sjsoftware/centurion-cpu6/misc/CPU6_Functional.jpg

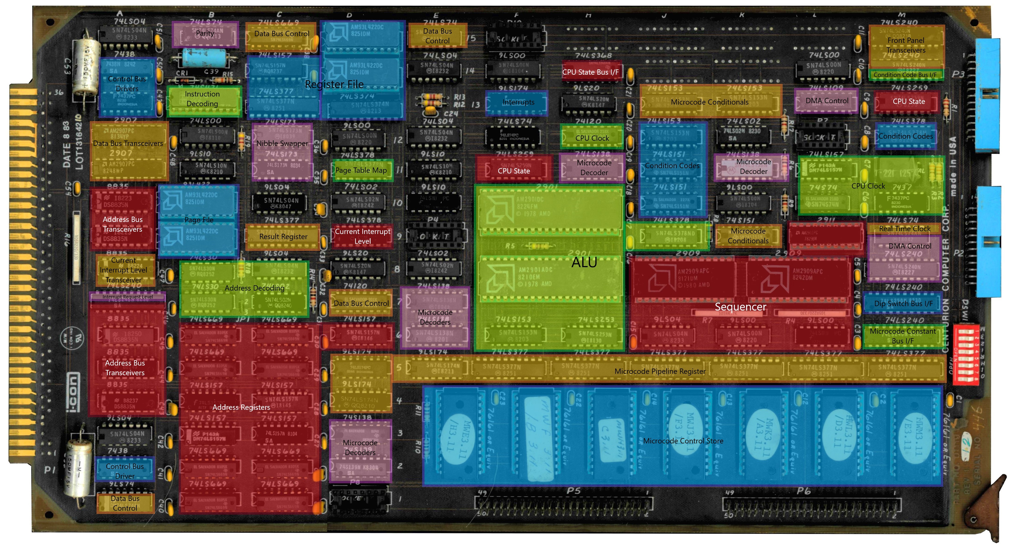
misc/CPU6_Functional.jpg
