sjsoftware/centurion-cpu6/README.md

# centurion-cpu6

* Schematic of the Centurion CPU6 board
* Schematic of the Centurion CPU5 boards
    * Original plus some revisions 
* Microcode disassembly (plus on wiki)
* Instruction reference (on wiki)
* Whatever I add in
