sjsoftware/centurion-cpu6/kicad/CPU5/README.md

# CPU 5 Reverse Engineering

Use at your own risk

The schematics are a bit of a mess, I wanted to get them to fit on A1 paper. If you have suggestions for
improvement, raise an issue.
