sjsoftware/centurion-cpu6/TODO.md

# TODO

An incomplete list of things

* Figure out CPU timing
* More documentation
* More disassembly
* More cards
