sjsoftware/centurion-cpu6/(threads)

Thread 5 (2022-04-28):

Add aliases for 7437, 7438 and '669

sjsoftware, 2022-04-28:
Replace LS versions and '169 in schematic

sjsoftware, 2022-06-13:
Done

Closed 2022-06-13.

Thread 6 (2022-05-12):

Schematic naming conventions

TemptorSent, 2022-05-12:
Renames for consistency, designation by grid location of pin1:

ALU0 (UF10) -> UF7 + label "ALU0"
ALU1 (UF11) -> UF9 + label "ALU1"

Seq0 (U?) -> UJ7 + label "Seq0"
Seq1 (U?) -> UK7 + label "Seq1"
Seq2 (UL9) -> UL9 + label "Seq2"

sjsoftware, 2022-06-13:
Board positions updated

Closed 2022-06-13.

Thread 7 (2023-10-10):

UE7 pins A0, A1 are label PL13, PL14 but are not actually wired.

charlesUnixPro, 2023-10-10:
UE7 pins A0, A1 are label PL13, PL14 but are not actually wired.
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

sjsoftware, 2023-11-11:
Fixed labels

Closed 2023-11-11.

Thread 8 (2023-10-13):

6309 pin names.

charlesUnixPro, 2023-10-13:
The 6309 at UB13 has pins 15 and 16 labeled "E1" and "E2".

According to "1978 MMI Bipolar LSI Databook, 1 t ed.", the should be "/E1" and "/E2"  ("NOT Enable").

sjsoftware, 2023-11-11:
Fixed symbol

Closed 2023-11-11.
