sjsoftware/centurion-cpu6/pdf/CPU5PA.pdf

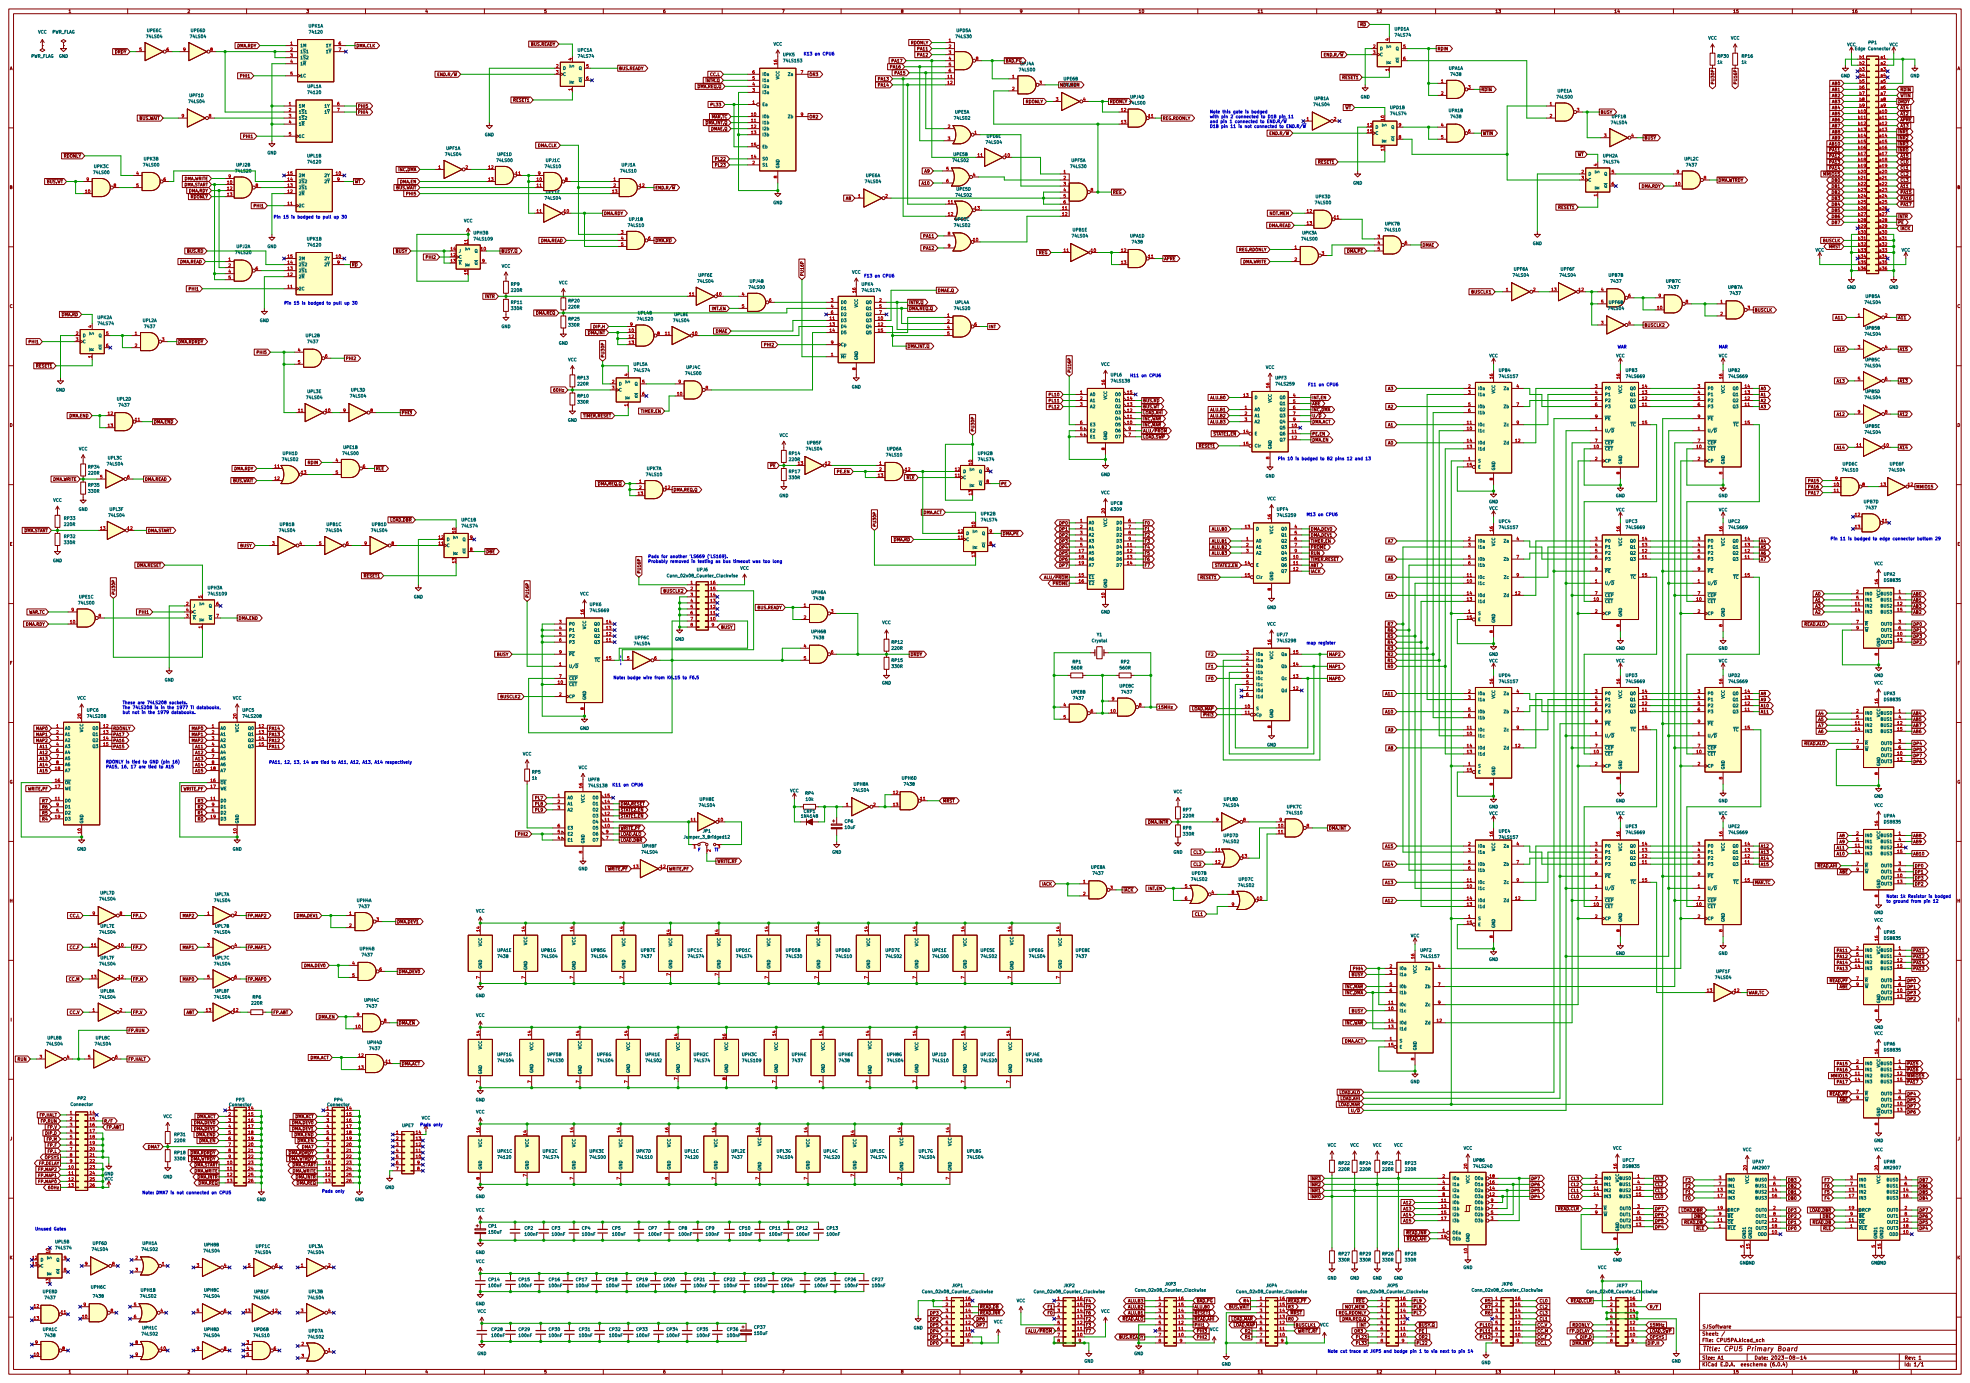
[picture p2: page 1]

~{DMA.REQ.Q} PL33 BUS.READY

~{DMA.INT.Q} CC.L ~{MAR.TC}
~{INTR.Q}

Note this gate is bodged
with pin 2 connected to D1B pin 11
and pin 1 connected to END.R/~{W}
D1B pin 11 is not connected to END.R/~{W}

DMA.START DMA.WRITE

Pin 15 is bodged to pull up 30

~{BUS.RD} DMA.READ

Pin 10 is bodged to B2 pins 12 and 13 M13 on CPU6 Note: bodge wire from K6.15 to F6.5 These are 74LS208 sockets. The 74LS208 is in the 1977 TI databooks, but not in the 1979 databooks.

ALU/~{PROM} DP2 DP3 DP1 DP4 DP0 WRITE.PF A12 A13

Pin 11 is bodged to edge connector bottom 29

~{TIMER.RESET} ABT RUN

F RDONLY is tied to GND (pin 16) PA15, 16, 17 are tied to A15

PA11, 12, 13, 14 are tied to A11, A12, A13, A14 respectively

~{MAR.TC} A15 WAR.TC

Note: 1k Resistor is bodged
to ground from pin 12

FP.HALT
~{READ.DB} FP.RUN
FP.V DIP.D

~{DMA.WTRDY}
~{DMA.START}
~{DMA.INTR} DMA.WRITE

~{DMA.START} DMA.WRITE

Note: DMA7 is not connected on CPU5

~{DMA.INT} FP.DELAY

Note cut trace at JKP5 and bodge pin 1 to via next to pin 14

Id: 1/1 Title: CPU5 Primary Board
