sjsoftware/centurion-cpu6/pdf/CPU5SA.pdf

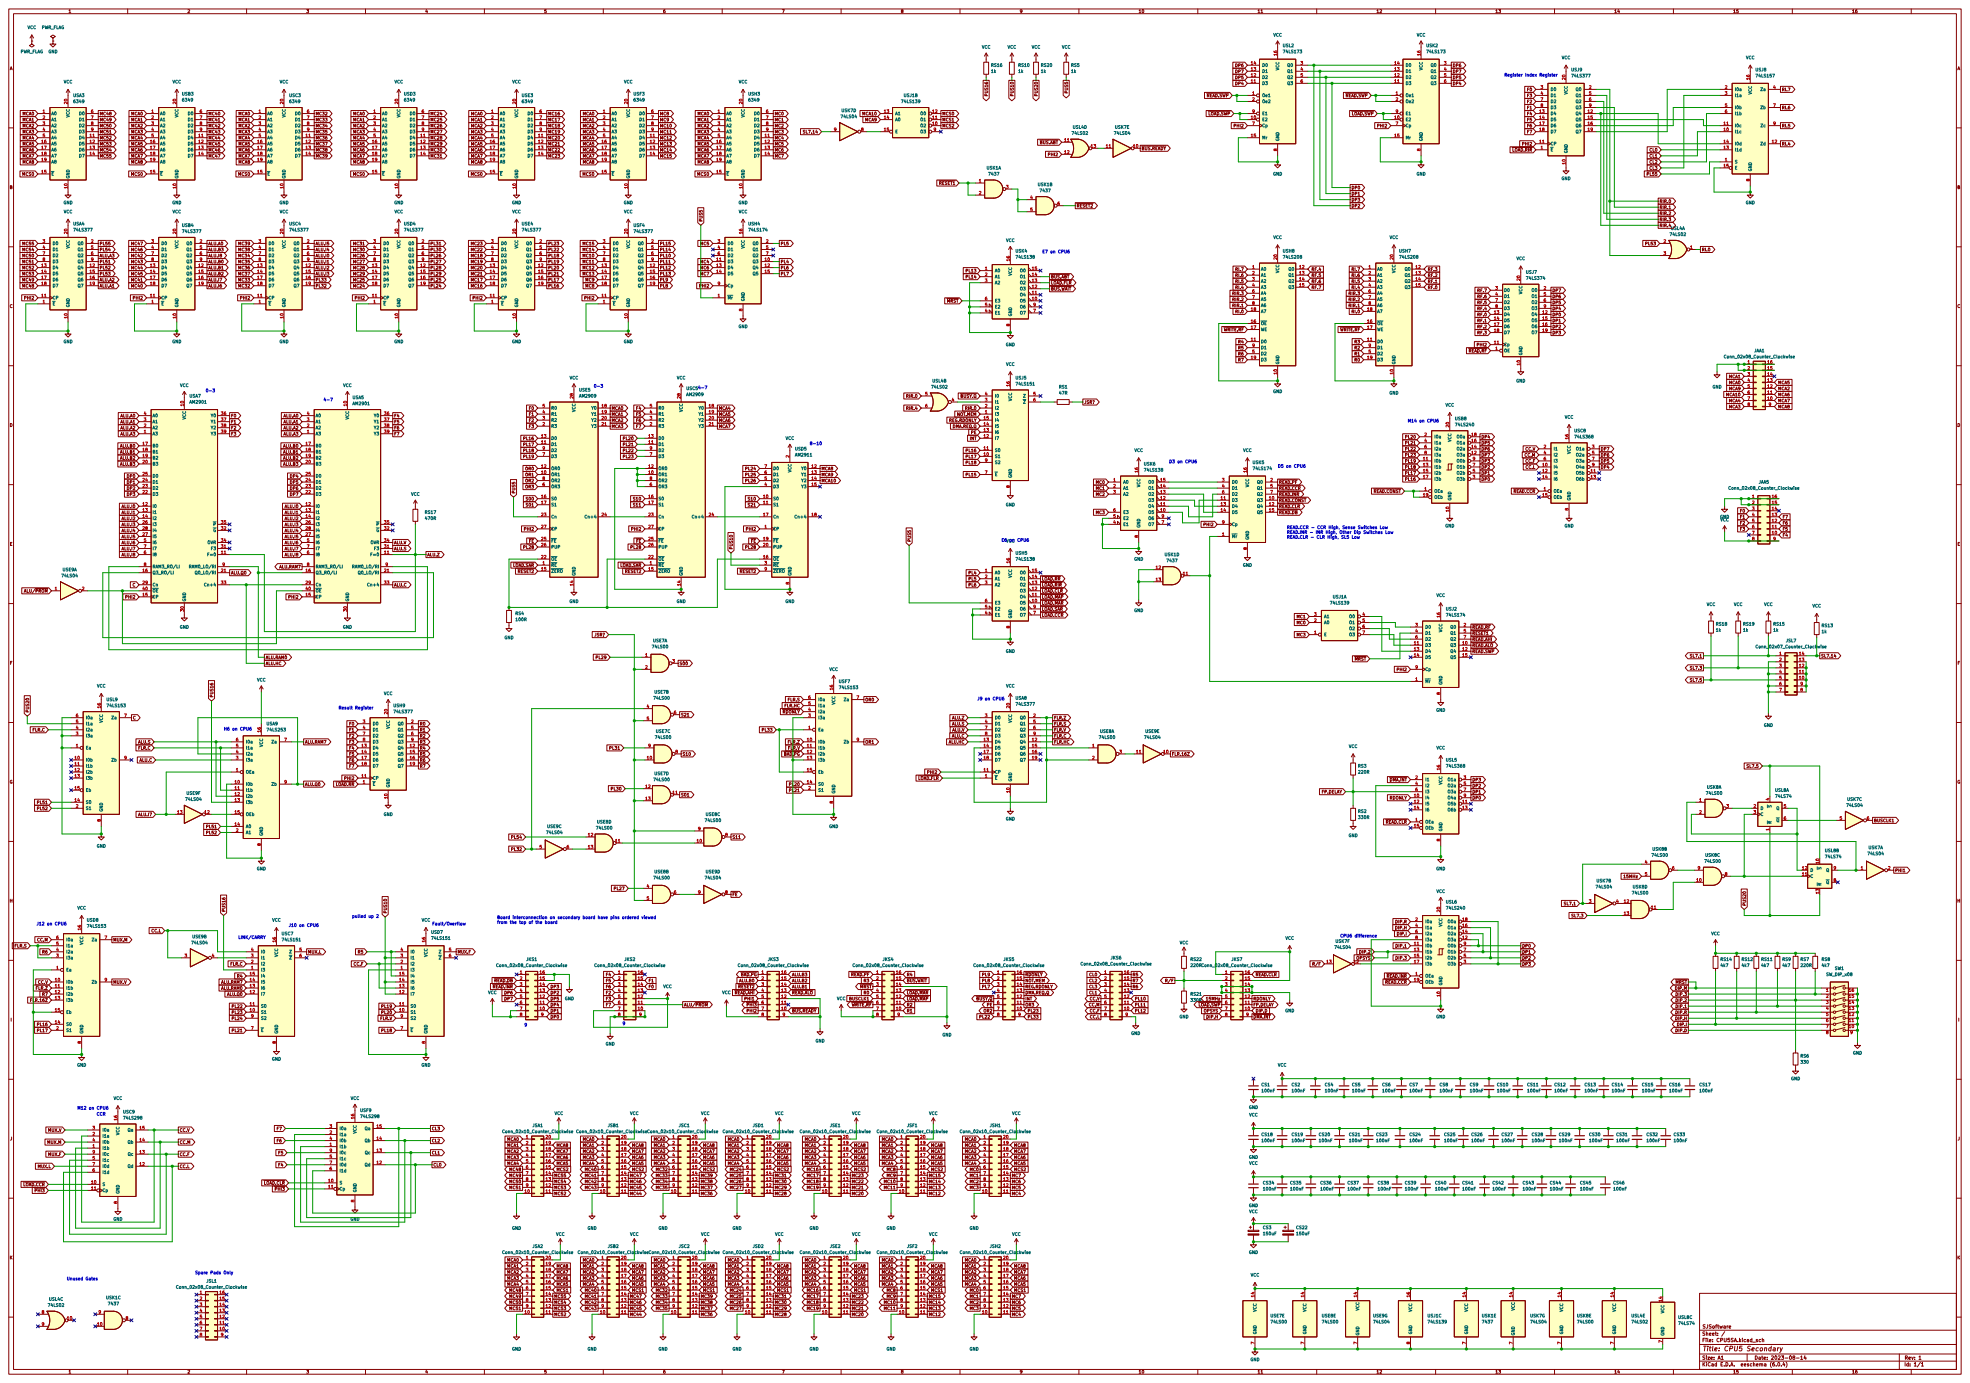
[picture p3: page 1]

Register Index Register E7 on CPU6

ALU.A0 ALU.I8 ALU.B3 ALU.B0 MC49 MC54

CL1 CL2 CL0 RIR.2 RIR.3 RIR.1 RIR.0

~{READ.CCR} CC.L CC.M

READ.CCR - CCR High, Sense Switches Low
READ.INR - INR High, Other Dip Switches Low

ALU.I5 ALU.I8 ALU.I6 ALU.I7 ALU.RAM7

Board interconnection on secondary board have pins ordered viewed
from the top of the board

CC.L ~{LOAD.CCR} MUX.LMUX.F

Spare Pads Only Unused Gates
