sjsoftware/centurion-cpu6/pdf/CPU6.pdf

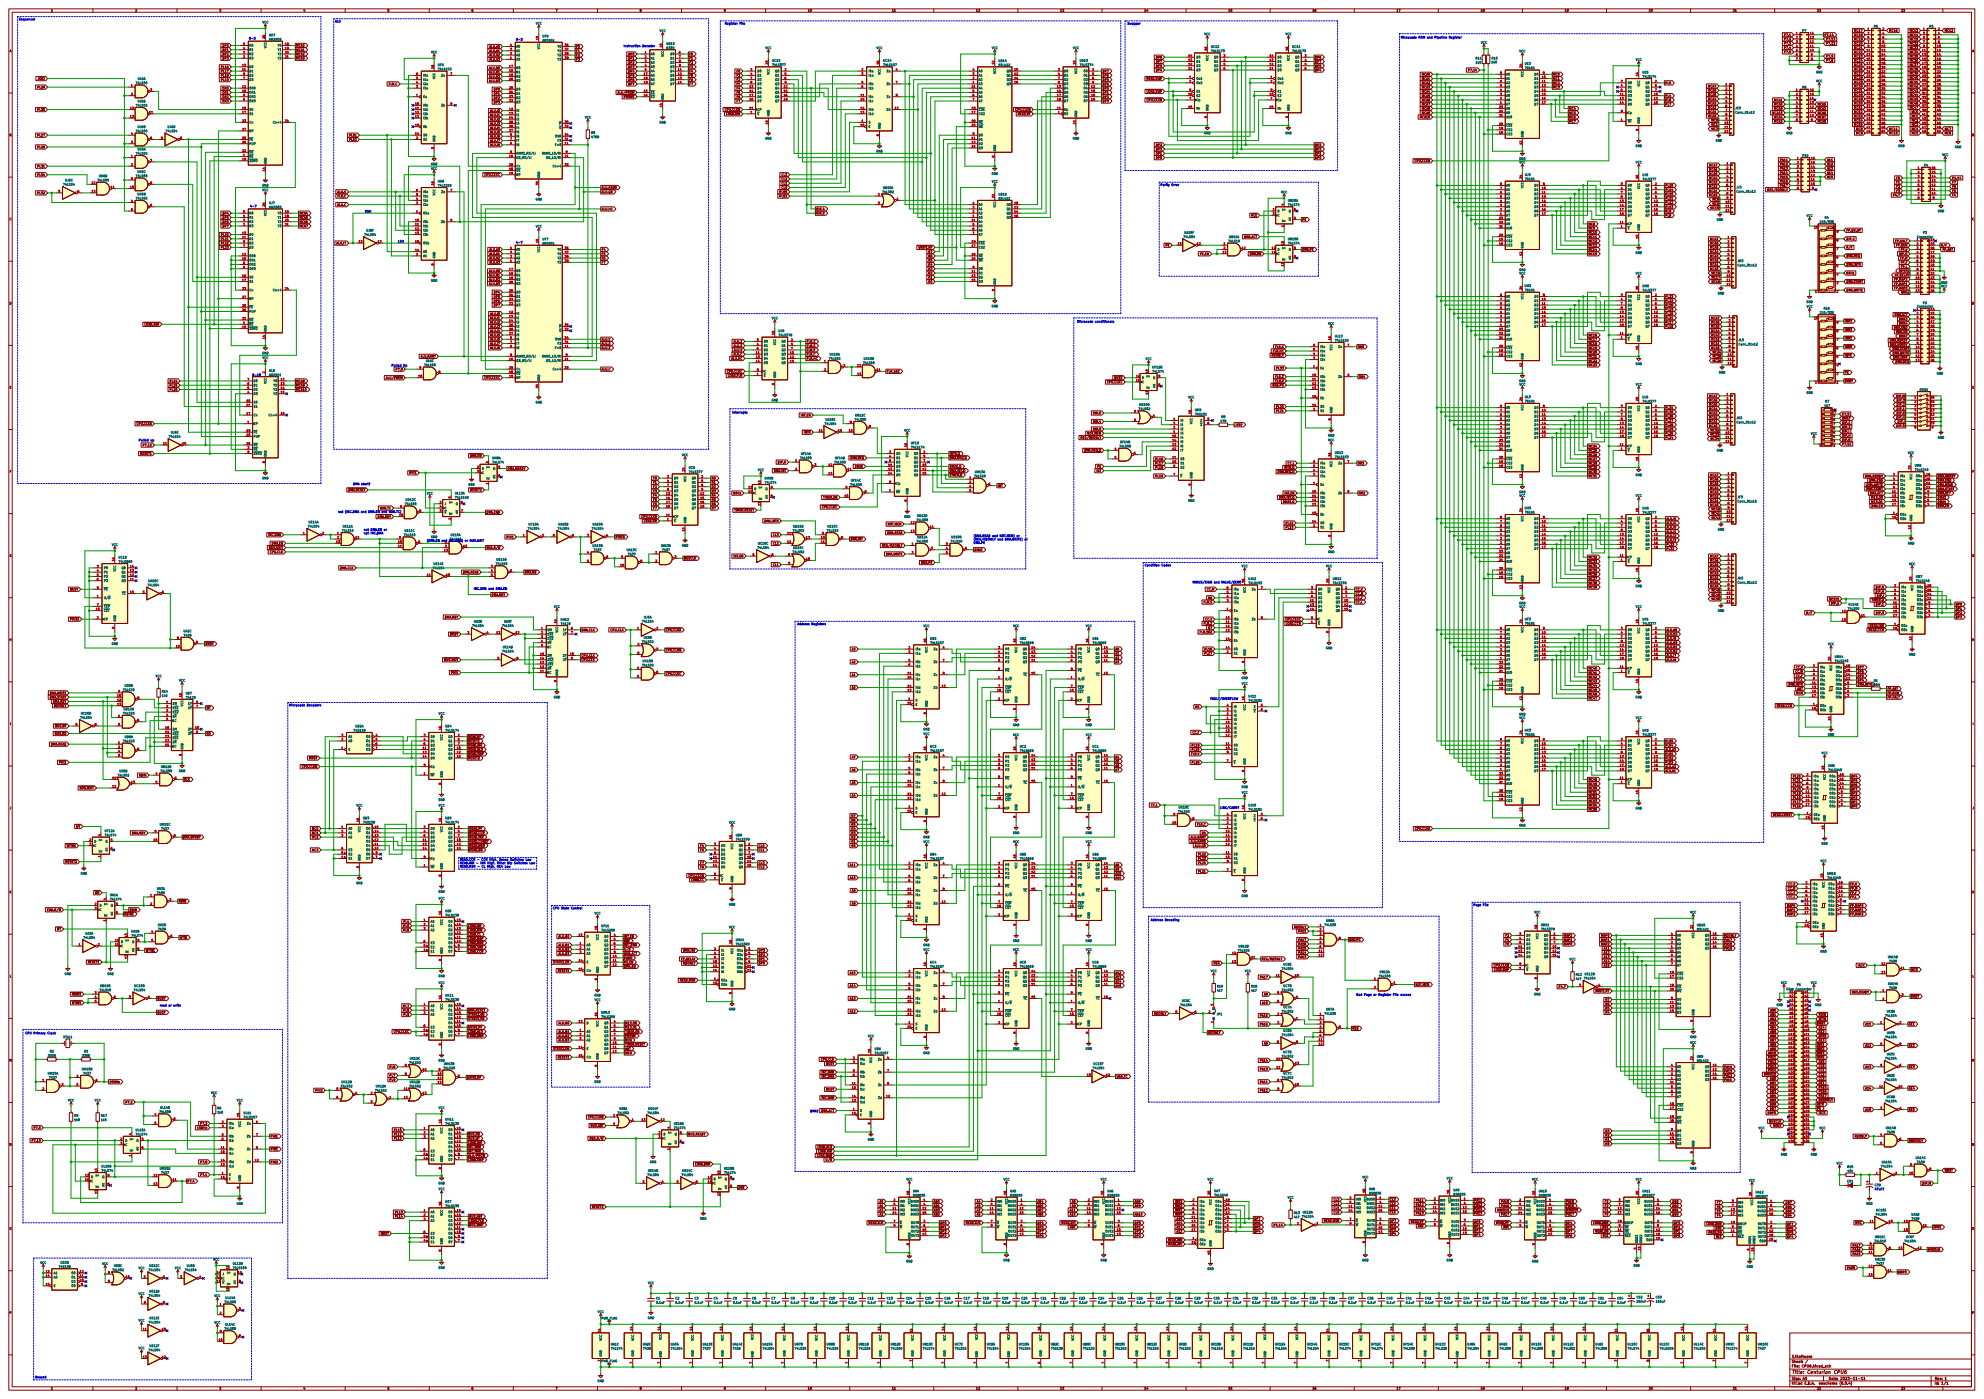
[picture p4: page 1]

Microcode ROM and Pipeline Register

~{DMA.EN} ALU.B1 ALU.A1 ALU.B3
ALU.A2

~{DMA.REQ.Q} PL21 ~{LOAD.SAR}

~{LOAD.FLR} ALU.Z ALU.V

~{DMA.WTRDY}
~{DMA.START} DMA.WRITE

~{DMA.REQ.Q} NOT.MEM
REG/RDONLY

~{DMA.RD} DMA.END

~{DMA.START} DMA.WRITE DMA.RDRDY
DMA.ACT DMA.END

~{DMA.RDRDY}
~{DMA.END} DMA.READ

not (INC.DMA and DMA.EN and WAR.TC)

DMA.WRITE NOT.MEM

not DMA.EN or not INC.DMA

(DMA.READ and NOT.MEM) or
(REG/RDONLY and DMA.WRITE) or DMA.PE

(DMA.EN and INC.DMA) or BUS.WAIT

CPU.CLK DMA.EN

MINUS/SIGN and VALUE/ZERO

INC.DMA and DMA.EN

DMA.WRITE
~{PHI1} DMA.START DMA.READ
~{RDONLY} DMA.RDY

READ.CCR - CCR High, Sense Switches Low
READ.INR - INR High, Other Dip Switches Low
READ.MSR - CL High, H14 Low

Bad Page or Register File access

File: CPU6.kicad_sch Sheet: / SJSoftware VCC 14 GND
