sjsoftware/centurion-cpu6/kicad/CPU5/SRAM_Breakout/CPUBR.kicad_pcb

## KiCad design kicad/CPU5/SRAM_Breakout/CPUBR.kicad_pcb (2023-12-06)

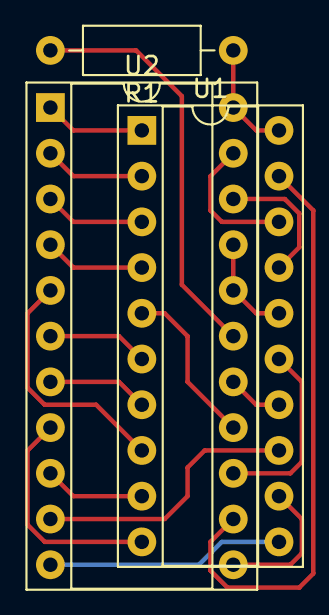
[picture p5: board CPUBR.kicad_pcb from above]

Board: 2 copper layers, 3 parts (0 on the bottom side), 21 nets.

Parts:
R1: 1k; R_Axial_DIN0207_L6.3mm_D2.5mm_P10.16mm_Horizontal
U1: 74LS208; DIP-20_W7.62mm_Socket
U2: 93L422; DIP-22_W10.16mm_Socket

Connections:
GND: U1.10 (GND), U2.8 (GND)
unnamed: U1.11 (D0), U2.11 (D1)
unnamed: U1.14 (Q2), U2.16 (Q3)
unnamed: U1.16 (~OE), U2.18 (~OE), U2.19 (~CS1)
unnamed: U1.17 (WE), U2.20 (~WE)
unnamed: U1.18 (A7), U2.21 (A4)
unnamed: U1.19 (D3), U2.13 (D2)
unnamed: U1.1 (A0), U2.1 (A3)
unnamed: U1.2 (A1), U2.2 (A2)
unnamed: U1.3 (A2), U2.3 (A1)
unnamed: U1.4 (A3), U2.4 (A0)
unnamed: U1.8 (A6), U2.5 (A5)
unnamed: U1.6 (A4), U2.6 (A6)
unnamed: U1.7 (A5), U2.7 (A7)
unnamed: U1.9 (D1), U2.9 (D0)
unnamed: U1.13 (Q1), U2.10 (Q0)
unnamed: U1.12 (Q0), U2.12 (Q1)
unnamed: U1.15 (Q3), U2.14 (Q2)
unnamed: U1.5 (D2), U2.15 (D3)
unnamed: R1.2, U2.17 (CS2)
VCC: R1.1, U1.20 (VCC), U2.22 (VCC)
