sjsoftware/centurion-cpu6/kicad/CPU6/CPU6.kicad_sch

## KiCad design kicad/CPU6/CPU6.kicad_sch (2023-11-11)

Schematic: CPU6.kicad_sch

Parts:
C1, C2, C3, C4, C5, C6, C7, C8, C9, C10, C11, C12, C13, C14, C15, C16, C17, C18, C19, C20, C21, C22, C23, C24, C25, C26, C27, C28, C29, C30, C31, C32, C33, C34, C35, C36, C37, C38, C40, C41, C42, C43, C44, C45, C46, C47, C48, C49, C50, C51: 0.1uF; C_Disc_D3.8mm_W2.6mm_P2.50mm
C39: C_Polarized_US; CP_Axial_L18.0mm_D6.5mm_P25.00mm_Horizontal
C52, C53: 150uF; CP_Axial_L29.0mm_D10.0mm_P35.00mm_Horizontal
C54: 0.1uF; C_Disc_D3.0mm_W1.6mm_P2.50mm
CR1: D_Filled; D_DO-35_SOD27_P10.16mm_Horizontal
DSW1: SW_DIP_x08; DIP-16_W7.62mm
JE3: Conn_01x12; PinSocket_1x12_P2.54mm_Vertical
JF3: Conn_01x12; PinSocket_1x12_P2.54mm_Vertical
JH3: Conn_01x12; PinSocket_1x12_P2.54mm_Vertical
JJ3: Conn_01x12; PinSocket_1x12_P2.54mm_Vertical
JK3: Conn_01x12; PinSocket_1x12_P2.54mm_Vertical
JL3: Conn_01x12; PinSocket_1x12_P2.54mm_Vertical
JM3: Conn_01x12; PinSocket_1x12_P2.54mm_Vertical
JP1: Jumper_3_Bridged23; PinHeader_1x03_P2.54mm_Vertical
P1: Edge Connector; Centurion_card_edge
P2, P3: Connector; IDC-Header_2x13_P2.54mm_Horizontal
P4, P8, P10: Conn_02x08_Counter_Clockwise; PinSocket_2x08_P2.54mm_Vertical
P5, P6: Conn_02x25_Odd_Even; IDC-Header_2x25_P2.54mm_Vertical
P7: Conn_02x07_Counter_Clockwise; PinSocket_2x07_P2.54mm_Vertical
R1: 220R; R_Axial_DIN0207_L6.3mm_D2.5mm_P10.16mm_Horizontal
R2, R3: 330R; R_Axial_DIN0207_L6.3mm_D2.5mm_P10.16mm_Horizontal
R4, R16: 220/330; R_Array_SIP10
R5: 470R; R_Axial_DIN0207_L6.3mm_D2.5mm_P10.16mm_Horizontal
R6, R9, R10, R11, R14, R17: 1k0; R_Axial_DIN0207_L6.3mm_D2.5mm_P10.16mm_Horizontal
R7: 4k7; R_Array_SIP10
R8: 47R; R_Axial_DIN0207_L6.3mm_D2.5mm_P10.16mm_Horizontal
R12, R13, R18, R19: 4k7; R_Axial_DIN0207_L6.3mm_D2.5mm_P10.16mm_Horizontal
R15: 10k; R_Axial_DIN0207_L6.3mm_D2.5mm_P10.16mm_Horizontal
UA1: 74LS74; DIP-14_W7.62mm
UA2, UA14: 7438; DIP-14_W7.62mm
UA3, UA15: 74LS04; DIP-14_W7.62mm
UA4, UA5, UA6, UA8, UA9, UA10: DS8835; DIP-16_W7.62mm
UA7: 74LS240; DIP-20_W7.62mm
UA11, UA12: AM2907; DIP-20_W7.62mm
UA13: 7437; DIP-14_W7.62mm
UB1, UB2, UB5, UB6: 74LS669; DIP-16_W7.62mm
UB3, UB4: 74LS157; DIP-16_W7.62mm
UB7, UB8: 74LS30; DIP-14_W7.62mm
UB9, UB10: 93L422; DIP-22_W7.62mm
UB11: 74LS10; DIP-14_W7.62mm
UB12: 74LS00; DIP-14_W7.62mm
UB13: 6309; DIP-20_W7.62mm
UB15: 74LS74; DIP-14_W7.62mm
UC1, UC2, UC5, UC6, UC15: 74LS669; DIP-16_W7.62mm
UC3, UC4, UC14: 74LS157; DIP-16_W7.62mm
UC7: 74LS02; DIP-14_W7.62mm
UC8, UC10: 74LS04; DIP-14_W7.62mm
UC9, UC13: 74LS377; DIP-20_W7.62mm
UC11, UC12: 74LS173; DIP-16_W7.62mm
UD2: 74S139; DIP-16_W7.62mm
UD3: 74S138; DIP-16_W7.62mm
UD4, UD5: 74LS174; DIP-16_W7.62mm
UD6: 74LS157; DIP-16_W7.62mm
UD7: 74120; DIP-16_W7.62mm
UD8: 74LS20; DIP-14_W7.62mm
UD9, UD11: 74LS378; DIP-16_W7.62mm
UD10: 74LS02; DIP-14_W7.62mm
UD12: 74LS00; DIP-14_W7.62mm
UD13: 74LS374; DIP-20_W7.62mm
UD14, UD15: 93L422; DIP-22_W7.62mm
UE3: 76161; DIP-24_W7.62mm
UE5: 74LS174; DIP-16_W7.62mm
UE6, UE7: 74LS138; DIP-16_W7.62mm
UE8: 74LS02; DIP-14_W7.62mm
UE10, UE11: 74LS10; DIP-14_W7.62mm
UE12, UE14: 74LS04; DIP-14_W7.62mm
UE15: 74LS74; DIP-14_W7.62mm
UF3: 76161; DIP-24_W7.62mm
UF5: 74LS377; DIP-20_W7.62mm
UF6: 74LS153; DIP-16_W7.62mm
UF7, UF9: AM2901; DIP-40_W15.24mm
UF11: 74LS259; DIP-16_W7.62mm
UF12: 74LS74; DIP-14_W7.62mm
UF13: 74LS174; DIP-16_W7.62mm
UF14: 74LS00; DIP-14_W7.62mm
UH3: 76161; DIP-24_W7.62mm
UH5: 74LS377; DIP-20_W7.62mm
UH6: 74LS253; DIP-16_W7.62mm
UH11: 74LS138; DIP-16_W7.62mm
UH12: 74120; DIP-16_W7.62mm
UH13: 74LS20; DIP-14_W7.62mm
UH14: 74LS368; DIP-16_W7.62mm
UJ3: 76161; DIP-24_W7.62mm
UJ5: 74LS377; DIP-20_W7.62mm
UJ6: 74LS04; DIP-14_W7.62mm
UJ7: AM2909; DIP-28_W7.62mm
UJ9: 74LS378; DIP-16_W7.62mm
UJ10, UJ11: 74LS151; DIP-16_W7.62mm
UJ12, UJ13: 74LS153; DIP-16_W7.62mm
UK3: 76161; DIP-24_W7.62mm
UK5: 74LS377; DIP-20_W7.62mm
UK6, UK10: 74LS00; DIP-14_W7.62mm
UK7: AM2909; DIP-28_W7.62mm
UK9: 74S151; DIP-16_W7.62mm
UK11: 74LS138; DIP-16_W7.62mm
UK12: 74LS02; DIP-14_W7.62mm
UK13: 74LS153; DIP-16_W7.62mm
UL3: 76161; DIP-24_W7.62mm
UL5: 74LS377; DIP-20_W7.62mm
UL6, UL14: 74LS00; DIP-14_W7.62mm
UL9: AM2911; DIP-20_W7.62mm
UL10: 74LS74; DIP-14_W7.62mm
UL11: 74LS157; DIP-16_W7.62mm
UL13: 74LS109; DIP-16_W7.62mm
UM3: 76161; DIP-24_W7.62mm
UM5: 74LS377; DIP-20_W7.62mm
UM6, UM7, UM8, UM14, UM15: 74LS240; DIP-20_W7.62mm
UM9: 74LS74; DIP-14_W7.62mm
UM10: 7437; DIP-14_W7.62mm
UM12: 74LS378; DIP-16_W7.62mm
UM13: 74LS259; DIP-16_W7.62mm
XTAL1: Crystal; Crystal_DS15_D1.5mm_L5.0mm_Horizontal

Connections:
15MHz: R3.2, UL11.3 (I1a), UM10.6, XTAL1.2
60Hz: P3.13, R4.4 (R3), UM9.11 (C)
A0: UA4.2 (IN0), UB1.14 (Q0), UB3.14 (I0d)
A1: UA4.5 (IN1), UB1.13 (Q1), UB3.11 (I0c)
A2: UA4.14 (IN3), UB1.12 (Q2), UB3.5 (I0b)
A3: UA4.11 (IN2), UB1.11 (Q3), UB3.2 (I0a)
A4: UA5.2 (IN0), UC1.14 (Q0), UC3.14 (I0d)
A5: UA5.5 (IN1), UC1.13 (Q1), UC3.11 (I0c)
A6: UA5.14 (IN3), UC1.12 (Q2), UC3.5 (I0b)
A7: UA5.11 (IN2), UC1.11 (Q3), UC3.2 (I0a)
A8: UA6.2 (IN0), UB4.14 (I0d), UB6.14 (Q0), UC8.9
A9: UA6.5 (IN1), UB4.11 (I0c), UB6.13 (Q1), UC7.5
A10: UA6.14 (IN3), UB4.5 (I0b), UB6.12 (Q2), UC7.6
A11: P10.16, UA6.11 (IN2), UB4.2 (I0a), UB6.11 (Q3), UB9.1 (A3), UB10.1 (A3), UC8.1
A12: P10.15, UA3.9, UA7.17 (I3b), UB9.21 (A4), UB10.21 (A4), UC4.14 (I0d), UC6.14 (Q0)
A13: P10.14, UA3.5, UA7.15 (I2b), UB9.5 (A5), UB10.5 (A5), UC4.11 (I0c), UC6.13 (Q1)
A14: P10.13, UA3.11, UA7.13 (I1b), UB9.6 (A6), UB10.6 (A6), UC4.5 (I0b), UC6.12 (Q2)
A15: P10.10, P10.11, P10.12, UA7.11 (I0b), UB9.7 (A7), UB10.7 (A7), UC4.2 (I0a), UC6.11 (Q3), UC8.3
AB0: P1.b5, UA4.1 (BUS0)
AB1: P1.b6, UA4.4 (BUS1)
AB2: P1.b7, UA4.15 (BUS3)
AB3: P1.b8, UA4.12 (BUS2)
AB4: P1.b9, UA5.1 (BUS0)
AB5: P1.b10, UA5.4 (BUS1)
AB6: P1.b11, UA5.15 (BUS3)
AB7: P1.b12, UA5.12 (BUS2)
AB8: P1.b13, UA6.1 (BUS0)
AB9: P1.b14, UA6.4 (BUS1)
AB10: P1.b15, UA6.15 (BUS3)
ABT: UM13.11 (Q6), UM14.13 (I1b)
ALU.A0: UF5.2 (Q0), UF7.4 (A0), UF9.4 (A0)
ALU.A1: UF7.3 (A1), UF9.3 (A1), UK5.19 (Q7)
ALU.A2: UF7.2 (A2), UF9.2 (A2), UK5.16 (Q6)
ALU.A3: UF7.1 (A3), UF9.1 (A3), UK5.6 (Q2)
ALU.B0: UF5.9 (Q3), UF7.17 (B0), UF9.17 (B0), UF11.13 (D), UM13.13 (D)
ALU.B1: UF5.12 (Q4), UF7.18 (B1), UF9.18 (B1), UF11.1 (A0), UM13.1 (A0)
ALU.B2: UF5.15 (Q5), UF7.19 (B2), UF9.19 (B2), UF11.2 (A1), UM13.2 (A1)
ALU.B3: UF5.5 (Q1), UF7.20 (B3), UF9.20 (B3), UF11.3 (A2), UM13.3 (A2)
ALU.C: UF7.33 (Cn+4), UH6.3 (I3a), UJ9.11 (D3)
ALU.HC: UF7.29 (Cn), UF9.33 (Cn+4), UJ9.13 (D4)
ALU.I0: UF7.12 (I0), UF9.12 (I0), UH5.6 (Q2)
ALU.I1: UF7.13 (I1), UF9.13 (I1), UH5.9 (Q3)
ALU.I2: UF7.14 (I2), UF9.14 (I2), UH5.12 (Q4)
ALU.I3: UF7.26 (I3), UF9.26 (I3), UH5.15 (Q5)
ALU.I4: UF7.28 (I4), UF9.28 (I4), UH5.5 (Q1)
ALU.I5: UF7.27 (I5), UF9.27 (I5), UH5.2 (Q0)
ALU.I6: UF5.19 (Q7), UF7.5 (I6), UF9.5 (I6)
ALU.I7: UF5.16 (Q6), UF7.7 (I7), UF9.7 (I7), UH6.1 (OEa), UJ6.13
ALU.I8: UF5.6 (Q2), UF7.6 (I8), UF9.6 (I8)
ALU.Q0: UF9.21 (Q0_LO/RI), UH6.4 (I2a), UH6.9 (Zb), UJ10.12 (I7)
ALU.RAM0: UF7.16 (Q3_RO/LI), UF9.9 (RAM0_LO/RI), UJ10.13 (I6)
ALU.RAM7: UF7.8 (RAM3_RO/LI), UH6.7 (Za), UJ10.14 (I5)
ALU.S: UF7.31 (F3), UH6.6 (I0a), UH6.12 (I2b), UJ9.4 (D1)
ALU.V: UF7.34 (OVR), UJ9.6 (D2)
ALU.Z: R5.2, UF7.11 (F=0), UF9.11 (F=0), UJ9.3 (D0)
ALU/~PROM: UB13.15 (~E1), UH11.9 (O6), UL6.10
BUS.READY: UA14.1, UA14.2, UE15.5 (Q)
BUSY: UB11.6, UC10.3, UC15.9 (~PE), UD6.10 (I1c)
CC.F: UJ11.2 (I2), UJ11.13 (I6), UM12.7 (Q2), UM14.6 (I2a), UM15.6 (I2a)
CC.L: UJ10.4 (I0), UK10.9, UK10.10, UK13.6 (I0a), UM12.10 (Q3), UM14.8 (I3a), UM15.8 (I3a)
CC.M: UJ12.6 (I0a), UM12.5 (Q1), UM14.4 (I1a), UM15.4 (I1a)
CC.V: UJ12.10 (I0b), UM12.2 (Q0), UM14.2 (I0a), UM15.2 (I0a)
CL0: UA8.14 (IN3), UC14.13 (I1d), UD9.2 (Q0)
CL1: UA8.11 (IN2), UC14.10 (I1c), UD9.5 (Q1), UD10.9
CL2: UA8.5 (IN1), UC14.6 (I1b), UD9.15 (Q5), UD10.12
CL3: UA8.2 (IN0), UC14.3 (I1a), UD9.12 (Q4), UD10.11
CPU.CLK: UE8.5, UE8.6, UE10.13, UH12.10 (2Y), UJ6.1, UK10.4, UK10.5
DB0: P1.b21, UA11.16 (BUS3)
DB1: P1.b22, UA11.14 (BUS2)
DB2: P1.b23, UA11.6 (BUS1)
DB3: P1.b24, UA11.4 (BUS0)
DB4: P1.b25, UA12.16 (BUS3)
DB5: P1.b26, UA12.14 (BUS2)
DB6: P1.b27, UA12.6 (BUS1)
DB7: P1.b28, UA12.4 (BUS0)
DBPO: P1.b29, UA13.11
DIP.1: DSW1.4, R7.7 (R6), UM7.11 (I0b)
DIP.2: DSW1.3, P3.8, R4.8 (R7), UM7.13 (I1b)
DIP.3: DSW1.2, R7.6 (R5), UM7.15 (I2b)
DIP.H: DSW1.6, R7.4 (R3), UF14.1, UM7.4 (I1a)
DIP.I: DSW1.7, R7.5 (R4), UM7.6 (I2a)
DIP.M: DSW1.1, P1.b32, UA14.8, UD4.4 (D1), UD4.14 (D5), UE7.6 (E3)
DIP.O: DSW1.8, P3.4
DIP.R: DSW1.5, R7.3 (R2), UM7.2 (I0a)
DMA3: P2.3, UM8.7 (O1b)
DMA4: P2.4, UM8.5 (O2b)
DMA7: P2.7, R7.8 (R7)
DMA.ACT: UB15.10 (~S), UD6.1 (S), UF11.9 (Q4), UM8.11 (I0b)
DMA.CLK: UE10.2, UE11.3, UH12.6 (1Y)
DMA.EN: UE11.13, UF11.12 (Q7), UM8.17 (I3b)
DMA.END: UL13.7 (~Q), UM8.4 (I1a)
DMA.INTR: UE10.9, UM14.9 (O0b)
DMA.RDRDY: UM8.2 (I0a), UM9.5 (Q)
DMA.RDY: UD8.2, UD8.12, UD12.10, UE8.11, UE11.5, UE14.10, UH12.1 (1M), UM10.9
DMA.READ: UD8.1, UD12.13, UE11.4, UM8.14 (O2a)
DMA.START: UD8.4, UD8.5, UD8.10, UM8.12 (O3a)
DMA.WRITE: P2.11, R4.2 (R1), UD8.9, UD12.2, UM8.6 (I2a)
DMAE: UE10.6, UF13.11 (D3)
DMAE.Q: UF13.10 (Q3), UK13.12 (I2b)
DP0: UA4.3 (OUT0), UA6.3 (OUT0), UA9.3 (OUT0), UA11.18 (OUT3), UB13.1 (A0), UC11.11 (D3), UC12.6 (Q3), UD13.12 (O4), UF9.25 (D0), UH14.9 (O4a), UK7.5 (R0), UM6.3 (O3b), UM7.9 (O0b), UM7.12 (O3a)
DP1: UA4.6 (OUT1), UA6.6 (OUT1), UA9.6 (OUT1), UA11.12 (OUT2), UB13.2 (A1), UC11.12 (D2), UC12.5 (Q2), UD13.15 (O5), UF9.24 (D1), UH14.7 (O3a), UK7.4 (R1), UM6.5 (O2b), UM7.7 (O1b), UM7.14 (O2a)
DP2: UA4.13 (OUT3), UA6.13 (OUT3), UA11.8 (OUT1), UB13.3 (A2), UC11.14 (D0), UC12.3 (Q0), UD13.16 (O6), UF9.23 (D2), UH14.5 (O2a), UK7.3 (R2), UM6.7 (O1b), UM7.5 (O2b), UM7.16 (O1a)
DP3: UA4.10 (OUT2), UA6.10 (OUT2), UA9.10 (OUT2), UA11.2 (OUT0), UB13.4 (A3), UC11.13 (D1), UC12.4 (Q1), UD13.19 (O7), UF9.22 (D3), UH14.3 (O1a), UK7.2 (R3), UM6.9 (O0b), UM7.3 (O3b), UM7.18 (O0a)
DP4: UA5.3 (OUT0), UA7.3 (O3b), UA7.12 (O3a), UA8.13 (OUT3), UA9.13 (OUT3), UA10.3 (OUT0), UA12.18 (OUT3), UB13.5 (A4), UC11.6 (Q3), UC12.11 (D3), UD13.9 (O3), UF7.25 (D0), UJ7.5 (R0), UM6.18 (O0a), UM14.12 (O3a)
DP5: UA5.6 (OUT1), UA7.5 (O2b), UA7.14 (O2a), UA8.10 (OUT2), UA10.6 (OUT1), UA12.12 (OUT2), UB13.17 (A5), UC11.5 (Q2), UC12.12 (D2), UD13.6 (O2), UF7.24 (D1), UJ7.4 (R1), UM6.16 (O1a), UM14.14 (O2a)
DP6: UA5.13 (OUT3), UA7.7 (O1b), UA7.16 (O1a), UA8.6 (OUT1), UA10.13 (OUT3), UA12.8 (OUT1), UB13.18 (A6), UC11.3 (Q0), UC12.14 (D0), UD13.5 (O1), UF7.23 (D2), UJ7.3 (R2), UM6.14 (O2a), UM14.16 (O1a)
DP7: UA5.10 (OUT2), UA7.9 (O0b), UA7.18 (O0a), UA8.3 (OUT0), UA10.10 (OUT2), UA12.2 (OUT0), UB13.19 (A7), UC11.4 (Q1), UC12.13 (D1), UD13.2 (O0), UF7.22 (D3), UJ7.2 (R3), UM6.12 (O3a), UM14.18 (O0a)
END.R/~W: UA1.3 (C), UA3.1, UE10.12, UE14.3, UE15.3 (C)
F0: P4.3, UA11.17 (IN3), UB13.6 (D0), UC9.3 (D0), UC13.3 (D0), UD11.6 (D2), UF9.36 (Y0)
F1: P4.4, UA11.13 (IN2), UB13.7 (D1), UC9.4 (D1), UC13.8 (D3), UD11.4 (D1), UF9.37 (Y1)
F2: P4.5, UA11.7 (IN1), UB13.8 (D2), UC9.7 (D2), UC13.7 (D2), UD11.3 (D0), UF9.38 (Y2)
F3: P4.6, UA11.3 (IN0), UB13.9 (D3), UC9.8 (D3), UC13.4 (D1), UF9.39 (Y3)
F4: P4.10, UA12.17 (IN3), UB13.11 (D4), UC9.13 (D4), UC13.13 (D4), UD9.3 (D0), UF7.36 (Y0)
F5: P4.11, UA12.13 (IN2), UB13.12 (D5), UC9.14 (D5), UC13.14 (D5), UD9.4 (D1), UF7.37 (Y1)
F6: P4.12, UA12.7 (IN1), UB13.13 (D6), UC9.17 (D6), UC13.17 (D6), UD9.14 (D5), UF7.38 (Y2)
F7: P4.13, UA12.3 (IN0), UB13.14 (D7), UC9.18 (D7), UC13.18 (D7), UD9.13 (D4), UF7.39 (Y3)
FLR.16Z: UJ12.13 (I3b), UK10.11
FLR.C: UF6.4 (I2a), UH6.5 (I1a), UH6.11 (I1b), UJ9.10 (Q3), UJ10.2 (I2)
FLR.HC: UJ9.12 (Q4), UJ13.5 (I1a)
FLR.S: UJ9.5 (Q1), UJ12.3 (I3a), UJ12.5 (I1a), UJ13.6 (I0a)
FLR.V: UJ9.7 (Q2), UJ11.9 (S2), UJ13.11 (I1b)
FLR.Z: UJ9.2 (Q0), UJ9.14 (D5), UJ12.11 (I1b), UJ13.10 (I0b), UK10.2
FP.ABT: P3.16, R1.2
FP.DELAY: P3.9, R4.9 (R8), UH14.6 (I3)
FP.F: P3.6, UM15.14 (O2a)
FP.HALT: P3.1, UM14.3 (O3b)
FP.L: P3.7, UM15.12 (O3a)
FP.M: P3.5, UM15.16 (O1a)
FP.MAP0: P3.12, UM15.7 (O1b)
FP.MAP1: P3.11, UM15.5 (O2b)
FP.MAP2: P3.10, UM15.3 (O3b)
FP.RUN: P3.2, UM14.5 (O2b), UM14.17 (I3b)
FP.V: P3.3, UM15.18 (O0a)
GND: C1.2, C2.2, C3.2, C4.2, C5.2, C6.2, C7.2, C8.2, C9.2, C10.2, C11.2, C12.2, C13.2, C14.2, C15.2, C16.2, C17.2, C18.2, C19.2, C20.2, C21.2, C22.2, C23.2, C24.2, C25.2, C26.2, C27.2, C28.2, C29.2, C30.2, C31.2, C32.2, C33.2, C34.2, C35.2, C36.2, C37.2, C38.2, C39.2, C40.2, C41.2, C42.2, C43.2, C44.2, C45.2, C46.2, C47.2, C48.2, C49.2, C50.2, C51.2, C52.2, C53.2, C54.2, DSW1.9, DSW1.10, DSW1.11, DSW1.12, DSW1.13, DSW1.14, DSW1.15, DSW1.16, JE3.12, JF3.12, JH3.12, JJ3.12, JK3.12, JL3.12, JM3.12, P1.a1, P1.a36, P1.b1, P1.b36, P2.14, P2.15, P2.16, P2.17, P2.18, P2.19, P2.20, P2.21, P2.22, P2.23, P2.24, P2.25, P2.26, P3.17, P3.18, P3.19, P3.20, P3.21, P4.1, P4.2, P4.15, P4.16, P5.4, P5.6, P5.8, P5.10, P5.12, P5.14, P5.16, P5.18, P5.20, P5.22, P5.24, P5.26, P5.28, P5.30, P5.32, P5.34, P5.36, P5.38, P5.40, P5.42, P5.44, P5.46, P6.4, P6.6, P6.8, P6.10, P6.12, P6.14, P6.16, P6.18, P6.20, P6.22, P6.24, P6.26, P6.28, P6.30, P6.32, P6.34, P6.36, P6.38, P6.40, P6.42, P6.44, P6.46, P7.6, P7.7, P7.10, P7.11, P8.1, P8.2, R4.1 (COM1), R16.1 (COM1), UA1.2 (D), UA1.7 (GND), UA1.12 (D), UA2.7 (GND), UA3.7 (GND), UA4.8 (GND), UA4.9 (~W), UA5.8 (GND), UA5.9 (~W), UA6.8 (GND), UA7.10 (GND), UA8.8 (GND), UA9.8 (GND), UA10.8 (GND), UA11.5 (GND1), UA11.15 (GND2), UA12.5 (GND1), UA12.15 (GND2), UA13.7 (GND), UA14.7 (GND), UA15.7 (GND), UB1.8 (GND), UB1.10 (~CET), UB2.8 (GND), UB2.10 (~CET), UB3.8 (GND), UB3.15 (E), UB4.8 (GND), UB4.15 (E), UB5.8 (GND), UB6.8 (GND), UB7.7 (GND), UB8.7 (GND), UB9.8 (GND), UB9.19 (~CS1), UB10.8 (GND), UB10.19 (~CS1), UB11.7 (GND), UB12.7 (GND), UB13.10 (GND), UB15.7 (GND), UC1.8 (GND), UC2.8 (GND), UC3.8 (GND), UC3.15 (E), UC4.8 (GND), UC4.15 (E), UC5.8 (GND), UC6.8 (GND), UC7.7 (GND), UC8.7 (GND), UC9.10 (GND), UC10.7 (GND), UC11.8 (GND), UC11.15 (Mr), UC12.8 (GND), UC12.15 (Mr), UC13.10 (GND), UC14.8 (GND), UC14.15 (E), UC15.3 (P0), UC15.4 (P1), UC15.5 (P2), UC15.6 (P3), UC15.8 (GND), UC15.10 (~CET), UD2.8 (GND), UD3.4 (E1), UD3.5 (E2), UD3.8 (GND), UD4.8 (GND), UD5.8 (GND), UD6.8 (GND), UD6.15 (E), UD7.4 (1~R), UD7.8 (GND), UD7.12 (2~R), UD8.7 (GND), UD9.8 (GND), UD10.7 (GND), UD11.8 (GND), UD12.7 (GND), UD13.10 (GND), UD14.8 (GND), UD14.18 (~OE), UD14.19 (~CS1), UD15.8 (GND), UD15.18 (~OE), UD15.19 (~CS1), UE3.12 (GND), UE3.20 (~CE1), UE5.8 (GND), UE6.4 (E1), UE6.5 (E2), UE6.8 (GND), UE7.3 (A2), UE7.4 (E1), UE7.5 (E2), UE7.8 (GND), UE8.7 (GND), UE10.7 (GND), UE11.7 (GND), UE12.7 (GND), UE14.7 (GND), UE15.2 (D), UE15.7 (GND), UE15.12 (D), UF3.12 (GND), UF3.20 (~CE1), UF5.1 (~E), UF5.10 (GND), UF6.1 (Ea), UF6.3 (I3a), UF6.6 (I0a), UF6.8 (GND), UF7.30 (GND), UF9.30 (GND), UF11.8 (GND), UF12.2 (D), UF12.7 (GND), UF13.8 (GND), UF14.7 (GND), UH3.12 (GND), UH3.20 (~CE1), UH5.1 (~E), UH5.10 (GND), UH6.8 (GND), UH6.10 (I0b), UH11.4 (E1), UH11.5 (E2), UH11.8 (GND), UH12.4 (1~R), UH12.8 (GND), UH12.12 (2~R), UH12.15 (2M), UH13.7 (GND), UH14.4 (I2), UH14.8 (GND), UJ3.12 (GND), UJ3.20 (~CE1), UJ5.1 (~E), UJ5.10 (GND), UJ6.7 (GND), UJ7.6 (OR3), UJ7.8 (OR2), UJ7.10 (OR1), UJ7.12 (OR0), UJ7.14 (GND), UJ9.8 (GND), UJ10.8 (GND), UJ11.1 (I3), UJ11.8 (GND), UJ12.1 (Ea), UJ12.8 (GND), UJ12.15 (Eb), UJ13.3 (I3a), UJ13.8 (GND), UJ13.13 (I3b), UK3.12 (GND), UK3.20 (~CE1), UK5.1 (~E), UK5.10 (GND), UK6.7 (GND), UK7.14 (GND), UK9.8 (GND), UK10.7 (GND), UK11.8 (GND), UK12.7 (GND), UK13.3 (I3a), UK13.8 (GND), UK13.13 (I3b), UL3.12 (GND), UL3.20 (~CE1), UL5.1 (~E), UL5.10 (GND), UL6.7 (GND), UL9.4 (D3), UL9.8 (GND), UL10.7 (GND), UL11.8 (GND), UL11.15 (E), UL13.2 (J), UL13.8 (GND), UL14.7 (GND), UM3.12 (GND), UM3.20 (~CE1), UM5.1 (~E), UM5.10 (GND), UM6.10 (GND), UM7.10 (GND), UM8.1 (OEa), UM8.10 (GND), UM8.19 (OEb), UM9.2 (D), UM9.7 (GND), UM10.7 (GND), UM12.8 (GND), UM13.8 (GND), UM14.10 (GND), UM14.19 (OEb), UM15.1 (OEa), UM15.10 (GND), UM15.19 (OEb)
IACK: UA14.12, UA14.13, UM13.12 (Q7)
INT: UH13.6, UK9.12 (I7)
INT.EN: UB12.9, UC10.5, UF11.4 (Q0), UK13.10 (I0b)
JSR?: R8.2, UK6.1, UK6.5, UK6.9, UL6.2, UL6.5, UL6.13
M13.O0: UM8.13 (I1b), UM13.4 (Q0)
M13.O1: UM8.15 (I2b), UM13.5 (Q1)
MAP0: UB9.4 (A0), UB10.4 (A0), UD11.7 (Q2), UM15.13 (I1b)
MAP1: UB9.3 (A1), UB10.3 (A1), UD11.5 (Q1), UM15.15 (I2b)
MAP2: UB9.2 (A2), UB10.2 (A2), UD11.2 (Q0), UM15.17 (I3b)
MC0: JE3.9, P5.39, UD2.2 (A0), UD3.1 (A0), UE3.9 (D0)
MC1: JE3.10, P5.41, UD2.3 (A1), UD3.2 (A1), UE3.10 (D1)
MC2: JE3.11, P5.43, UD3.3 (A2), UE3.11 (D2)
MC3: P5.45, UD2.1 (E), UD3.6 (E3), UE3.13 (D3)
MC4: P5.47, UE3.14 (D4), UE5.11 (D3)
MC5: P5.49, UE3.15 (D5), UE5.3 (D0)
MC6: P5.50, UE3.16 (D6), UE5.13 (D4)
MC7: P5.48, UE3.17 (D7), UE5.14 (D5)
MC8: JJ3.9, P6.47, UJ3.9 (D0), UJ5.18 (D7)
MC9: JJ3.10, P6.49, UJ3.10 (D1), UJ5.17 (D6)
MC10: JJ3.11, P6.50, UJ3.11 (D2), UJ5.7 (D2)
MC11: P6.48, UJ3.13 (D3), UJ5.8 (D3)
MC12: P5.2, UJ3.14 (D4), UJ5.13 (D4)
MC13: P5.1, UJ3.15 (D5), UJ5.14 (D5)
MC14: P5.3, UJ3.16 (D6), UJ5.4 (D1)
MC15: P5.5, UJ3.17 (D7), UJ5.3 (D0)
MC16: JM3.9, P6.2, UM3.9 (D0), UM5.18 (D7)
MC17: JM3.10, P6.1, UM3.10 (D1), UM5.17 (D6)
MC18: JM3.11, P6.3, UM3.11 (D2), UM5.7 (D2)
MC19: P6.5, UM3.13 (D3), UM5.8 (D3)
MC20: P6.7, UM3.14 (D4), UM5.13 (D4)
MC21: P6.9, UM3.15 (D5), UM5.14 (D5)
MC22: P6.11, UM3.16 (D6), UM5.4 (D1)
MC23: P6.13, UM3.17 (D7), UM5.3 (D0)
MC24: JL3.9, P6.15, UL3.9 (D0), UL5.18 (D7)
MC25: JL3.10, P6.17, UL3.10 (D1), UL5.17 (D6)
MC26: JL3.11, P6.19, UL3.11 (D2), UL5.7 (D2)
MC27: P6.21, UL3.13 (D3), UL5.8 (D3)
MC28: P6.23, UL3.14 (D4), UL5.13 (D4)
MC29: P6.25, UL3.15 (D5), UL5.14 (D5)
MC30: P6.27, UL3.16 (D6), UL5.4 (D1)
MC31: P6.29, UL3.17 (D7), UL5.3 (D0)
MC32: JH3.9, P5.7, UH3.9 (D0), UH5.18 (D7)
MC33: JH3.10, P5.9, UH3.10 (D1), UH5.17 (D6)
MC34: JH3.11, P5.11, UH3.11 (D2), UH5.7 (D2)
MC35: P5.13, UH3.13 (D3), UH5.8 (D3)
MC36: P5.15, UH3.14 (D4), UH5.13 (D4)
MC37: P5.17, UH3.15 (D5), UH5.14 (D5)
MC38: P5.19, UH3.16 (D6), UH5.4 (D1)
MC39: P5.21, UH3.17 (D7), UH5.3 (D0)
MC40: JF3.9, P5.23, UF3.9 (D0), UF5.18 (D7)
MC41: JF3.10, P5.25, UF3.10 (D1), UF5.17 (D6)
MC42: JF3.11, P5.27, UF3.11 (D2), UF5.7 (D2)
MC43: P5.29, UF3.13 (D3), UF5.8 (D3)
MC44: P5.31, UF3.14 (D4), UF5.13 (D4)
MC45: P5.33, UF3.15 (D5), UF5.14 (D5)
MC46: P5.35, UF3.16 (D6), UF5.4 (D1)
MC47: P5.37, UF3.17 (D7), UF5.3 (D0)
MC48: JK3.9, P6.31, UK3.9 (D0), UK5.18 (D7)
MC49: JK3.10, P6.33, UK3.10 (D1), UK5.17 (D6)
MC50: JK3.11, P6.35, UK3.11 (D2), UK5.7 (D2)
MC51: P6.37, UK3.13 (D3), UK5.8 (D3)
MC52: P6.39, UK3.14 (D4), UK5.13 (D4)
MC53: P6.41, UK3.15 (D5), UK5.14 (D5)
MC54: P6.43, UK3.16 (D6), UK5.4 (D1)
MC55: P6.45, UK3.17 (D7), UK5.3 (D0)
MCA0: JE3.8, JF3.8, JH3.8, JJ3.8, JK3.8, JL3.8, JM3.8, P8.4, UE3.8 (A0), UF3.8 (A0), UH3.8 (A0), UJ3.8 (A0), UK3.8 (A0), UK7.18 (Y0), UL3.8 (A0), UM3.8 (A0)
MCA1: JE3.7, JF3.7, JH3.7, JJ3.7, JK3.7, JL3.7, JM3.7, P8.3, UE3.7 (A1), UF3.7 (A1), UH3.7 (A1), UJ3.7 (A1), UK3.7 (A1), UK7.19 (Y1), UL3.7 (A1), UM3.7 (A1)
MCA2: JE3.6, JF3.6, JH3.6, JJ3.6, JK3.6, JL3.6, JM3.6, P8.12, UE3.6 (A2), UF3.6 (A2), UH3.6 (A2), UJ3.6 (A2), UK3.6 (A2), UK7.20 (Y2), UL3.6 (A2), UM3.6 (A2)
MCA3: JE3.5, JF3.5, JH3.5, JJ3.5, JK3.5, JL3.5, JM3.5, P8.8, UE3.5 (A3), UF3.5 (A3), UH3.5 (A3), UJ3.5 (A3), UK3.5 (A3), UK7.21 (Y3), UL3.5 (A3), UM3.5 (A3)
MCA4: JE3.4, JF3.4, JH3.4, JJ3.4, JK3.4, JL3.4, JM3.4, P8.7, UE3.4 (A4), UF3.4 (A4), UH3.4 (A4), UJ3.4 (A4), UJ7.18 (Y0), UK3.4 (A4), UL3.4 (A4), UM3.4 (A4)
MCA5: JE3.3, JF3.3, JH3.3, JJ3.3, JK3.3, JL3.3, JM3.3, P8.13, UE3.3 (A5), UF3.3 (A5), UH3.3 (A5), UJ3.3 (A5), UJ7.19 (Y1), UK3.3 (A5), UL3.3 (A5), UM3.3 (A5)
MCA6: JE3.2, JF3.2, JH3.2, JJ3.2, JK3.2, JL3.2, JM3.2, P8.11, UE3.2 (A6), UF3.2 (A6), UH3.2 (A6), UJ3.2 (A6), UJ7.20 (Y2), UK3.2 (A6), UL3.2 (A6), UM3.2 (A6)
MCA7: JE3.1, JF3.1, JH3.1, JJ3.1, JK3.1, JL3.1, JM3.1, P8.10, UE3.1 (A7), UF3.1 (A7), UH3.1 (A7), UJ3.1 (A7), UJ7.21 (Y3), UK3.1 (A7), UL3.1 (A7), UM3.1 (A7)
MCA8: P8.9, UE3.23 (A8), UF3.23 (A8), UH3.23 (A8), UJ3.23 (A8), UK3.23 (A8), UL3.23 (A8), UL9.12 (Y0), UM3.23 (A8)
MCA9: P8.5, UE3.22 (A9), UF3.22 (A9), UH3.22 (A9), UJ3.22 (A9), UK3.22 (A9), UL3.22 (A9), UL9.13 (Y1), UM3.22 (A9)
MCA10: P8.6, UE3.21 (A10), UF3.21 (A10), UH3.21 (A10), UJ3.21 (A10), UK3.21 (A10), UL3.21 (A10), UL9.14 (Y2), UM3.21 (A10)
MMIO15: UA10.11 (IN2), UC8.12
NOT.MEM: UB12.3, UD12.12, UK9.1 (I3)
unnamed: C39.1, CR1.2 (A), R15.2, UA15.1
unnamed: JP1.1 (A), R18.2, UB7.4
unnamed: JP1.3 (B), R19.2, UB12.12
unnamed: P1.a30, P1.a31, P1.a32, P1.a33
unnamed: R1.1, UM14.7 (O1b)
unnamed: R2.1, UM10.1, UM10.2, XTAL1.1
unnamed: R2.2, R3.1, UM10.3, UM10.4, UM10.5
unnamed: R8.1, UK9.6 (~Z)
unnamed: R9.2, UL10.1 (~R), UL10.13 (~R)
unnamed: R10.2, UE3.19 (CE2), UF3.19 (CE2), UH3.19 (CE2), UJ3.19 (CE2), UK3.19 (CE2), UL3.19 (CE2), UM3.19 (CE2)
unnamed: R14.2, UD7.1 (1M), UD7.15 (2M)
unnamed: UA1.9 (Q), UA2.4, UA2.5
unnamed: UA1.11 (C), UA3.2
unnamed: UA2.12, UA2.13, UC10.10
unnamed: UA3.12, UH12.2 (1~S1), UH12.3 (1~S2), UH12.13 (2~S1)
unnamed: UA3.4, UA3.13
unnamed: UA8.9 (~W), UE12.2
unnamed: UA13.1, UA13.2, UA13.8
unnamed: UA13.4, UA13.5, UA15.3, UA15.8
unnamed: UA13.6, UA13.9, UA13.10
unnamed: UA14.9, UA14.10, UA15.2
unnamed: UA15.5, UC15.15 (~TC)
unnamed: UA2.9, UA2.10, UA15.6, UC15.7 (~CEP)
unnamed: UA15.9, UC10.2
unnamed: UA15.10, UB12.10
unnamed: UA15.12, UB11.1
unnamed: UB1.2 (CP), UB6.2 (CP), UC1.2 (CP), UC6.2 (CP), UD6.4 (Za)
unnamed: UB1.3 (P0), UB2.14 (Q0)
unnamed: UB1.4 (P1), UB2.13 (Q1)
unnamed: UB1.5 (P2), UB2.12 (Q2)
unnamed: UB1.6 (P3), UB2.11 (Q3)
unnamed: UB1.7 (~CEP), UB6.7 (~CEP), UC1.7 (~CEP), UC6.7 (~CEP), UD6.7 (Zb)
unnamed: UB1.15 (~TC), UC1.10 (~CET)
unnamed: UB2.2 (CP), UB5.2 (CP), UC2.2 (CP), UC5.2 (CP), UD6.9 (Zc)
unnamed: UB2.3 (P0), UB3.12 (Zd)
unnamed: UB2.4 (P1), UB3.9 (Zc)
unnamed: UB2.5 (P2), UB3.7 (Zb)
unnamed: UB2.6 (P3), UB3.4 (Za)
unnamed: UB2.7 (~CEP), UB5.7 (~CEP), UC2.7 (~CEP), UC5.7 (~CEP), UD6.12 (Zd)
unnamed: UB2.15 (~TC), UC2.10 (~CET)
unnamed: UB4.4 (Za), UB5.6 (P3)
unnamed: UB4.7 (Zb), UB5.5 (P2)
unnamed: UB4.9 (Zc), UB5.4 (P1)
unnamed: UB4.12 (Zd), UB5.3 (P0)
unnamed: UB5.10 (~CET), UC2.15 (~TC)
unnamed: UB5.11 (Q3), UB6.6 (P3)
unnamed: UB5.12 (Q2), UB6.5 (P2)
unnamed: UB5.13 (Q1), UB6.4 (P1)
unnamed: UB5.14 (Q0), UB6.3 (P0)
unnamed: UB5.15 (~TC), UC5.10 (~CET)
unnamed: UB6.10 (~CET), UC1.15 (~TC)
unnamed: UB6.15 (~TC), UC6.10 (~CET)
unnamed: UB7.1, UC8.10
unnamed: UB7.2, UC7.4
unnamed: UB7.3, UC7.1
unnamed: UB7.5, UB7.6, UC8.8
unnamed: UB7.11, UC7.13
unnamed: UB7.12, UC7.10
unnamed: UB9.18 (~OE), UB10.18 (~OE), UE12.4
unnamed: UB11.8, UC8.13
unnamed: UB11.12, UB15.2 (D), UB15.12 (D)
unnamed: UB12.5, UE8.13
unnamed: UB12.8, UF13.3 (D0)
unnamed: UC1.3 (P0), UC2.14 (Q0)
unnamed: UC1.4 (P1), UC2.13 (Q1)
unnamed: UC1.5 (P2), UC2.12 (Q2)
unnamed: UC1.6 (P3), UC2.11 (Q3)
unnamed: UC2.3 (P0), UC3.12 (Zd)
unnamed: UC2.4 (P1), UC3.9 (Zc)
unnamed: UC2.5 (P2), UC3.7 (Zb)
unnamed: UC2.6 (P3), UC3.4 (Za)
unnamed: UC4.4 (Za), UC5.6 (P3)
unnamed: UC4.7 (Zb), UC5.5 (P2)
unnamed: UC4.9 (Zc), UC5.4 (P1)
unnamed: UC4.12 (Zd), UC5.3 (P0)
unnamed: UC5.11 (Q3), UC6.6 (P3)
unnamed: UC5.12 (Q2), UC6.5 (P2)
unnamed: UC5.13 (Q1), UC6.4 (P1)
unnamed: UC5.14 (Q0), UC6.3 (P0)
unnamed: UC10.6, UD10.8
unnamed: UC10.8, UD12.5
unnamed: UC5.15 (~TC), UC10.13
unnamed: UC13.5 (Q1), UD14.21 (A4), UD15.21 (A4)
unnamed: UC13.6 (Q2), UD14.5 (A5), UD15.5 (A5)
unnamed: UC13.9 (Q3), UD14.6 (A6), UD15.6 (A6)
unnamed: UC13.15 (Q5), UC14.11 (I0c)
unnamed: UC13.16 (Q6), UC14.5 (I0b)
unnamed: UC13.19 (Q7), UC14.2 (I0a)
unnamed: UC14.4 (Za), UD14.4 (A0), UD15.4 (A0)
unnamed: UC14.7 (Zb), UD14.3 (A1), UD15.3 (A1)
unnamed: UC14.9 (Zc), UD14.2 (A2), UD15.2 (A2)
unnamed: UC14.12 (Zd), UD14.1 (A3), UD15.1 (A3)
unnamed: UD2.4 (O0), UD4.13 (D4)
unnamed: UD2.5 (O1), UD4.3 (D0)
unnamed: UD2.6 (O2), UD4.6 (D2)
unnamed: UD2.7 (O3), UD4.11 (D3)
unnamed: UD2.13 (A1), UD2.14 (A0), UD2.15 (E)
unnamed: UD3.10 (O5), UD5.11 (D3)
unnamed: UD3.11 (O4), UD5.6 (D2)
unnamed: UD3.12 (O3), UD5.13 (D4)
unnamed: UD3.13 (O2), UD5.14 (D5)
unnamed: UD3.14 (O1), UD5.4 (D1)
unnamed: UD3.15 (O0), UD5.3 (D0)
unnamed: UD7.2 (1~S1), UD8.8
unnamed: UD7.13 (2~S1), UD8.6
unnamed: UD10.1, UD14.7 (A7), UD15.7 (A7)
unnamed: UD10.4, UK9.3 (I1)
unnamed: UD10.10, UE10.11
unnamed: UD10.13, UE10.10
unnamed: UD12.3, UE10.4
unnamed: UD7.3 (1~S2), UD12.6
unnamed: UD12.8, UL13.3 (~K)
unnamed: UD12.11, UE10.3
unnamed: UD13.3 (D0), UD14.10 (Q0)
unnamed: UD13.4 (D1), UD14.12 (Q1)
unnamed: UD13.7 (D2), UD14.14 (Q2)
unnamed: UD13.8 (D3), UD14.16 (Q3)
unnamed: UD13.13 (D4), UD15.16 (Q3)
unnamed: UD13.14 (D5), UD15.14 (Q2)
unnamed: UD13.17 (D6), UD15.12 (Q1)
unnamed: UD13.18 (D7), UD15.10 (Q0)
unnamed: UE8.8, UE8.9
unnamed: UE10.1, UE11.8
unnamed: UE11.1, UE11.2, UE14.2
unnamed: UE11.9, UE11.10, UE11.12, UE14.11
unnamed: UE14.4, UE14.5
unnamed: UE14.6, UE15.11 (C)
unnamed: UE14.8, UH12.14 (2~S2)
unnamed: UE14.12, UE15.4 (~S)
unnamed: UE8.1, UE14.13
unnamed: UF6.7 (Za), UF9.29 (Cn)
unnamed: UF7.9 (RAM0_LO/RI), UF9.8 (RAM3_RO/LI)
unnamed: UF7.21 (Q0_LO/RI), UF9.16 (Q3_RO/LI)
unnamed: UF7.40 (~OE), UF9.40 (~OE), UL6.8
unnamed: UF12.5 (Q), UM10.10
unnamed: UF12.9 (Q), UK9.4 (I0)
unnamed: UF13.13 (D4), UF14.11
unnamed: UF13.14 (D5), UF14.8
unnamed: UF14.6, UK9.14 (I5)
unnamed: UF14.9, UM9.9 (Q)
unnamed: UF14.3, UF14.12, UF14.13
unnamed: UH6.15 (OEb), UJ6.12
unnamed: UH13.9, UH13.10, UK12.10
unnamed: UH13.13, UK12.13
unnamed: UJ6.6, UK6.13
unnamed: UJ6.8, UJ7.25 (~FE), UK7.25 (~FE), UL9.19 (~FE)
unnamed: UJ6.9, UL6.6
unnamed: UJ6.10, UJ7.22 (~OE), UK7.22 (~OE), UL9.16 (~OE)
unnamed: UJ7.16 (S0), UK6.3, UL9.10 (S0)
unnamed: UJ7.17 (S1), UK6.8
unnamed: UJ7.23 (Cn), UK7.24 (Cn+4)
unnamed: UJ7.24 (Cn+4), UL9.17 (Cn)
unnamed: UJ9.15 (Q5), UK10.1
unnamed: UJ10.3 (I1), UK10.8
unnamed: UJ10.5 (Z), UM12.11 (D3)
unnamed: UJ11.5 (Z), UM12.6 (D2)
unnamed: UJ12.7 (Za), UM12.4 (D1)
unnamed: UJ12.9 (Zb), UM12.3 (D0)
unnamed: UK6.6, UL9.11 (S1)
unnamed: UK6.10, UK6.11
unnamed: UK7.16 (S0), UL6.3
unnamed: UK7.17 (S1), UL6.11
unnamed: UK10.3, UK10.12, UK10.13
unnamed: UK12.1, UK12.11, UK12.12
unnamed: UK12.2, UK12.3, UK12.4
unnamed: UL10.5 (Q), UL11.6 (I1b), UM10.13
unnamed: UL10.6 (~Q), UL11.10 (I1c)
unnamed: UL10.3 (C), UL10.11 (C), UL11.4 (Za)
unnamed: UL11.11 (I0c), UL14.6
unnamed: UL13.11 (~S), UL13.12 (C), UL13.13 (~K), UL13.14 (J), UL13.15 (~R)
unnamed: UL14.1, UL14.2
unnamed: UL14.9, UL14.10
unnamed: UL14.11, UM7.17 (I3b)
OR0: UJ13.7 (Za), UK7.12 (OR0)
OR1: UJ13.9 (Zb), UK7.10 (OR1)
OR2: UK7.8 (OR2), UK13.9 (Zb)
OR3: UK7.6 (OR3), UK13.7 (Za)
P4.7: P4.7, R12.2, UE12.3
P4.14: P4.14, R13.2, UE12.1
P7.1: P7.1, R6.2, UL11.1 (S)
P7.2: P7.2, UL11.5 (I0b), UL14.4, UL14.5
P7.3: P7.3, UL11.2 (I0a)
P7.4: P7.4, UL10.12 (D), UM10.11
P7.5: P7.5, R17.2, UL10.4 (~S), UL10.10 (~S)
P7.8: P7.8, UL11.14 (I0d)
P7.9: P7.9, R7.9 (R8), UL6.9
P7.12: P7.12, R7.2 (R1), UJ6.11
P7.13: P7.13, UL10.2 (D), UL10.9 (Q), UL11.13 (I1d), UM10.12
P7.14: P7.14, R11.2, UE3.18 (CE3), UF3.18 (CE3), UH3.18 (CE3), UJ3.18 (CE3), UK3.18 (CE3), UL3.18 (CE3), UM3.18 (CE3)
PA11: P10.1, UA9.2 (IN0), UB8.2, UB8.3, UB9.16 (Q3), UC7.8
PA12: P10.2, UA9.5 (IN1), UB9.14 (Q2), UC7.9
PA13: P10.3, UA9.14 (IN3), UB8.12, UB9.12 (Q1), UC7.12
PA14: P10.4, UA9.11 (IN2), UB8.11, UB9.10 (Q0), UC7.11
PA15: P10.5, UA10.2 (IN0), UB8.6, UB10.16 (Q3), UB11.11, UC7.2
PA16: P10.6, UA10.5 (IN1), UB8.5, UB10.14 (Q2), UB11.10, UC7.3
PA17: P10.7, UA10.14 (IN3), UB8.4, UB10.12 (Q1), UB11.9, UC8.11
PARO: UA13.12, UA13.13, UF11.10 (Q5)
PE: UB15.6 (~Q), UK9.13 (I6)
PE.EN: UB11.2, UB11.13, UF11.11 (Q6)
PHI1: UC10.1, UL11.7 (Zb)
PHI2: UK12.5, UK12.6, UL11.12 (Zd)
PL4: UE5.10 (Q3), UE6.1 (A0)
PL5: UE5.2 (Q0), UE6.2 (A1)
PL6: UE5.12 (Q4), UE6.3 (A2)
PL7: UE5.15 (Q5), UK11.1 (A0), UK12.9
PL8: UJ5.19 (Q7), UK11.2 (A1), UK12.8
PL9: UH13.12, UJ5.16 (Q6), UK11.3 (A2)
PL10: UH11.1 (A0), UJ5.6 (Q2)
PL11: UH11.2 (A1), UJ5.9 (Q3)
PL12: UH11.3 (A2), UJ5.12 (Q4)
PL13: UE7.1 (A0), UJ5.15 (Q5)
PL14: UE7.2 (A1), UJ5.5 (Q1)
PL15: UJ5.2 (Q0), UK9.7 (~E)
PL16: UJ12.14 (S0), UK7.13 (D0), UK9.11 (S0), UM5.19 (Q7), UM6.17 (I3b)
PL17: UJ12.2 (S1), UK7.11 (D1), UK9.10 (S1), UM5.16 (Q6), UM6.15 (I2b)
PL18: UJ11.7 (~E), UK7.9 (D2), UK9.9 (S2), UM5.6 (Q2), UM6.13 (I1b)
PL19: UJ11.11 (S0), UK7.7 (D3), UM5.9 (Q3), UM6.11 (I0b)
PL20: UJ7.13 (D0), UJ11.10 (S1), UJ13.14 (S0), UM5.12 (Q4), UM6.2 (I0a)
PL21: UJ7.11 (D1), UJ10.7 (~E), UJ13.2 (S1), UM5.15 (Q5), UM6.4 (I1a)
PL22: UJ7.9 (D2), UJ10.11 (S0), UK13.14 (S0), UM5.5 (Q1), UM6.6 (I2a)
PL23: UJ7.7 (D3), UJ10.10 (S1), UK13.2 (S1), UM5.2 (Q0), UM6.8 (I3a)
PL24: UJ10.9 (S2), UL5.19 (Q7), UL9.7 (D0)
PL25: UL5.16 (Q6), UL9.6 (D1)
PL26: UL5.6 (Q2), UL9.5 (D2)
PL27: UL5.9 (Q3), UL6.4
PL28: UJ7.26 (PUP), UK7.26 (PUP), UL5.12 (Q4), UL9.20 (PUP)
PL29: UL5.15 (Q5), UL6.1
PL30: UL5.5 (Q1), UL6.12
PL31: UK6.2, UL5.2 (Q0)
PL32: UH5.19 (Q7), UJ6.5, UK6.4
PL33: UH5.16 (Q6), UJ13.1 (Ea), UJ13.15 (Eb), UK13.1 (Ea), UK13.15 (Eb)
PL51: UF6.14 (S0), UH6.14 (A0), UK5.9 (Q3)
PL52: UF6.2 (S1), UH6.2 (A1), UK5.12 (Q4)
PL53: UD10.2, UK5.15 (Q5)
PL54: UK5.5 (Q1), UK6.12
PL55: UC14.1 (S), UK5.2 (Q0)
R0: UB3.13 (I1d), UB4.13 (I1d), UB9.15 (D3), UC9.2 (Q0), UD15.15 (D3)
R1: UB3.10 (I1c), UB4.10 (I1c), UB9.13 (D2), UC9.5 (Q1), UD15.13 (D2)
R2: UB3.6 (I1b), UB4.6 (I1b), UB9.11 (D1), UC9.6 (Q2), UD15.11 (D1)
R3: UB3.3 (I1a), UB4.3 (I1a), UB9.9 (D0), UC9.9 (Q3), UD15.9 (D0)
R4: UB10.15 (D3), UC3.13 (I1d), UC4.13 (I1d), UC9.12 (Q4), UD14.15 (D3), UJ10.15 (I4)
R5: UB10.13 (D2), UC3.10 (I1c), UC4.10 (I1c), UC9.15 (Q5), UD14.13 (D2), UJ11.4 (I0), UJ11.15 (I4)
R6: UB10.11 (D1), UC3.6 (I1b), UC4.6 (I1b), UC9.16 (Q6), UD14.11 (D1), UJ12.4 (I2a)
R7: UB10.9 (D0), UC3.3 (I1a), UC4.3 (I1a), UC9.19 (Q7), UD14.9 (D0), UJ12.12 (I2b)
RDIN: UA1.5 (Q), UA2.1, UA2.2, UB12.4
RDONLY: UA14.4, UA14.5, UB8.1, UB10.10 (Q0), UC8.5, UH14.10 (I4)
REG/RDONLY: P10.8, UB12.11, UD12.1, UK9.15 (I4)
RIR.0: UC13.2 (Q0), UD10.3, UD10.5, UK9.2 (I2)
RIR.4: UC13.12 (Q4), UC14.14 (I0d), UD10.6
RUN: UM13.9 (Q4), UM14.15 (I2b)
R/F: P3.15, R4.7 (R6), UL14.12, UL14.13
TIMER.EN: UF14.10, UM13.6 (Q2)
U/~D: UB1.1 (U/~D), UB2.1 (U/~D), UB5.1 (U/~D), UB6.1 (U/~D), UC1.1 (U/~D), UC2.1 (U/~D), UC5.1 (U/~D), UC6.1 (U/~D), UF11.7 (Q3)
VCC: C1.1, C2.1, C3.1, C4.1, C5.1, C6.1, C7.1, C8.1, C9.1, C10.1, C11.1, C12.1, C13.1, C14.1, C15.1, C16.1, C17.1, C18.1, C19.1, C20.1, C21.1, C22.1, C23.1, C24.1, C25.1, C26.1, C27.1, C28.1, C29.1, C30.1, C31.1, C32.1, C33.1, C34.1, C35.1, C36.1, C37.1, C38.1, C40.1, C41.1, C42.1, C43.1, C44.1, C45.1, C46.1, C47.1, C48.1, C49.1, C50.1, C51.1, C52.1, C53.1, C54.1, CR1.1 (K), P1.a2, P1.a35, P1.b2, P1.b35, P3.22, P3.23, P3.24, P3.25, P3.26, P4.8, P4.9, P8.15, P8.16, R4.10 (COM2), R5.1, R6.1, R7.1 (common), R9.1, R10.1, R11.1, R12.1, R13.1, R14.1, R15.1, R16.10 (COM2), R17.1, R18.1, R19.1, UA1.14 (VCC), UA2.14 (VCC), UA3.14 (VCC), UA4.16 (VCC), UA5.16 (VCC), UA6.16 (VCC), UA7.20 (VCC), UA8.16 (VCC), UA9.16 (VCC), UA10.16 (VCC), UA11.20 (VCC), UA12.20 (VCC), UA13.14 (VCC), UA14.14 (VCC), UA15.14 (VCC), UB1.16 (VCC), UB2.16 (VCC), UB3.16 (VCC), UB4.16 (VCC), UB5.16 (VCC), UB6.16 (VCC), UB7.14 (VCC), UB8.14 (VCC), UB9.17 (CS2), UB9.22 (VCC), UB10.17 (CS2), UB10.22 (VCC), UB11.14 (VCC), UB12.14 (VCC), UB13.20 (VCC), UB15.1 (~R), UB15.4 (~S), UB15.13 (~R), UB15.14 (VCC), UC1.16 (VCC), UC2.16 (VCC), UC3.16 (VCC), UC4.16 (VCC), UC5.16 (VCC), UC6.16 (VCC), UC7.14 (VCC), UC8.14 (VCC), UC9.20 (VCC), UC10.14 (VCC), UC11.16 (VCC), UC12.16 (VCC), UC13.20 (VCC), UC14.16 (VCC), UC15.1 (U/~D), UC15.16 (VCC), UD2.16 (VCC), UD3.16 (VCC), UD4.1 (~Mr), UD4.16 (VCC), UD5.1 (~Mr), UD5.16 (VCC), UD6.16 (VCC), UD7.16 (VCC), UD8.14 (VCC), UD9.16 (VCC), UD10.14 (VCC), UD11.16 (VCC), UD12.14 (VCC), UD13.20 (VCC), UD14.17 (CS2), UD14.22 (VCC), UD15.17 (CS2), UD15.22 (VCC), UE3.24 (VCC), UE5.1 (~Mr), UE5.16 (VCC), UE6.6 (E3), UE6.16 (VCC), UE7.16 (VCC), UE8.14 (VCC), UE10.14 (VCC), UE11.14 (VCC), UE12.14 (VCC), UE14.14 (VCC), UE15.14 (VCC), UF3.24 (VCC), UF5.20 (VCC), UF6.5 (I1a), UF6.16 (VCC), UF7.10 (VCC), UF9.10 (VCC), UF11.16 (VCC), UF12.10 (~S), UF12.13 (~R), UF12.14 (VCC), UF13.1 (~Mr), UF13.16 (VCC), UF14.14 (VCC), UH3.24 (VCC), UH5.20 (VCC), UH6.13 (I3b), UH6.16 (VCC), UH11.6 (E3), UH11.16 (VCC), UH12.16 (VCC), UH13.14 (VCC), UH14.12 (I5), UH14.14 (I6), UH14.15 (OEb), UH14.16 (VCC), UJ3.24 (VCC), UJ5.20 (VCC), UJ6.14 (VCC), UJ7.28 (VCC), UJ9.16 (VCC), UJ10.1 (I3), UJ10.16 (VCC), UJ11.3 (I1), UJ11.12 (I7), UJ11.14 (I5), UJ11.16 (VCC), UJ12.16 (VCC), UJ13.16 (VCC), UK3.24 (VCC), UK5.20 (VCC), UK6.14 (VCC), UK7.23 (Cn), UK7.28 (VCC), UK9.16 (VCC), UK10.14 (VCC), UK11.6 (E3), UK11.16 (VCC), UK12.14 (VCC), UK13.16 (VCC), UL3.24 (VCC), UL5.20 (VCC), UL6.14 (VCC), UL9.2 (VCC), UL9.3 (~RE), UL10.14 (VCC), UL11.16 (VCC), UL13.1 (~R), UL13.16 (VCC), UL14.14 (VCC), UM3.24 (VCC), UM5.20 (VCC), UM6.20 (VCC), UM7.20 (VCC), UM8.20 (VCC), UM9.10 (~S), UM9.12 (D), UM9.14 (VCC), UM10.14 (VCC), UM12.16 (VCC), UM13.16 (VCC), UM14.20 (VCC), UM15.20 (VCC)
WAR.TC: UC10.12, UD12.9
~A11: P1.a22, UC8.2
~A12: P1.a10, UA3.8
~A13: P1.a12, UA3.6
~A14: P1.a9, UA3.10
~A15: P1.a17, UC8.4
~ABE: UA6.9 (~W), UA9.9 (~W), UA10.9 (~W), UF11.5 (Q1)
~APRE: P1.a11, UA2.11
~BAD.PG: UB8.8, UB12.1, UJ13.12 (I2b)
~BRDONLY: P1.a26, UA14.6
~BUS.ABT: UE7.14 (O1), UE8.3
~BUS.RD: UD7.14 (2~S2), UH11.14 (O1)
~BUS.WAIT: UE7.12 (O3), UE8.12, UE11.11, UE14.9
~BUS.WT: UC10.9, UH11.13 (O2)
~BUSCLK: P1.b31, UA13.3
~BUSY: UC10.4, UD6.3 (I1a), UF12.12 (D)
~CL0: P1.a18, UA8.15 (BUS3)
~CL1: P1.a19, UA8.12 (BUS2)
~CL2: P1.a20, UA8.4 (BUS1)
~CL3: P1.a21, UA8.1 (BUS0)
~CPU.CLKA: UF5.11 (CP), UH5.11 (CP), UJ5.11 (CP), UJ6.2, UJ7.27 (CP), UK5.11 (CP), UK7.27 (CP), UL5.11 (CP), UL9.1 (CP), UM5.11 (CP)
~CPU.CLKB: UC9.11 (CP), UC11.7 (Cp), UC12.7 (Cp), UC13.11 (CP), UD4.9 (Cp), UD5.9 (Cp), UD9.9 (C), UD11.9 (C), UD13.11 (Cp), UE5.9 (Cp), UE8.2, UE8.4
~CPU.CLKC: UF7.15 (CP), UF9.15 (CP), UF12.11 (C), UF13.9 (Cp), UJ9.9 (C), UK10.6, UK11.4 (E1), UK11.5 (E2), UM12.9 (C)
~CPU.CLK: UD6.2 (I0a), UD6.11 (I0c), UH12.9 (2~Y)
~DBE: UA11.9 (~BE), UA12.9 (~BE), UE15.8 (~Q)
~DMA.ACT: P2.2, UM8.9 (O0b)
~DMA.END: P2.5, UM8.16 (O1a)
~DMA.EN: P2.6, UM8.3 (O3b)
~DMA.INT.Q: UF13.12 (Q4), UH13.5, UK13.11 (I1b)
~DMA.INTR: P2.12, R4.5 (R4), UM14.11 (I0b)
~DMA.INT: UE10.8, UF14.2, UH14.2 (I1)
~DMA.PE: UB15.9 (Q), UE10.5
~DMA.RDRDY: P2.8, UM8.18 (O0a)
~DMA.RD: UB15.11 (C), UE11.6, UM9.4 (~S)
~DMA.REQ.Q: UF13.5 (Q1), UF14.4, UF14.5, UH13.2, UK13.4 (I2a)
~DMA.REQ: P2.13, R4.6 (R5), UF13.4 (D1)
~DMA.RESET: UK11.14 (O1), UL13.5 (~S)
~DMA.START: P2.10, R4.3 (R2), UM8.8 (I3a)
~DMA.WTRDY: P2.9, UM10.8
~DRDY: P1.a8, R16.2 (R1), UA2.8, UA3.3, UA14.3
~IACK: P1.a29, UA14.11
~INC.DMA: UD6.6 (I1b), UD6.13 (I1d), UE14.1, UF11.6 (Q2)
~INC.MAR: UD6.5 (I0b), UH11.10 (O5)
~INC.WAR: UD6.14 (I0d), UH11.11 (O4)
~INR0: P1.a16, R16.6 (R5), UA7.8 (I3a)
~INR1: P1.a13, R16.7 (R6), UA7.6 (I2a)
~INR2: P1.a14, R16.8 (R7), UA7.4 (I1a)
~INR3: P1.a15, R16.9 (R8), UA7.2 (I0a)
~INTR.Q: UF13.2 (Q0), UH13.4, UK13.5 (I1a)
~INTR: P1.a27, R16.5 (R4), UA15.11
~LOAD.AHI: UB5.9 (~PE), UC5.9 (~PE), UH11.12 (O3)
~LOAD.ALO: UB2.9 (~PE), UC2.9 (~PE), UK11.9 (O6)
~LOAD.CCR: UE6.7 (O7), UM12.1 (~E)
~LOAD.CL: UD9.1 (~E), UE6.12 (O3)
~LOAD.DBR: UA11.19 (DRCP), UA12.19 (DRCP), UE15.10 (~S), UK11.7 (O7)
~LOAD.FLR: UE7.13 (O2), UJ9.1 (~E)
~LOAD.MAP: UD11.1 (~E), UE6.11 (O4)
~LOAD.MAR: UB1.9 (~PE), UB3.1 (S), UB4.1 (S), UB6.9 (~PE), UC1.9 (~PE), UC3.1 (S), UC4.1 (S), UC6.9 (~PE), UE6.10 (O5)
~LOAD.RIR: UC13.1 (~E), UE6.13 (O2)
~LOAD.RR: UC9.1 (~E), UE6.14 (O1)
~LOAD.SAR: UE6.9 (O6), UJ7.1 (~RE), UK7.1 (~RE)
~LOAD.SWP: UC11.9 (E1), UC11.10 (E2), UC12.9 (E1), UC12.10 (E2), UH11.7 (O7)
~MMIO15: P1.b20, UA10.12 (BUS2)
~PA11: P1.b16, UA9.1 (BUS0)
~PA12: P1.b17, UA9.4 (BUS1)
~PA13: P1.b18, UA9.15 (BUS3)
~PA14: P1.b19, UA9.12 (BUS2)
~PA15: P1.a23, UA10.1 (BUS0)
~PA16: P1.a24, UA10.4 (BUS1)
~PA17: P1.a25, UA10.15 (BUS3)
~PE: P1.a28, R16.3 (R2), UA15.13
~PHI1A: UA15.4, UC15.2 (CP)
~PHI1: UD7.5 (1C), UD7.11 (2C), UH12.5 (1C), UH12.11 (2C), UL11.9 (Zc), UL13.4 (C), UM9.3 (C)
~PROME: UB13.16 (~E2), UM13.7 (Q3)
~RDIN1: UA1.6 (~Q), UB11.3
~RDIN: P1.a6, UA2.3
~RDONLY: JP1.2 (C), UC8.6, UD8.13, UD12.4, UJ13.4 (I2a)
~RD: UA1.4 (~S), UD7.9 (2~Y)
~READ.AHI: UA6.7 (~R), UA7.19 (OEb), UD4.7 (Q2)
~READ.ALO: UA4.7 (~R), UA5.7 (~R), UD4.10 (Q3)
~READ.CCR: UD5.5 (Q1), UM7.19 (OEb), UM14.1 (OEa)
~READ.CONST: UD5.10 (Q3), UM6.1 (OEa), UM6.19 (OEb)
~READ.DB: UA11.11 (~OE), UA12.11 (~OE), UD5.15 (Q5)
~READ.INR: UA7.1 (OEa), UD5.7 (Q2), UM7.1 (OEa)
~READ.MSR: UA8.7 (~R), UD5.12 (Q4), UH14.1 (OEa)
~READ.PF: UA9.7 (~R), UA10.7 (~R), UD5.2 (Q0)
~READ.RF: UD4.2 (Q0), UD13.1 (OE)
~READ.SWP: UC11.1 (Oe1), UC11.2 (Oe2), UC12.1 (Oe1), UC12.2 (Oe2), UD4.12 (Q4)
~REG: UB7.8, UB12.2, UB12.13, UC10.11
~RESET1: UA1.1 (~R), UA1.13 (~R), UD4.5 (Q1), UF11.15 (Clr), UJ7.15 (~ZERO), UK7.15 (~ZERO), UL9.9 (~ZERO), UM13.15 (Clr)
~RESET2: UD4.15 (Q5), UE15.1 (~R), UE15.13 (~R), UF12.1 (~R), UM9.1 (~R)
~RLE: UA11.1 (~RLE), UA12.1 (~RLE), UB12.6, UB15.3 (C)
~STATE1.EN: UF11.14 (E), UK11.12 (O3)
~STATE2.EN: UK11.13 (O2), UM13.14 (E)
~TIMER.Q: UF13.15 (Q5), UH13.1, UM7.8 (I3a)
~TIMER.RESET: UM9.13 (~R), UM13.10 (Q5)
~WRITE.PF: UB9.20 (~WE), UB10.20 (~WE), UK11.10 (O5)
~WRITE.RF: UD14.20 (~WE), UD15.20 (~WE), UH13.8
~WTIN1: UA1.8 (~Q), UB11.4, UB11.5, UF12.3 (C)
~WTIN: P1.a7, UA2.6
~WT: UA1.10 (~S), UD7.7 (1~Y), UF12.4 (~S)

Notes on the sheet:
8-10
47uF?
CPU State Control
(DMA.READ and NOT.MEM) or (REG/RDONLY and DMA.WRITE) or DMA.PE
ALU
READ.CCR - CCR High, Sense Switches Low READ.INR - INR High, Other Dip Switches Low READ.MSR - CL High, H14 Low
MINUS/SIGN and VALUE/ZERO
INC.DMA and DMA.EN
Pulled Up
LSH
Sequencer
0-3
read or write
Condition Codes
(DMA.EN and INC.DMA) or BUS.WAIT
DMA?
FAULT/OVERFLOW
Unused
Address Registers
4-7
not (INC.DMA and DMA.EN and WAR.TC)
Swapper
Microcode ROM and Pipeline Register
Parity Error
Bad Page or Register File access
Instruction Decoder
LINK/CARRY
Address Decoding
DMA start?
Microcode Decoders
Interrupts
not DMA.EN or not INC.DMA
Microcode conditionals
Page File
Register File
RSH
Pulled up
CPU Primary Clock
