sjsoftware/centurion-cpu6/kicad/CPU5/CPU5A/CPU5PA/CPU5PA.kicad_sch

## KiCad design kicad/CPU5/CPU5A/CPU5PA/CPU5PA.kicad_sch (2023-11-11)

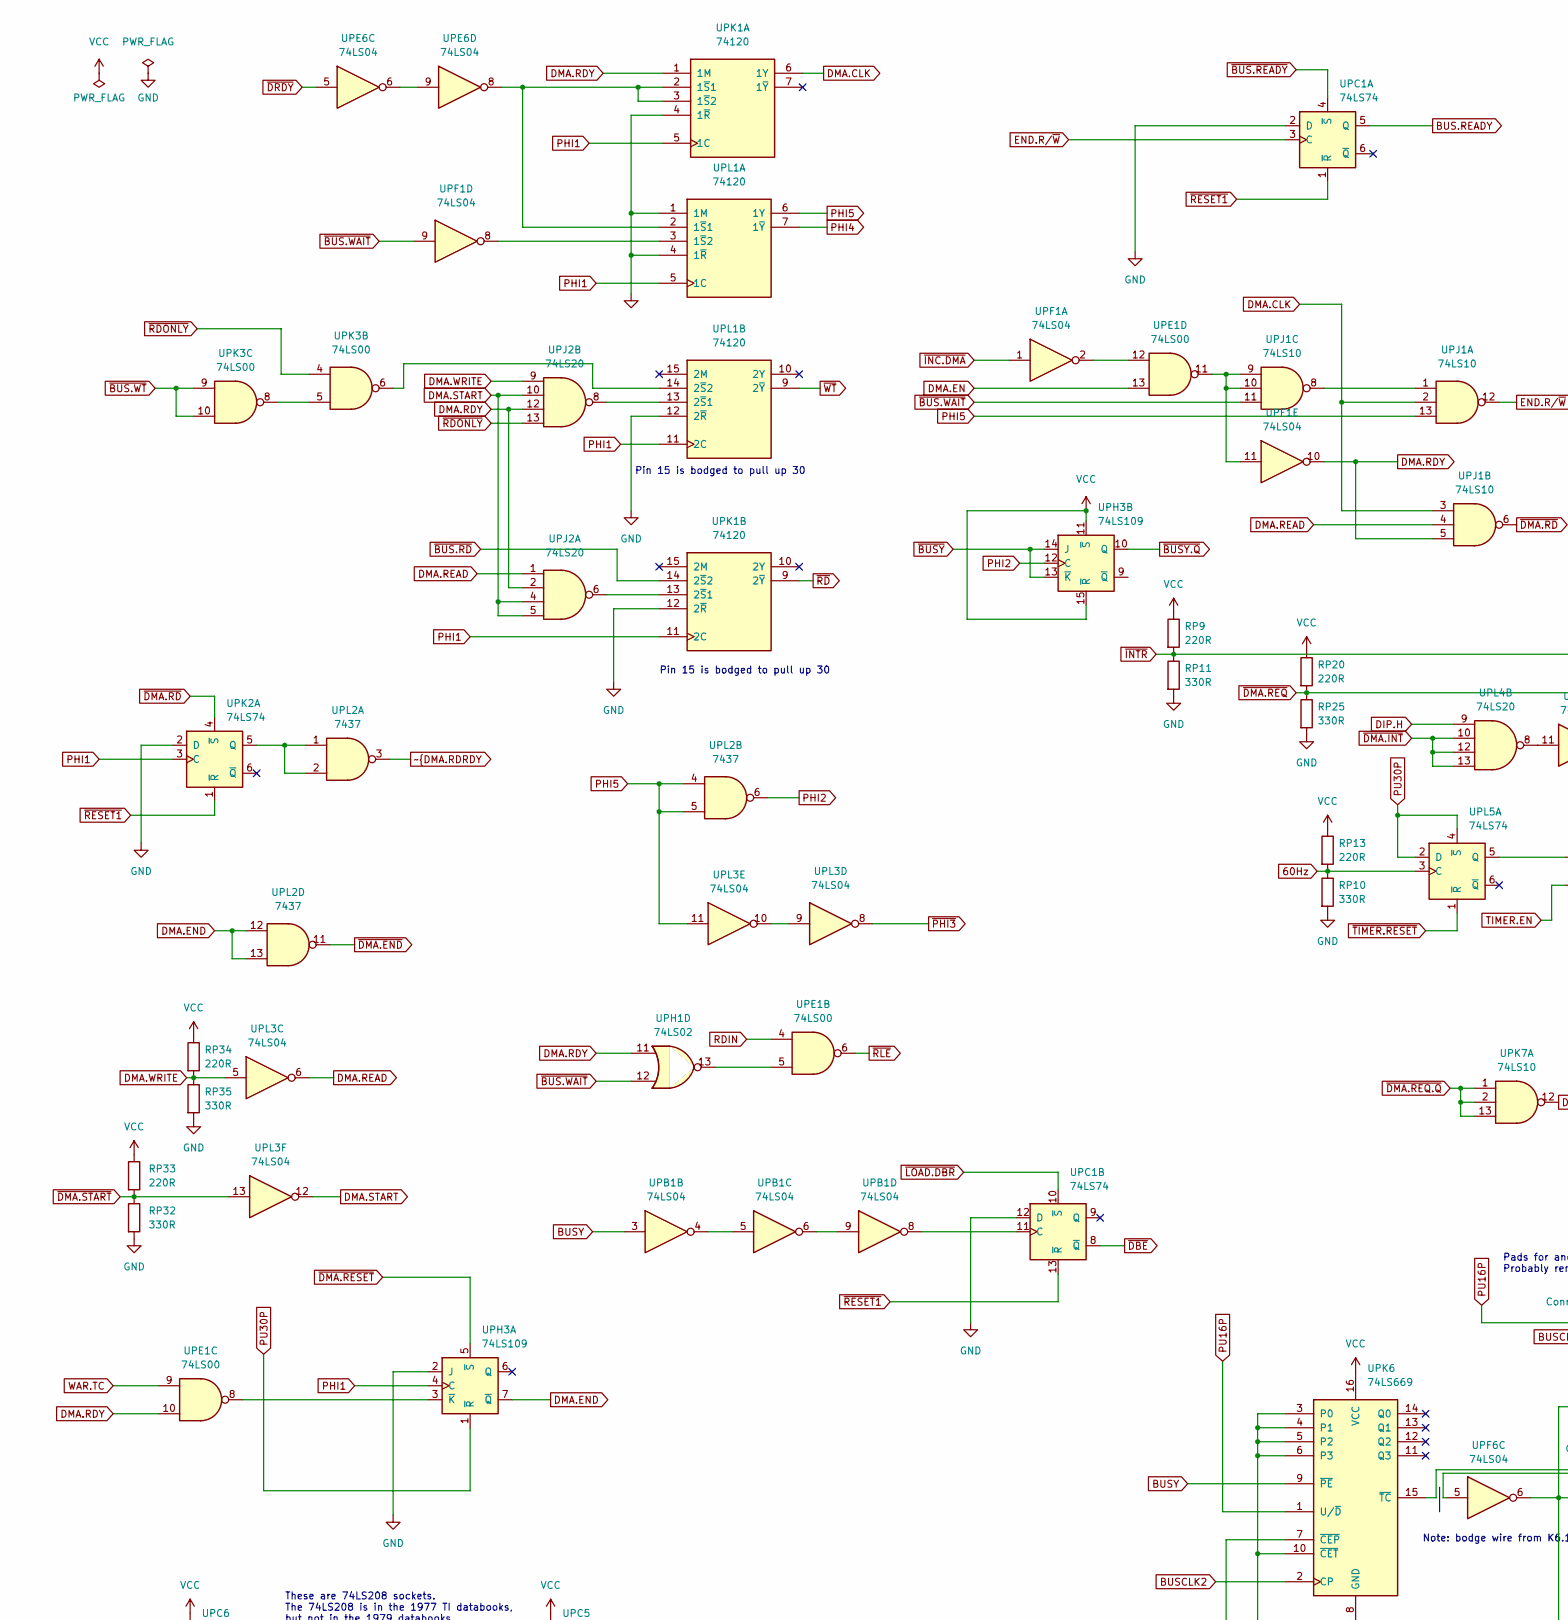
[picture p6: schematic CPU5PA.kicad_sch, part in row 1, column 1]

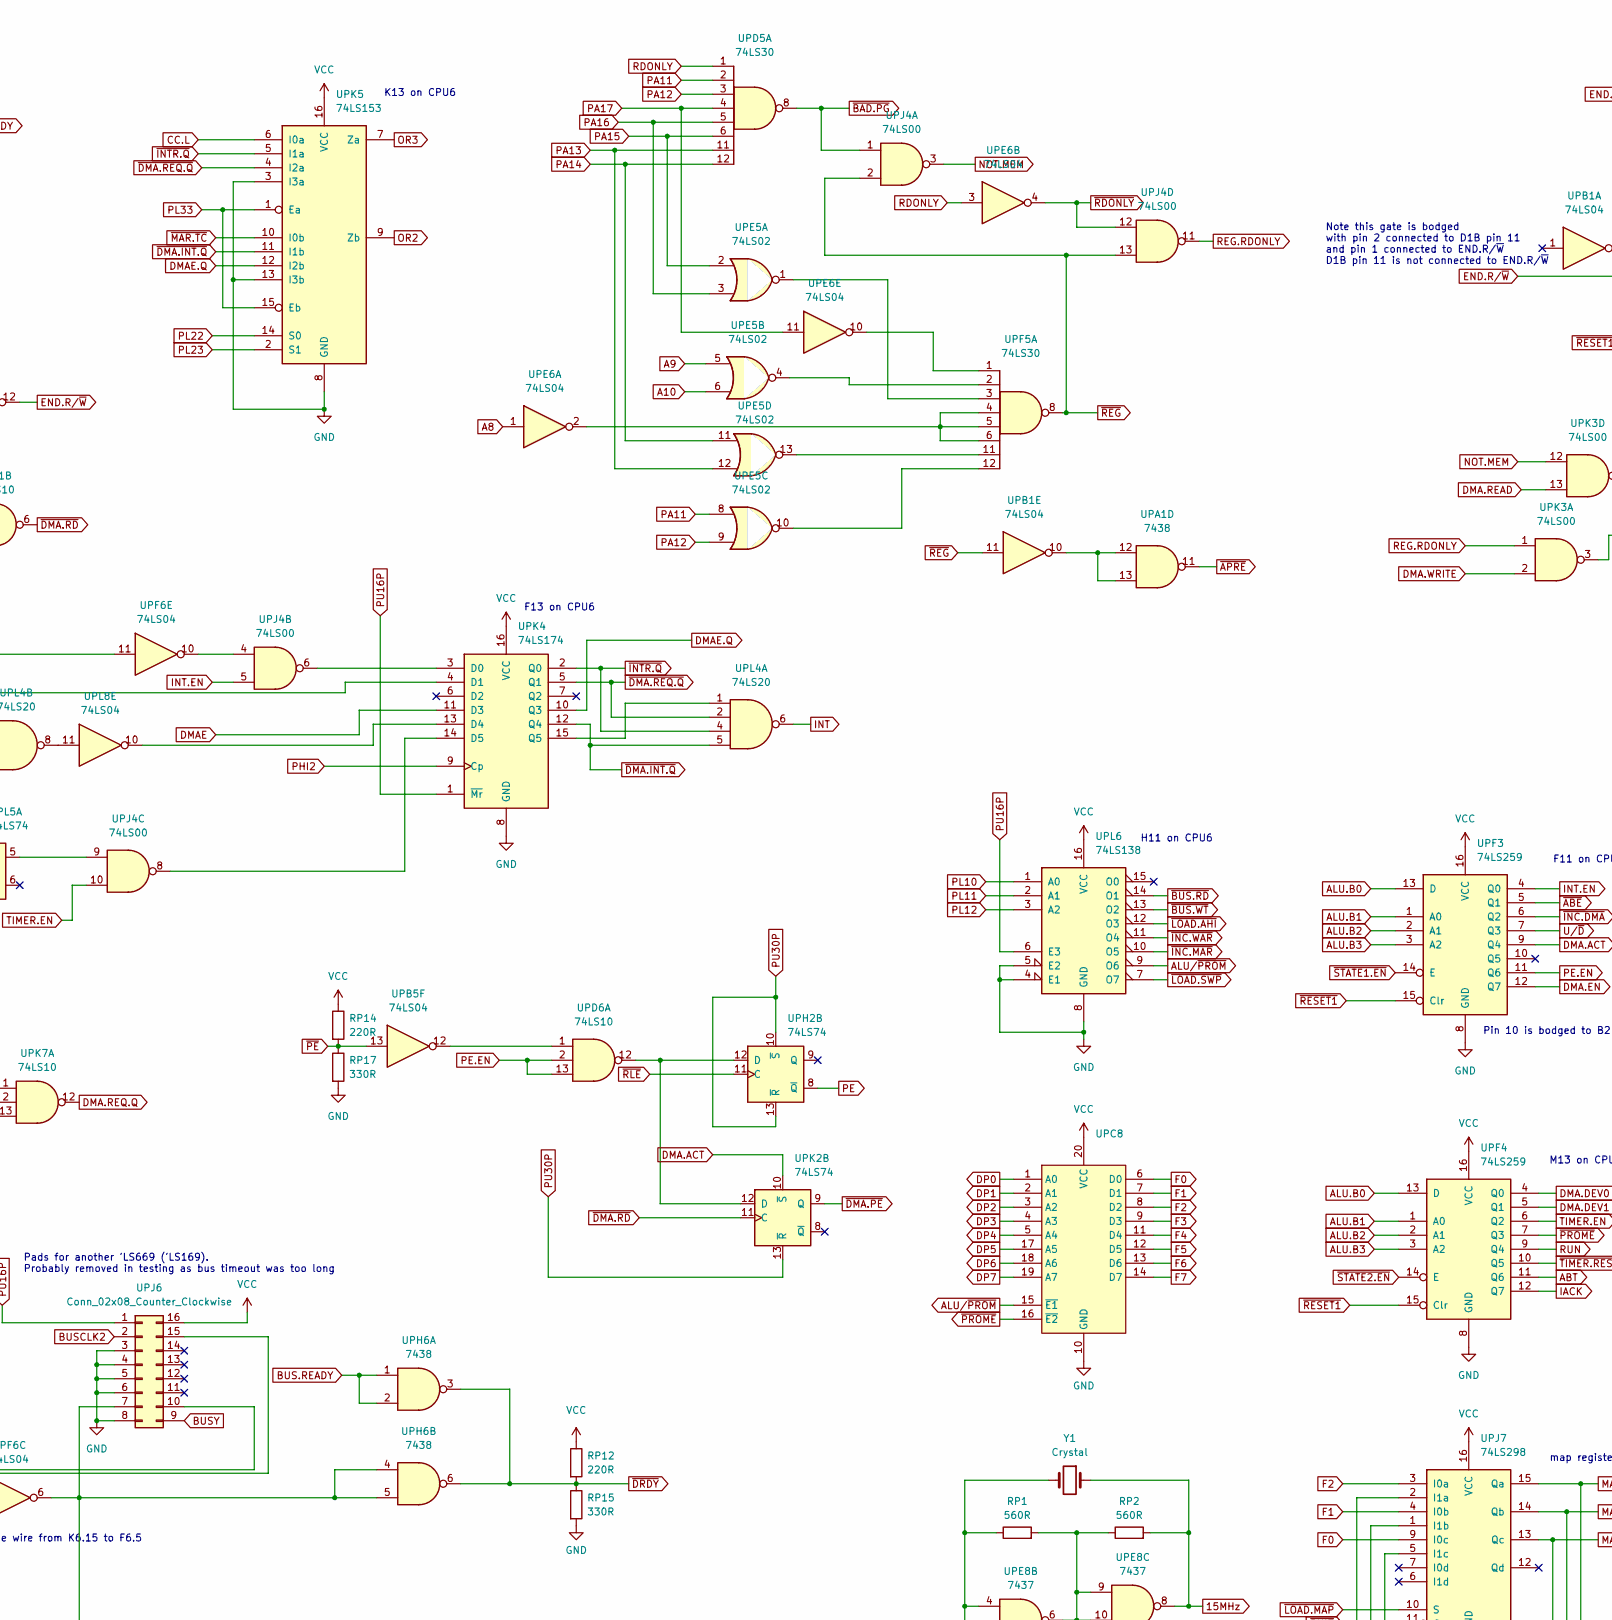
[picture p7: schematic CPU5PA.kicad_sch, part in row 1, column 2]

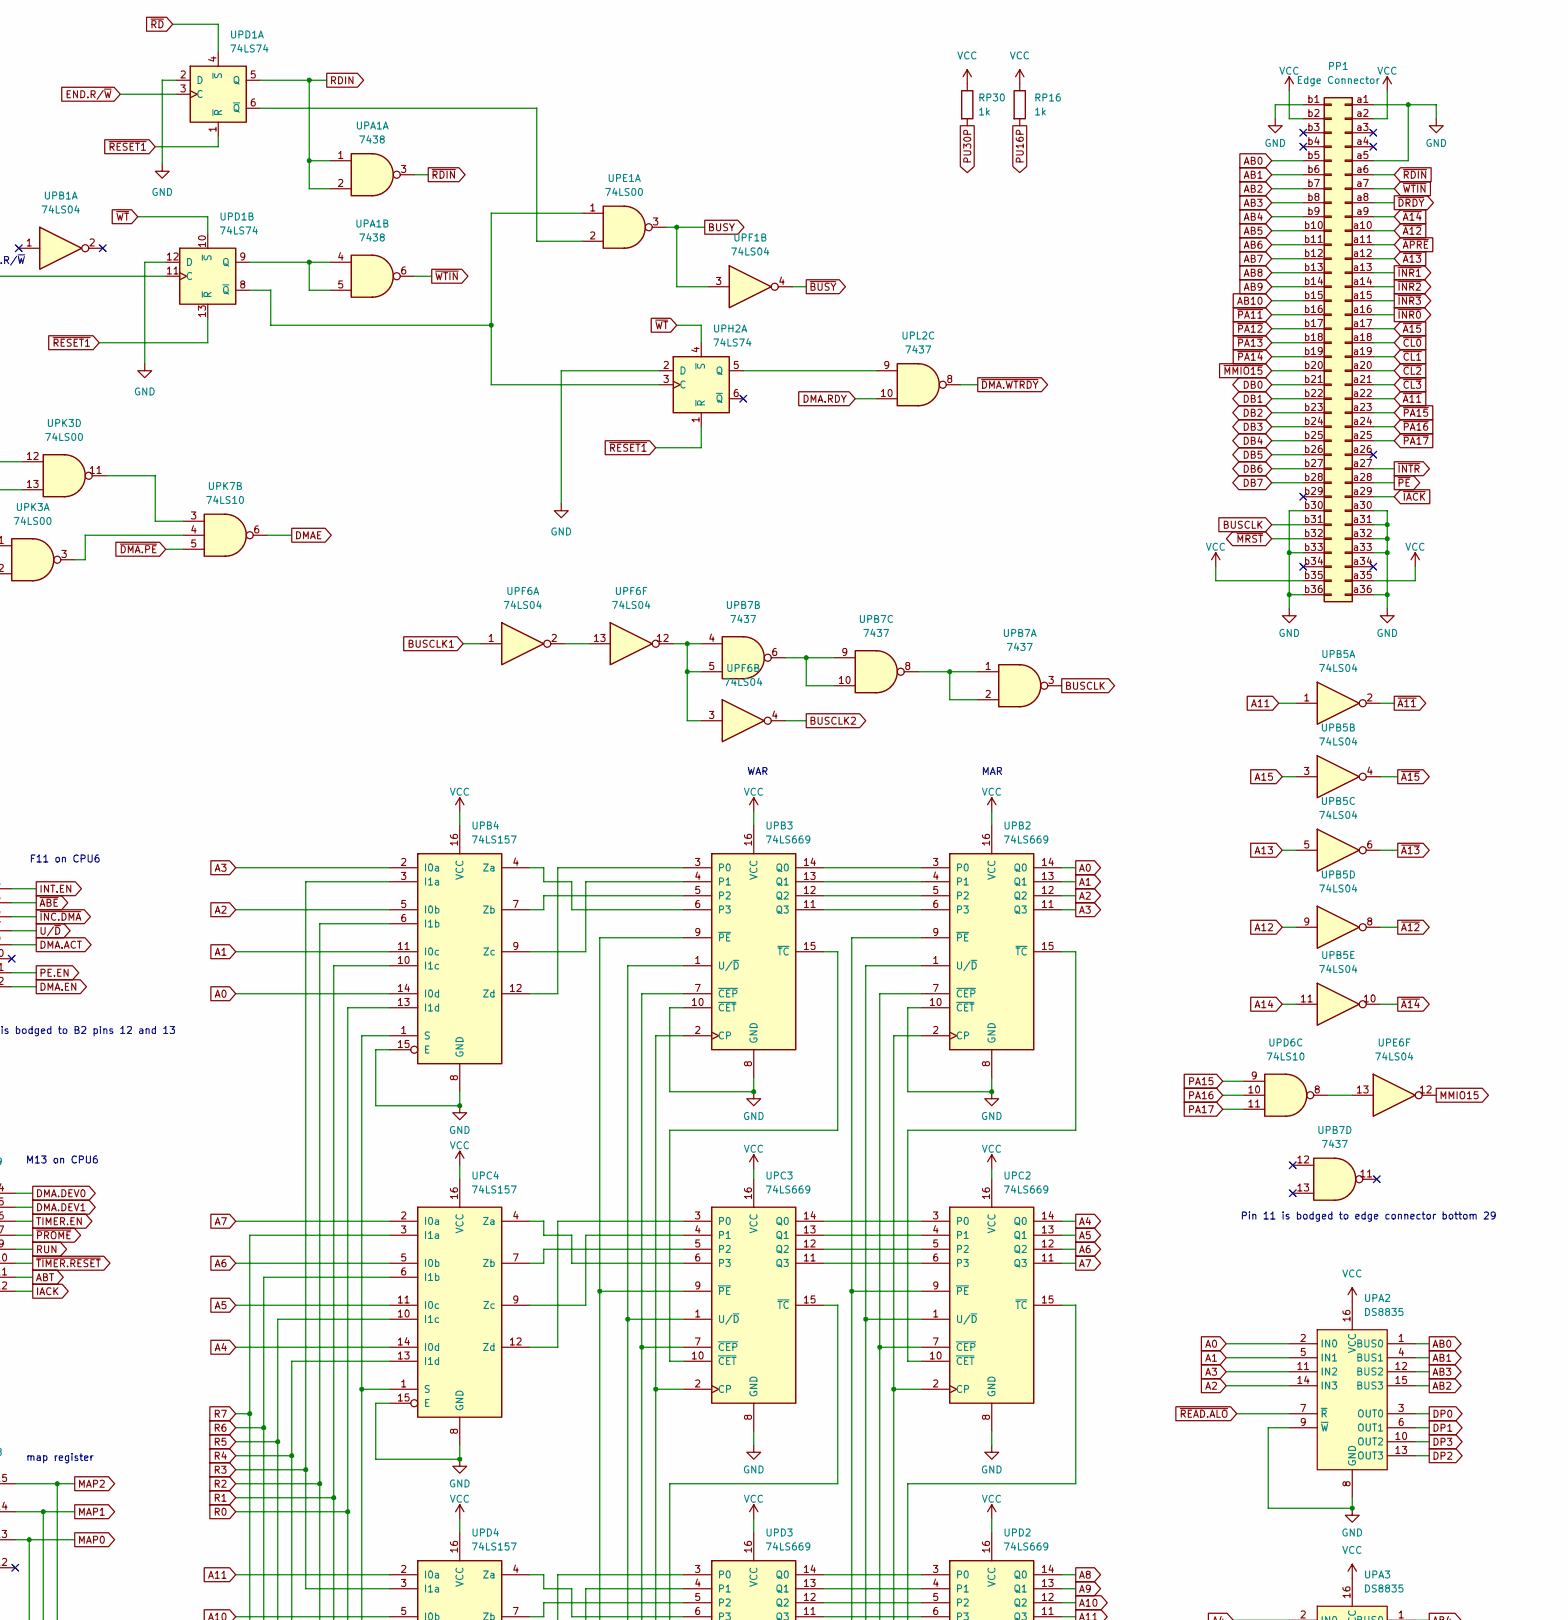
[picture p8: schematic CPU5PA.kicad_sch, part in row 1, column 3]

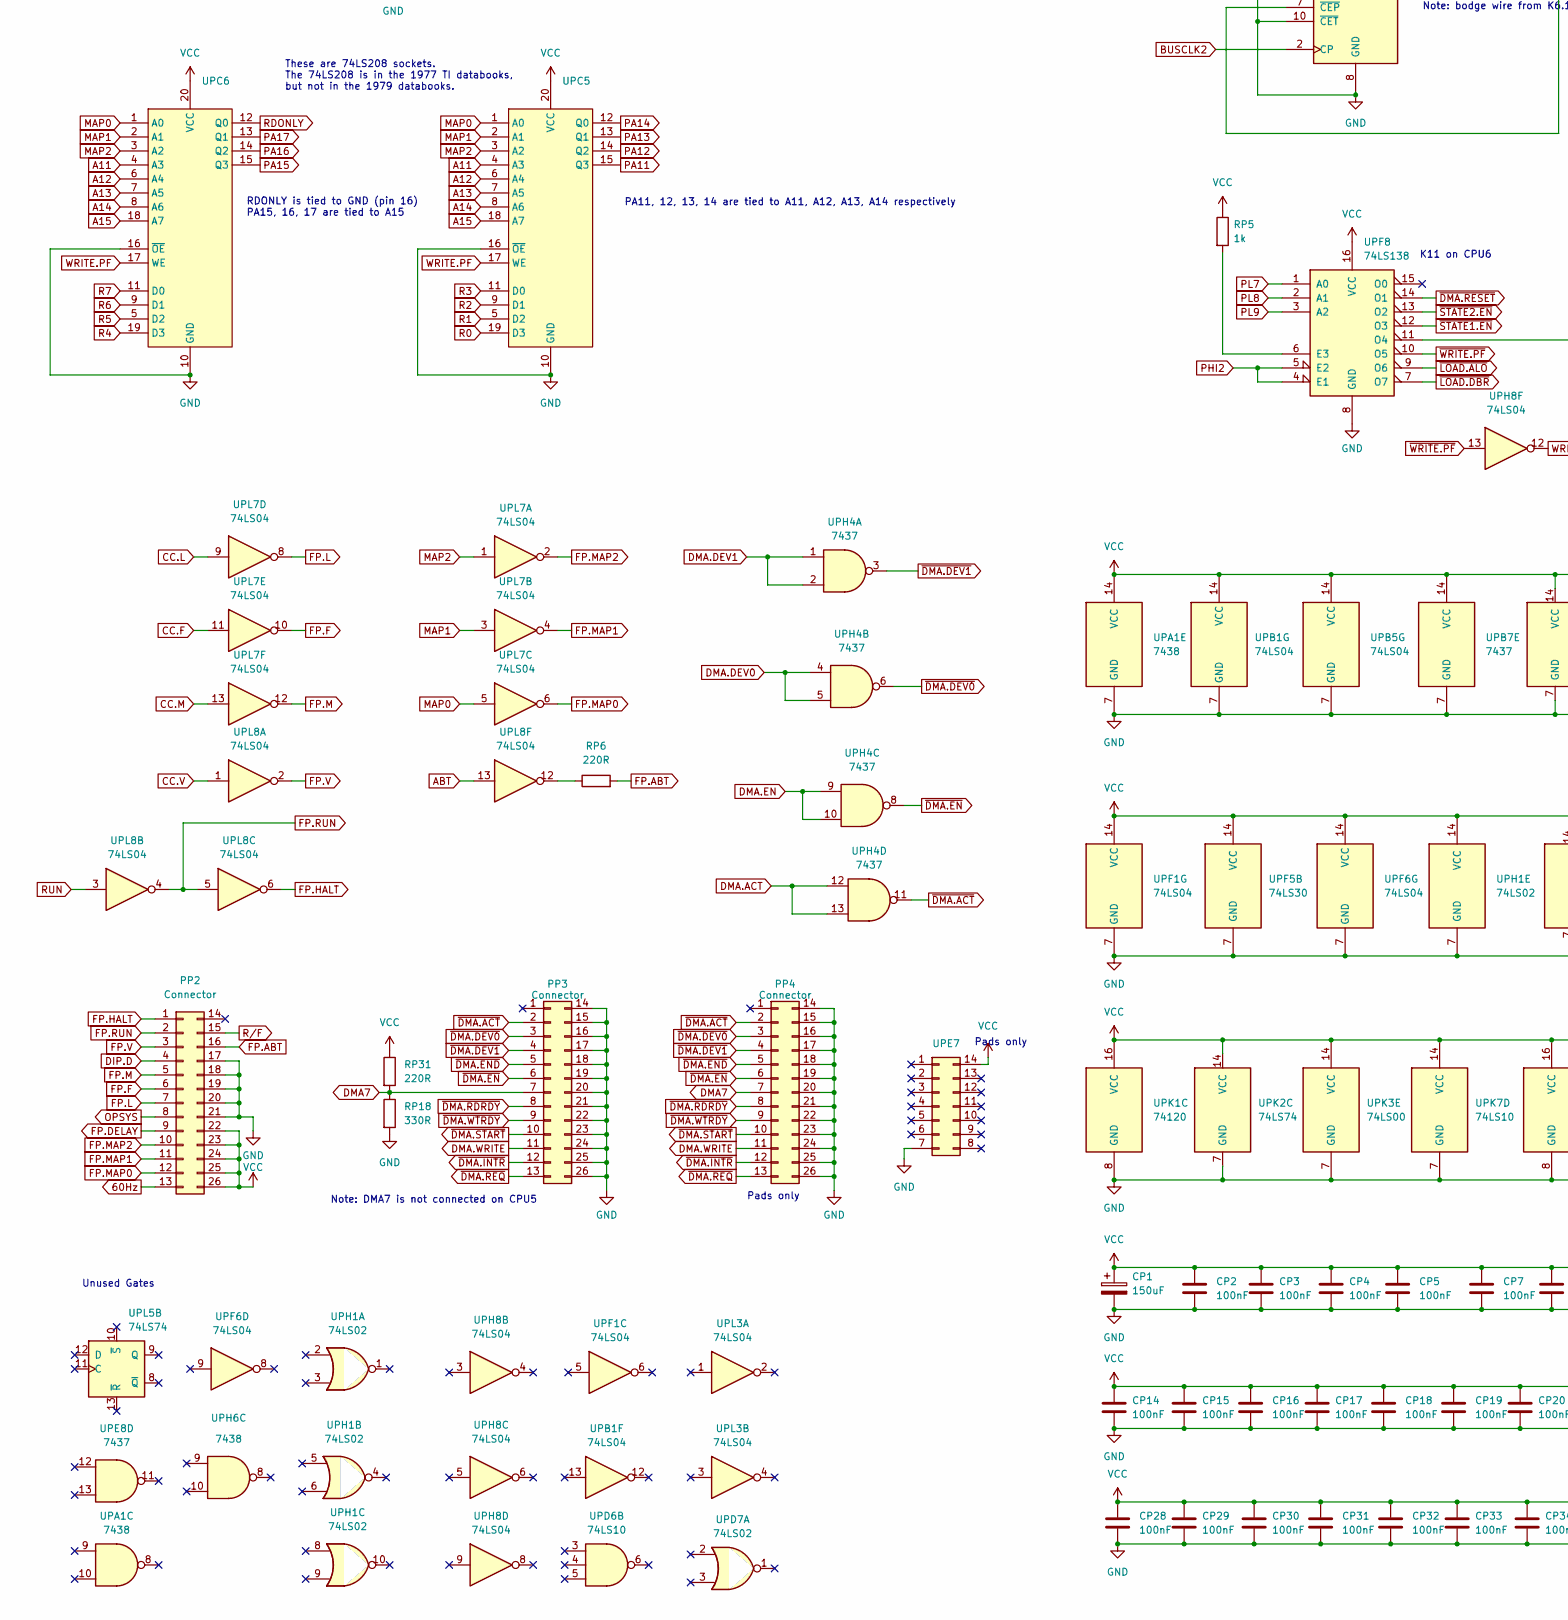
[picture p9: schematic CPU5PA.kicad_sch, part in row 2, column 1]

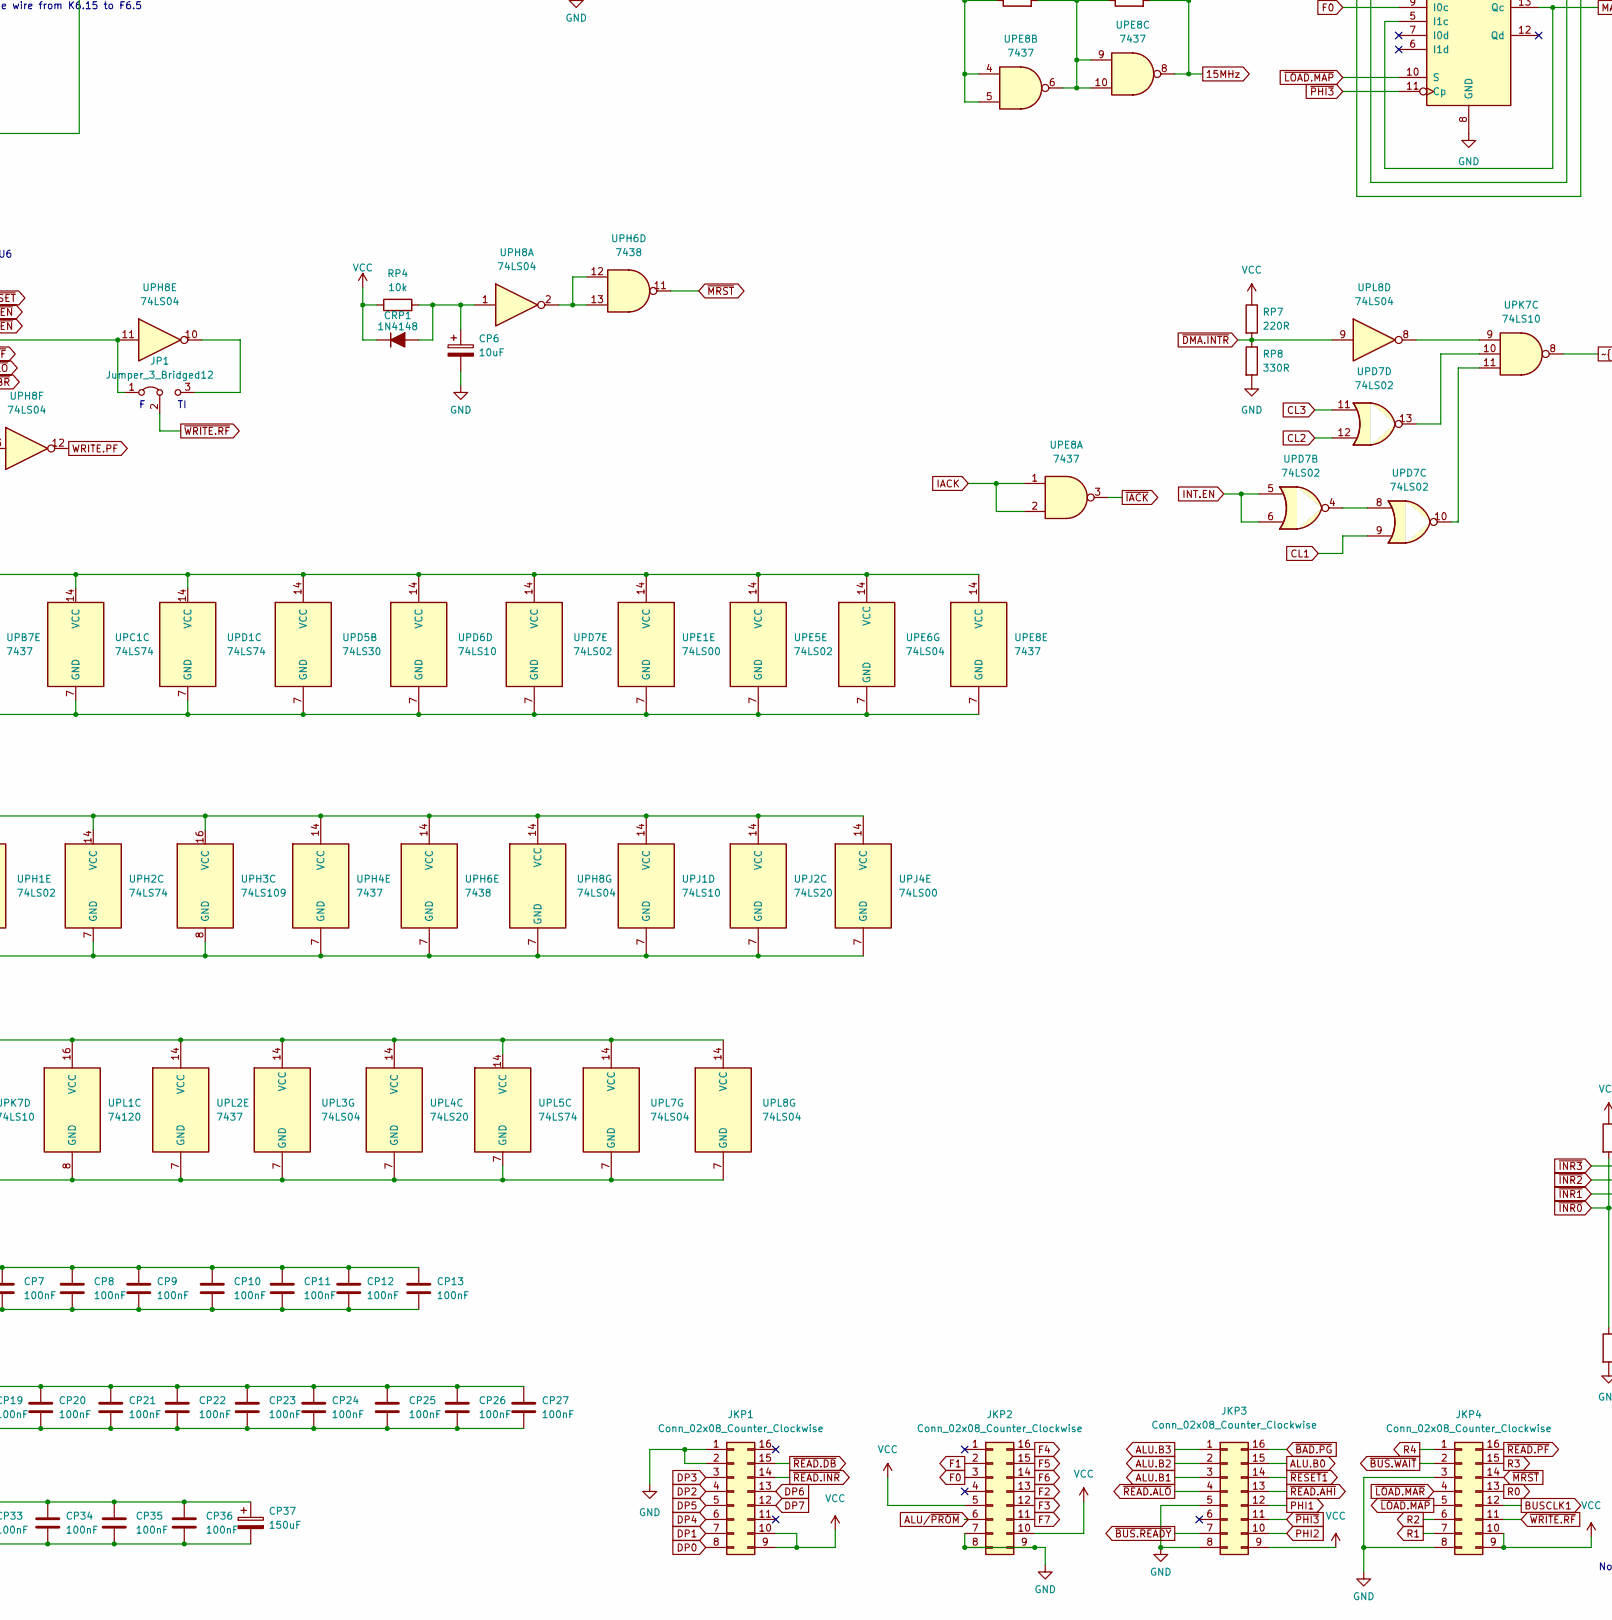
[picture p10: schematic CPU5PA.kicad_sch, part in row 2, column 2]

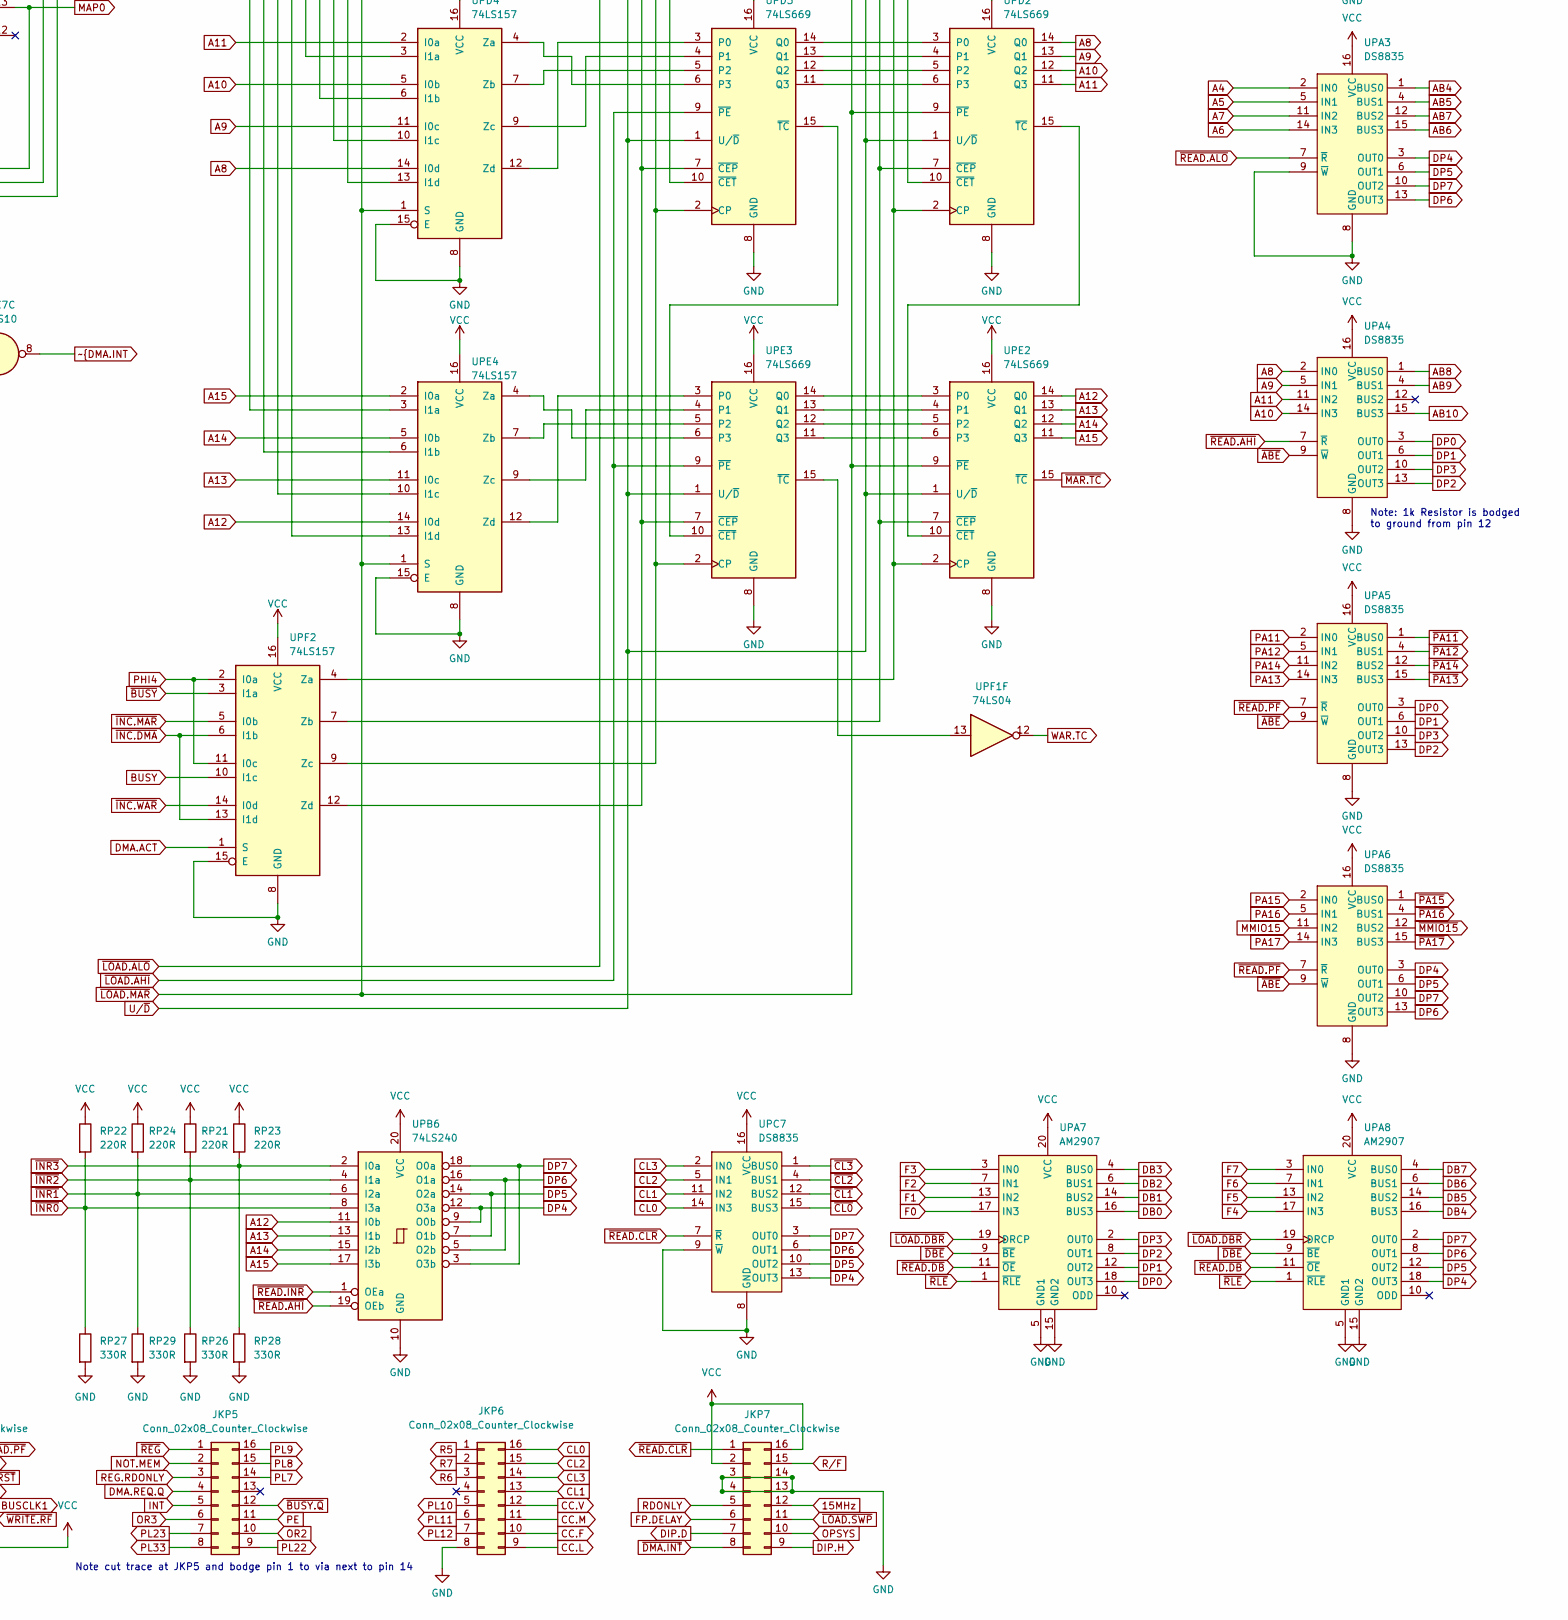
[picture p11: schematic CPU5PA.kicad_sch, part in row 2, column 3]

Parts:
CP1, CP37: 150uF; CP_Axial_L25.0mm_D10.0mm_P31.75mm_Horizontal
CP2, CP3, CP4, CP5, CP7, CP8, CP9, CP10, CP11, CP12, CP13, CP14, CP15, CP16, CP17, CP18, CP19, CP20, CP21, CP22, CP23, CP24, CP25, CP26, CP27, CP28, CP29, CP30, CP31, CP32, CP33, CP34, CP35, CP36: 100nF; C_Disc_D3.0mm_W1.6mm_P2.54mm
CP6: 10uF; CP_Axial_L18.0mm_D6.5mm_P26.67mm_Horizontal
CRP1: 1N4148; D_DO-35_SOD27_P11.43mm_Horizontal
JKP1, JKP2, JKP3, JKP4, JKP5, JKP6, JKP7: Conn_02x08_Counter_Clockwise; DIP-16_W7.62mm_cent_socket_ud
JP1: Jumper_3_Bridged12; Pads_1x03_P3.18mm
PP1: Edge Connector
PP2, PP3, PP4: Connector; IDC-Header_2x13_P2.54mm_Horizontal_TB
RP1, RP2: 560R; R_Axial_DIN0207_L6.3mm_D2.5mm_P11.43mm_Horizontal
RP4: 10k; R_Axial_DIN0207_L6.3mm_D2.5mm_P11.43mm_Horizontal
RP5, RP16, RP30: 1k; R_Axial_DIN0207_L6.3mm_D2.5mm_P11.43mm_Horizontal
RP6, RP7, RP9, RP12, RP13, RP14, RP20, RP21, RP22, RP23, RP24, RP31, RP33, RP34: 220R; R_Axial_DIN0207_L6.3mm_D2.5mm_P11.43mm_Horizontal
RP8, RP10, RP11, RP15, RP17, RP18, RP25, RP26, RP27, RP28, RP29, RP32, RP35: 330R; R_Axial_DIN0207_L6.3mm_D2.5mm_P11.43mm_Horizontal
UPA1: 7438; DIP-14_W7.62mm_cent
UPA2, UPA3, UPA4, UPA5, UPA6: DS8835; DIP-16_W7.62mm_cent
UPA7, UPA8: AM2907; DIP-20_W7.62mm_cent_socketchip
UPB1, UPB5: 74LS04; DIP-14_W7.62mm_cent
UPB2, UPB3: 74LS669; DIP-16_W7.62mm_cent
UPB4: 74LS157; DIP-16_W7.62mm_cent
UPB6: 74LS240; DIP-20_W7.62mm_cent
UPB7: 7437; DIP-14_W7.62mm_cent
UPC1: 74LS74; DIP-14_W7.62mm_cent
UPC2, UPC3: 74LS669; DIP-16_W7.62mm_cent
UPC4: 74LS157; DIP-16_W7.62mm_cent
UPC5, UPC6, UPC8: (no value)
UPC7: DS8835; DIP-16_W7.62mm_cent
UPD1: 74LS74; DIP-14_W7.62mm_cent
UPD2, UPD3: 74LS669; DIP-16_W7.62mm_cent
UPD4: 74LS157; DIP-16_W7.62mm_cent
UPD5: 74LS30; DIP-14_W7.62mm_cent
UPD6: 74LS10; DIP-14_W7.62mm_cent
UPD7: 74LS02; DIP-14_W7.62mm_cent
UPE1: 74LS00; DIP-14_W7.62mm_cent
UPE2, UPE3: 74LS669; DIP-16_W7.62mm_cent
UPE4: 74LS157; DIP-16_W7.62mm_cent
UPE5: 74LS02; DIP-14_W7.62mm_cent
UPE6: 74LS04; DIP-14_W7.62mm_cent
UPE7: Conn_02x07_Counter_Clockwise; DIP-14_W7.62mm_cent_padsonly
UPE8: 7437; DIP-14_W7.62mm_cent
UPF1, UPF6: 74LS04; DIP-14_W7.62mm_cent
UPF2: 74LS157; DIP-16_W7.62mm_cent
UPF3, UPF4: 74LS259; DIP-16_W7.62mm_cent
UPF5: 74LS30; DIP-14_W7.62mm_cent
UPF8: 74LS138; DIP-16_W7.62mm_cent
UPH1: 74LS02; DIP-14_W7.62mm_cent
UPH2: 74LS74; DIP-14_W7.62mm_cent
UPH3: 74LS109; DIP-16_W7.62mm_cent
UPH4: 7437; DIP-14_W7.62mm_cent
UPH6: 7438; DIP-14_W7.62mm_cent
UPH8: 74LS04; DIP-14_W7.62mm_cent
UPJ1: 74LS10; DIP-14_W7.62mm_cent
UPJ2: 74LS20; DIP-14_W7.62mm_cent
UPJ4: 74LS00; DIP-14_W7.62mm_cent
UPJ6: Conn_02x08_Counter_Clockwise; DIP-16_W7.62mm_cent_padsonly
UPJ7: 74LS298; DIP-16_W7.62mm_cent
UPK1: 74120; DIP-16_W7.62mm_cent
UPK2: 74LS74; DIP-14_W7.62mm_cent
UPK3: 74LS00; DIP-14_W7.62mm_cent
UPK4: 74LS174; DIP-16_W7.62mm_cent
UPK5: 74LS153; DIP-16_W7.62mm_cent
UPK6: 74LS669; DIP-16_W7.62mm_cent
UPK7: 74LS10; DIP-14_W7.62mm_cent
UPL1: 74120; DIP-16_W7.62mm_cent
UPL2: 7437; DIP-14_W7.62mm_cent
UPL3, UPL7, UPL8: 74LS04; DIP-14_W7.62mm_cent
UPL4: 74LS20; DIP-14_W7.62mm_cent
UPL5: 74LS74; DIP-14_W7.62mm_cent
UPL6: 74LS138; DIP-16_W7.62mm_cent
Y1: Crystal; Crystal_HC49-U_Horizontal_P5.08mm

Connections:
15MHz: JKP7.12, RP2.2, UPE8.8, Y1.1
60Hz: PP2.13, RP10.1, RP13.2, UPL5.3 (C)
A0: UPA2.2 (IN0), UPB2.14 (Q0), UPB4.14 (I0d)
A1: UPA2.5 (IN1), UPB2.13 (Q1), UPB4.11 (I0c)
A2: UPA2.14 (IN3), UPB2.12 (Q2), UPB4.5 (I0b)
A3: UPA2.11 (IN2), UPB2.11 (Q3), UPB4.2 (I0a)
A4: UPA3.2 (IN0), UPC2.14 (Q0), UPC4.14 (I0d)
A5: UPA3.5 (IN1), UPC2.13 (Q1), UPC4.11 (I0c)
A6: UPA3.14 (IN3), UPC2.12 (Q2), UPC4.5 (I0b)
A7: UPA3.11 (IN2), UPC2.11 (Q3), UPC4.2 (I0a)
A8: UPA4.2 (IN0), UPD2.14 (Q0), UPD4.14 (I0d), UPE6.1
A9: UPA4.5 (IN1), UPD2.13 (Q1), UPD4.11 (I0c), UPE5.5
A10: UPA4.14 (IN3), UPD2.12 (Q2), UPD4.5 (I0b), UPE5.6
A11: UPA4.11 (IN2), UPB5.1, UPC5.4 (A3), UPC6.4 (A3), UPD2.11 (Q3), UPD4.2 (I0a)
A12: UPB5.9, UPB6.11 (I0b), UPC5.6 (A4), UPC6.6 (A4), UPE2.14 (Q0), UPE4.14 (I0d)
A13: UPB5.5, UPB6.13 (I1b), UPC5.7 (A5), UPC6.7 (A5), UPE2.13 (Q1), UPE4.11 (I0c)
A14: UPB5.11, UPB6.15 (I2b), UPC5.8 (A6), UPC6.8 (A6), UPE2.12 (Q2), UPE4.5 (I0b)
A15: UPB5.3, UPB6.17 (I3b), UPC5.18 (A7), UPC6.18 (A7), UPE2.11 (Q3), UPE4.2 (I0a)
AB0: PP1.b5, UPA2.1 (BUS0)
AB1: PP1.b6, UPA2.4 (BUS1)
AB2: PP1.b7, UPA2.15 (BUS3)
AB3: PP1.b8, UPA2.12 (BUS2)
AB4: PP1.b9, UPA3.1 (BUS0)
AB5: PP1.b10, UPA3.4 (BUS1)
AB6: PP1.b11, UPA3.15 (BUS3)
AB7: PP1.b12, UPA3.12 (BUS2)
AB8: PP1.b13, UPA4.1 (BUS0)
AB9: PP1.b14, UPA4.4 (BUS1)
AB10: PP1.b15, UPA4.15 (BUS3)
ABT: UPF4.11 (Q6), UPL8.13
ALU.B0: JKP3.15, UPF3.13 (D), UPF4.13 (D)
ALU.B1: JKP3.3, UPF3.1 (A0), UPF4.1 (A0)
ALU.B2: JKP3.2, UPF3.2 (A1), UPF4.2 (A1)
ALU.B3: JKP3.1, UPF3.3 (A2), UPF4.3 (A2)
ALU/~PROM: JKP2.6, UPC8.15 (~E1), UPL6.9 (O6)
BUS.READY: UPC1.5 (Q), UPH6.1, UPH6.2
BUSCLK: PP1.b31, UPB7.3
BUSCLK1: JKP4.12, UPF6.1
BUSCLK2: UPF6.4, UPJ6.2, UPK6.2 (CP)
BUSY: UPB1.3, UPE1.3, UPF1.3, UPF2.10 (I1c), UPJ6.9, UPK6.9 (~PE)
CC.F: JKP6.10, UPL7.11
CC.L: JKP6.9, UPK5.6 (I0a), UPL7.9
CC.M: JKP6.11, UPL7.13
CC.V: JKP6.12, UPL8.1
CL0: JKP6.16, UPC7.14 (IN3)
CL1: JKP6.13, UPC7.11 (IN2), UPD7.9
CL2: JKP6.15, UPC7.5 (IN1), UPD7.12
CL3: JKP6.14, UPC7.2 (IN0), UPD7.11
DB0: PP1.b21, UPA7.16 (BUS3)
DB1: PP1.b22, UPA7.14 (BUS2)
DB2: PP1.b23, UPA7.6 (BUS1)
DB3: PP1.b24, UPA7.4 (BUS0)
DB4: PP1.b25, UPA8.16 (BUS3)
DB5: PP1.b26, UPA8.14 (BUS2)
DB6: PP1.b27, UPA8.6 (BUS1)
DB7: PP1.b28, UPA8.4 (BUS0)
DIP.D: JKP7.7, PP2.4
DIP.H: JKP7.9, UPL4.9
DMA7: PP3.7, PP4.7, RP18.1, RP31.2
DMA.ACT: UPF2.1 (S), UPF3.9 (Q4), UPH4.12, UPH4.13, UPK2.10 (~S)
DMA.CLK: UPJ1.2, UPJ1.3, UPK1.6 (1Y)
DMA.DEV0: UPF4.4 (Q0), UPH4.4, UPH4.5
DMA.DEV1: UPF4.5 (Q1), UPH4.1, UPH4.2
DMA.EN: UPE1.13, UPF3.12 (Q7), UPH4.9, UPH4.10
DMA.END: UPH3.7 (~Q), UPL2.12, UPL2.13
DMA.RDY: UPE1.10, UPF1.10, UPH1.11, UPJ1.5, UPJ2.2, UPJ2.12, UPK1.1 (1M), UPL2.10
DMA.READ: UPJ1.4, UPJ2.1, UPK3.13, UPL3.6
DMA.REQ.Q: JKP5.4, UPK7.12
DMA.START: UPJ2.4, UPJ2.5, UPJ2.10, UPL3.12
DMA.WRITE: PP3.11, PP4.11, RP34.2, RP35.1, UPJ2.9, UPK3.2, UPL3.5
DMAE: UPK4.11 (D3), UPK7.6
DMAE.Q: UPK4.10 (Q3), UPK5.12 (I2b)
DP0: JKP1.8, UPA2.3 (OUT0), UPA4.3 (OUT0), UPA5.3 (OUT0), UPA7.18 (OUT3), UPC8.1 (A0)
DP1: JKP1.7, UPA2.6 (OUT1), UPA4.6 (OUT1), UPA5.6 (OUT1), UPA7.12 (OUT2), UPC8.2 (A1)
DP2: JKP1.4, UPA2.13 (OUT3), UPA4.13 (OUT3), UPA5.13 (OUT3), UPA7.8 (OUT1), UPC8.3 (A2)
DP3: JKP1.3, UPA2.10 (OUT2), UPA4.10 (OUT2), UPA5.10 (OUT2), UPA7.2 (OUT0), UPC8.4 (A3)
DP4: JKP1.6, UPA3.3 (OUT0), UPA6.3 (OUT0), UPA8.18 (OUT3), UPB6.9 (O0b), UPB6.12 (O3a), UPC7.13 (OUT3), UPC8.5 (A4)
DP5: JKP1.5, UPA3.6 (OUT1), UPA6.6 (OUT1), UPA8.12 (OUT2), UPB6.7 (O1b), UPB6.14 (O2a), UPC7.10 (OUT2), UPC8.17 (A5)
DP6: JKP1.13, UPA3.13 (OUT3), UPA6.13 (OUT3), UPA8.8 (OUT1), UPB6.5 (O2b), UPB6.16 (O1a), UPC7.6 (OUT1), UPC8.18 (A6)
DP7: JKP1.12, UPA3.10 (OUT2), UPA6.10 (OUT2), UPA8.2 (OUT0), UPB6.3 (O3b), UPB6.18 (O0a), UPC7.3 (OUT0), UPC8.19 (A7)
END.R/~W: UPC1.3 (C), UPD1.3 (C), UPD1.11 (C), UPJ1.12
F0: JKP2.3, UPA7.17 (IN3), UPC8.6 (D0), UPJ7.9 (I0c)
F1: JKP2.2, UPA7.13 (IN2), UPC8.7 (D1), UPJ7.4 (I0b)
F2: JKP2.13, UPA7.7 (IN1), UPC8.8 (D2), UPJ7.3 (I0a)
F3: JKP2.12, UPA7.3 (IN0), UPC8.9 (D3)
F4: JKP2.16, UPA8.17 (IN3), UPC8.11 (D4)
F5: JKP2.15, UPA8.13 (IN2), UPC8.12 (D5)
F6: JKP2.14, UPA8.7 (IN1), UPC8.13 (D6)
F7: JKP2.11, UPA8.3 (IN0), UPC8.14 (D7)
FP.ABT: PP2.16, RP6.2
FP.DELAY: JKP7.6, PP2.9
FP.F: PP2.6, UPL7.10
FP.HALT: PP2.1, UPL8.6
FP.L: PP2.7, UPL7.8
FP.M: PP2.5, UPL7.12
FP.MAP0: PP2.12, UPL7.6
FP.MAP1: PP2.11, UPL7.4
FP.MAP2: PP2.10, UPL7.2
FP.RUN: PP2.2, UPL8.4, UPL8.5
FP.V: PP2.3, UPL8.2
GND: CP1.2, CP2.2, CP3.2, CP4.2, CP5.2, CP6.2, CP7.2, CP8.2, CP9.2, CP10.2, CP11.2, CP12.2, CP13.2, CP14.2, CP15.2, CP16.2, CP17.2, CP18.2, CP19.2, CP20.2, CP21.2, CP22.2, CP23.2, CP24.2, CP25.2, CP26.2, CP27.2, CP28.2, CP29.2, CP30.2, CP31.2, CP32.2, CP33.2, CP34.2, CP35.2, CP36.2, CP37.2, JKP1.1, JKP1.2, JKP2.7, JKP2.8, JKP2.9, JKP3.5, JKP3.8, JKP4.3, JKP4.8, JKP6.8, JKP7.3, JKP7.4, JKP7.13, JKP7.14, PP1.a1, PP1.a5, PP1.a30, PP1.a31, PP1.a32, PP1.a33, PP1.a36, PP1.b1, PP1.b30, PP1.b33, PP1.b36, PP2.17, PP2.18, PP2.19, PP2.20, PP2.21, PP3.14, PP3.15, PP3.16, PP3.17, PP3.18, PP3.19, PP3.20, PP3.21, PP3.22, PP3.23, PP3.24, PP3.25, PP3.26, PP4.14, PP4.15, PP4.16, PP4.17, PP4.18, PP4.19, PP4.20, PP4.21, PP4.22, PP4.23, PP4.24, PP4.25, PP4.26, RP8.2, RP10.2, RP11.2, RP15.2, RP17.2, RP18.2, RP25.2, RP26.2, RP27.2, RP28.2, RP29.2, RP32.2, RP35.2, UPA1.7 (GND), UPA2.8 (GND), UPA2.9 (~W), UPA3.8 (GND), UPA3.9 (~W), UPA4.8 (GND), UPA5.8 (GND), UPA6.8 (GND), UPA7.5 (GND1), UPA7.15 (GND2), UPA8.5 (GND1), UPA8.15 (GND2), UPB1.7 (GND), UPB2.8 (GND), UPB2.10 (~CET), UPB3.8 (GND), UPB3.10 (~CET), UPB4.8 (GND), UPB4.15 (E), UPB5.7 (GND), UPB6.10 (GND), UPB7.7 (GND), UPC1.2 (D), UPC1.7 (GND), UPC1.12 (D), UPC2.8 (GND), UPC3.8 (GND), UPC4.8 (GND), UPC4.15 (E), UPC5.10 (GND), UPC5.16 (~OE), UPC6.10 (GND), UPC6.16 (~OE), UPC7.8 (GND), UPC7.9 (~W), UPC8.10 (GND), UPD1.2 (D), UPD1.7 (GND), UPD1.12 (D), UPD2.8 (GND), UPD3.8 (GND), UPD4.8 (GND), UPD4.15 (E), UPD5.7 (GND), UPD6.7 (GND), UPD7.7 (GND), UPE1.7 (GND), UPE2.8 (GND), UPE3.8 (GND), UPE4.8 (GND), UPE4.15 (E), UPE5.7 (GND), UPE6.7 (GND), UPE7.7, UPE8.7 (GND), UPF1.7 (GND), UPF2.8 (GND), UPF2.15 (E), UPF3.8 (GND), UPF4.8 (GND), UPF5.7 (GND), UPF6.7 (GND), UPF8.8 (GND), UPH1.7 (GND), UPH2.2 (D), UPH2.7 (GND), UPH3.2 (J), UPH3.8 (GND), UPH4.7 (GND), UPH6.7 (GND), UPH8.7 (GND), UPJ1.7 (GND), UPJ2.7 (GND), UPJ4.7 (GND), UPJ6.3, UPJ6.4, UPJ6.5, UPJ6.6, UPJ6.8, UPJ7.8 (GND), UPK1.8 (GND), UPK1.12 (2~R), UPK2.2 (D), UPK2.7 (GND), UPK3.7 (GND), UPK4.8 (GND), UPK5.3 (I3a), UPK5.8 (GND), UPK5.13 (I3b), UPK6.3 (P0), UPK6.4 (P1), UPK6.5 (P2), UPK6.6 (P3), UPK6.8 (GND), UPK6.10 (~CET), UPK7.7 (GND), UPL1.8 (GND), UPL1.12 (2~R), UPL2.7 (GND), UPL3.7 (GND), UPL4.7 (GND), UPL5.7 (GND), UPL6.4 (E1), UPL6.5 (E2), UPL6.8 (GND), UPL7.7 (GND), UPL8.7 (GND)
IACK: UPE8.1, UPE8.2, UPF4.12 (Q7)
INT: JKP5.5, UPL4.6
INT.EN: UPD7.5, UPD7.6, UPF3.4 (Q0), UPJ4.5
MAP0: UPC5.1 (A0), UPC6.1 (A0), UPJ7.5 (I1c), UPJ7.13 (Qc), UPL7.5
MAP1: UPC5.2 (A1), UPC6.2 (A1), UPJ7.1 (I1b), UPJ7.14 (Qb), UPL7.3
MAP2: UPC5.3 (A2), UPC6.3 (A2), UPJ7.2 (I1a), UPJ7.15 (Qa), UPL7.1
MMIO15: UPA6.11 (IN2), UPE6.12
NOT.MEM: JKP5.2, UPJ4.3, UPK3.12
unnamed: CP6.1, CRP1.2 (A), RP4.2, UPH8.1
unnamed: JP1.1 (A), UPF8.11 (O4), UPH8.11
unnamed: JP1.3 (B), UPH8.10
unnamed: RP1.1, UPE8.4, UPE8.5, Y1.2
unnamed: RP1.2, RP2.1, UPE8.6, UPE8.9, UPE8.10
unnamed: RP5.2, UPF8.6 (E3)
unnamed: RP6.1, UPL8.12
unnamed: UPA1.4, UPA1.5, UPD1.9 (Q)
unnamed: UPA1.12, UPA1.13, UPB1.10
unnamed: UPB1.4, UPB1.5
unnamed: UPB1.6, UPB1.9
unnamed: UPB1.8, UPC1.11 (C)
unnamed: UPB2.2 (CP), UPC2.2 (CP), UPD2.2 (CP), UPE2.2 (CP), UPF2.4 (Za)
unnamed: UPB2.3 (P0), UPB3.14 (Q0)
unnamed: UPB2.4 (P1), UPB3.13 (Q1)
unnamed: UPB2.5 (P2), UPB3.12 (Q2)
unnamed: UPB2.6 (P3), UPB3.11 (Q3)
unnamed: UPB2.7 (~CEP), UPC2.7 (~CEP), UPD2.7 (~CEP), UPE2.7 (~CEP), UPF2.7 (Zb)
unnamed: UPB2.15 (~TC), UPC2.10 (~CET)
unnamed: UPB3.2 (CP), UPC3.2 (CP), UPD3.2 (CP), UPE3.2 (CP), UPF2.9 (Zc)
unnamed: UPB3.3 (P0), UPB4.12 (Zd)
unnamed: UPB3.4 (P1), UPB4.9 (Zc)
unnamed: UPB3.5 (P2), UPB4.7 (Zb)
unnamed: UPB3.6 (P3), UPB4.4 (Za)
unnamed: UPB3.7 (~CEP), UPC3.7 (~CEP), UPD3.7 (~CEP), UPE3.7 (~CEP), UPF2.12 (Zd)
unnamed: UPB3.15 (~TC), UPC3.10 (~CET)
unnamed: UPB5.12, UPD6.1
unnamed: UPB7.1, UPB7.2, UPB7.8
unnamed: UPB7.4, UPB7.5, UPF6.3, UPF6.12
unnamed: UPB7.6, UPB7.9, UPB7.10
unnamed: UPC2.3 (P0), UPC3.14 (Q0)
unnamed: UPC2.4 (P1), UPC3.13 (Q1)
unnamed: UPC2.5 (P2), UPC3.12 (Q2)
unnamed: UPC2.6 (P3), UPC3.11 (Q3)
unnamed: UPC2.15 (~TC), UPD2.10 (~CET)
unnamed: UPC3.3 (P0), UPC4.12 (Zd)
unnamed: UPC3.4 (P1), UPC4.9 (Zc)
unnamed: UPC3.5 (P2), UPC4.7 (Zb)
unnamed: UPC3.6 (P3), UPC4.4 (Za)
unnamed: UPC3.15 (~TC), UPD3.10 (~CET)
unnamed: UPD1.6 (~Q), UPE1.2
unnamed: UPD1.8 (~Q), UPE1.1, UPH2.3 (C)
unnamed: UPD2.3 (P0), UPD3.14 (Q0)
unnamed: UPD2.4 (P1), UPD3.13 (Q1)
unnamed: UPD2.5 (P2), UPD3.12 (Q2)
unnamed: UPD2.6 (P3), UPD3.11 (Q3)
unnamed: UPD2.15 (~TC), UPE2.10 (~CET)
unnamed: UPD3.3 (P0), UPD4.12 (Zd)
unnamed: UPD3.4 (P1), UPD4.9 (Zc)
unnamed: UPD3.5 (P2), UPD4.7 (Zb)
unnamed: UPD3.6 (P3), UPD4.4 (Za)
unnamed: UPD3.15 (~TC), UPE3.10 (~CET)
unnamed: UPD6.8, UPE6.13
unnamed: UPD6.12, UPH2.12 (D), UPK2.12 (D)
unnamed: UPD7.4, UPD7.8
unnamed: UPD7.10, UPK7.11
unnamed: UPD7.13, UPK7.10
unnamed: UPE1.5, UPH1.13
unnamed: UPE1.8, UPH3.3 (~K)
unnamed: UPE1.11, UPF1.11, UPJ1.9, UPJ1.10
unnamed: UPE1.12, UPF1.2
unnamed: UPE2.3 (P0), UPE3.14 (Q0)
unnamed: UPE2.4 (P1), UPE3.13 (Q1)
unnamed: UPE2.5 (P2), UPE3.12 (Q2)
unnamed: UPE2.6 (P3), UPE3.11 (Q3)
unnamed: UPE3.3 (P0), UPE4.12 (Zd)
unnamed: UPE3.4 (P1), UPE4.9 (Zc)
unnamed: UPE3.5 (P2), UPE4.7 (Zb)
unnamed: UPE3.6 (P3), UPE4.4 (Za)
unnamed: UPE3.15 (~TC), UPF1.13
unnamed: UPE5.1, UPF5.3
unnamed: UPE5.4, UPF5.2
unnamed: UPE5.10, UPF5.12
unnamed: UPE5.13, UPF5.11
unnamed: UPE6.2, UPF5.4, UPF5.5, UPF5.6
unnamed: UPE6.6, UPE6.9
unnamed: UPE6.8, UPK1.2 (1~S1), UPK1.3 (1~S2), UPL1.2 (1~S1)
unnamed: UPE6.10, UPF5.1
unnamed: UPF1.8, UPL1.3 (1~S2)
unnamed: UPF6.5, UPJ6.15
unnamed: UPF6.6, UPH6.4, UPH6.5, UPJ6.7, UPK6.7 (~CEP)
unnamed: UPF6.10, UPJ4.4
unnamed: UPF6.2, UPF6.13
unnamed: UPH2.5 (Q), UPL2.9
unnamed: UPH6.12, UPH6.13, UPH8.2
unnamed: UPJ1.1, UPJ1.8
unnamed: UPJ2.6, UPK1.13 (2~S1)
unnamed: UPJ2.8, UPL1.13 (2~S1)
unnamed: UPJ4.6, UPK4.3 (D0)
unnamed: UPJ4.8, UPK4.14 (D5)
unnamed: UPJ4.9, UPL5.5 (Q)
unnamed: UPJ6.10, UPK6.15 (~TC)
unnamed: UPK1.4 (1~R), UPL1.1 (1M), UPL1.4 (1~R)
unnamed: UPK2.5 (Q), UPL2.1, UPL2.2
unnamed: UPK3.3, UPK7.4
unnamed: UPK3.5, UPK3.8
unnamed: UPK3.6, UPL1.14 (2~S2)
unnamed: UPK3.11, UPK7.3
unnamed: UPK4.13 (D4), UPL8.10
unnamed: UPK4.15 (Q5), UPL4.1
unnamed: UPK7.9, UPL8.8
unnamed: UPL3.9, UPL3.10
unnamed: UPL4.8, UPL8.11
OPSYS: JKP7.10, PP2.8
OR2: JKP5.10, UPK5.9 (Zb)
OR3: JKP5.6, UPK5.7 (Za)
PA11: UPA5.2 (IN0), UPC5.15 (Q3), UPD5.2, UPE5.8
PA12: UPA5.5 (IN1), UPC5.14 (Q2), UPD5.3, UPE5.9
PA13: UPA5.14 (IN3), UPC5.13 (Q1), UPD5.11, UPE5.12
PA14: UPA5.11 (IN2), UPC5.12 (Q0), UPD5.12, UPE5.11
PA15: UPA6.2 (IN0), UPC6.15 (Q3), UPD5.6, UPD6.9, UPE5.2
PA16: UPA6.5 (IN1), UPC6.14 (Q2), UPD5.5, UPD6.10, UPE5.3
PA17: UPA6.14 (IN3), UPC6.13 (Q1), UPD5.4, UPD6.11, UPE6.11
PE: JKP5.11, UPH2.8 (~Q)
PE.EN: UPD6.2, UPD6.13, UPF3.11 (Q6)
PHI1: JKP3.12, UPH3.4 (C), UPK1.5 (1C), UPK1.11 (2C), UPK2.3 (C), UPL1.5 (1C), UPL1.11 (2C)
PHI2: JKP3.10, UPF8.4 (E1), UPF8.5 (E2), UPH3.12 (C), UPK4.9 (Cp), UPL2.6
PHI4: UPF2.2 (I0a), UPF2.11 (I0c), UPL1.7 (1~Y)
PHI5: UPJ1.13, UPL1.6 (1Y), UPL2.4, UPL2.5, UPL3.11
PL7: JKP5.14, UPF8.1 (A0)
PL8: JKP5.15, UPF8.2 (A1)
PL9: JKP5.16, UPF8.3 (A2)
PL10: JKP6.5, UPL6.1 (A0)
PL11: JKP6.6, UPL6.2 (A1)
PL12: JKP6.7, UPL6.3 (A2)
PL22: JKP5.9, UPK5.14 (S0)
PL23: JKP5.7, UPK5.2 (S1)
PL33: JKP5.8, UPK5.1 (Ea), UPK5.15 (Eb)
PU16P: RP16.2, UPJ6.1, UPK4.1 (~Mr), UPK6.1 (U/~D), UPL6.6 (E3)
PU30P: RP30.2, UPH2.10 (~S), UPH2.13 (~R), UPH3.1 (~R), UPK2.13 (~R), UPL5.2 (D), UPL5.4 (~S)
R0: JKP4.13, UPB4.13 (I1d), UPC5.19 (D3), UPD4.13 (I1d)
R1: JKP4.7, UPB4.10 (I1c), UPC5.5 (D2), UPD4.10 (I1c)
R2: JKP4.6, UPB4.6 (I1b), UPC5.9 (D1), UPD4.6 (I1b)
R3: JKP4.15, UPB4.3 (I1a), UPC5.11 (D0), UPD4.3 (I1a)
R4: JKP4.1, UPC4.13 (I1d), UPC6.19 (D3), UPE4.13 (I1d)
R5: JKP6.1, UPC4.10 (I1c), UPC6.5 (D2), UPE4.10 (I1c)
R6: JKP6.3, UPC4.6 (I1b), UPC6.9 (D1), UPE4.6 (I1b)
R7: JKP6.2, UPC4.3 (I1a), UPC6.11 (D0), UPE4.3 (I1a)
RDIN: UPA1.1, UPA1.2, UPD1.5 (Q), UPE1.4
RDONLY: JKP7.5, UPC6.12 (Q0), UPD5.1, UPE6.3
REG.RDONLY: JKP5.3, UPJ4.11, UPK3.1
RUN: UPF4.9 (Q4), UPL8.3
R/F: JKP7.15, PP2.15
TIMER.EN: UPF4.6 (Q2), UPJ4.10
U/~D: UPB2.1 (U/~D), UPB3.1 (U/~D), UPC2.1 (U/~D), UPC3.1 (U/~D), UPD2.1 (U/~D), UPD3.1 (U/~D), UPE2.1 (U/~D), UPE3.1 (U/~D), UPF3.7 (Q3)
VCC: CP1.1, CP2.1, CP3.1, CP4.1, CP5.1, CP7.1, CP8.1, CP9.1, CP10.1, CP11.1, CP12.1, CP13.1, CP14.1, CP15.1, CP16.1, CP17.1, CP18.1, CP19.1, CP20.1, CP21.1, CP22.1, CP23.1, CP24.1, CP25.1, CP26.1, CP27.1, CP28.1, CP29.1, CP30.1, CP31.1, CP32.1, CP33.1, CP34.1, CP35.1, CP36.1, CP37.1, CRP1.1 (K), JKP1.9, JKP1.10, JKP2.5, JKP3.9, JKP4.9, JKP4.10, JKP7.2, JKP7.16, PP1.a2, PP1.a35, PP1.b2, PP1.b35, PP2.22, PP2.23, PP2.24, PP2.25, PP2.26, RP4.1, RP5.1, RP7.1, RP9.1, RP12.1, RP13.1, RP14.1, RP16.1, RP20.1, RP21.1, RP22.1, RP23.1, RP24.1, RP30.1, RP31.1, RP33.1, RP34.1, UPA1.14 (VCC), UPA2.16 (VCC), UPA3.16 (VCC), UPA4.16 (VCC), UPA5.16 (VCC), UPA6.16 (VCC), UPA7.20 (VCC), UPA8.20 (VCC), UPB1.14 (VCC), UPB2.16 (VCC), UPB3.16 (VCC), UPB4.16 (VCC), UPB5.14 (VCC), UPB6.20 (VCC), UPB7.14 (VCC), UPC1.14 (VCC), UPC2.16 (VCC), UPC3.16 (VCC), UPC4.16 (VCC), UPC5.20 (VCC), UPC6.20 (VCC), UPC7.16 (VCC), UPC8.20 (VCC), UPD1.14 (VCC), UPD2.16 (VCC), UPD3.16 (VCC), UPD4.16 (VCC), UPD5.14 (VCC), UPD6.14 (VCC), UPD7.14 (VCC), UPE1.14 (VCC), UPE2.16 (VCC), UPE3.16 (VCC), UPE4.16 (VCC), UPE5.14 (VCC), UPE6.14 (VCC), UPE7.14, UPE8.14 (VCC), UPF1.14 (VCC), UPF2.16 (VCC), UPF3.16 (VCC), UPF4.16 (VCC), UPF5.14 (VCC), UPF6.14 (VCC), UPF8.16 (VCC), UPH1.14 (VCC), UPH2.14 (VCC), UPH3.11 (~S), UPH3.15 (~R), UPH3.16 (VCC), UPH4.14 (VCC), UPH6.14 (VCC), UPH8.14 (VCC), UPJ1.14 (VCC), UPJ2.14 (VCC), UPJ4.14 (VCC), UPJ6.16, UPJ7.16 (VCC), UPK1.16 (VCC), UPK2.14 (VCC), UPK3.14 (VCC), UPK4.16 (VCC), UPK5.16 (VCC), UPK6.16 (VCC), UPK7.14 (VCC), UPL1.16 (VCC), UPL2.14 (VCC), UPL3.14 (VCC), UPL4.14 (VCC), UPL5.14 (VCC), UPL6.16 (VCC), UPL7.14 (VCC), UPL8.14 (VCC)
WAR.TC: UPE1.9, UPF1.12
WRITE.PF: UPC5.17 (WE), UPC6.17 (WE), UPH8.12
~A11: PP1.a22, UPB5.2
~A12: PP1.a10, UPB5.8
~A13: PP1.a12, UPB5.6
~A14: PP1.a9, UPB5.10
~A15: PP1.a17, UPB5.4
~ABE: UPA4.9 (~W), UPA5.9 (~W), UPA6.9 (~W), UPF3.5 (Q1)
~APRE: PP1.a11, UPA1.11
~BAD.PG: JKP3.16, UPD5.8, UPJ4.1
~BUS.RD: UPK1.14 (2~S2), UPL6.14 (O1)
~BUS.READY: JKP3.7, UPC1.4 (~S)
~BUS.WAIT: JKP4.2, UPF1.9, UPH1.12, UPJ1.11
~BUS.WT: UPK3.9, UPK3.10, UPL6.13 (O2)
~BUSY.Q: JKP5.12, UPH3.10 (Q)
~BUSY: UPF1.4, UPF2.3 (I1a), UPH3.13 (~K), UPH3.14 (J)
~CL0: PP1.a18, UPC7.15 (BUS3)
~CL1: PP1.a19, UPC7.12 (BUS2)
~CL2: PP1.a20, UPC7.4 (BUS1)
~CL3: PP1.a21, UPC7.1 (BUS0)
~DBE: UPA7.9 (~BE), UPA8.9 (~BE), UPC1.8 (~Q)
~DMA.ACT: PP3.2, PP4.2, UPH4.11
~DMA.DEV0: PP3.3, PP4.3, UPH4.6
~DMA.DEV1: PP3.4, PP4.4, UPH4.3
~DMA.END: PP3.5, PP4.5, UPL2.11
~DMA.EN: PP3.6, PP4.6, UPH4.8
~{DMA.INT: UPK7.8
~DMA.INT.Q: UPK4.12 (Q4), UPK5.11 (I1b), UPL4.5
~DMA.INTR: PP3.12, PP4.12, RP7.2, RP8.1, UPL8.9
~DMA.INT: JKP7.8, UPL4.10, UPL4.12, UPL4.13
~DMA.PE: UPK2.9 (Q), UPK7.5
~{DMA.RDRDY: UPL2.3
~DMA.RDRDY: PP3.8, PP4.8
~DMA.RD: UPJ1.6, UPK2.4 (~S), UPK2.11 (C)
~DMA.REQ.Q: UPK4.5 (Q1), UPK5.4 (I2a), UPK7.1, UPK7.2, UPK7.13, UPL4.2
~DMA.REQ: PP3.13, PP4.13, RP20.2, RP25.1, UPK4.4 (D1)
~DMA.RESET: UPF8.14 (O1), UPH3.5 (~S)
~DMA.START: PP3.10, PP4.10, RP32.1, RP33.2, UPL3.13
~DMA.WTRDY: PP3.9, PP4.9, UPL2.8
~DRDY: PP1.a8, RP12.2, RP15.1, UPE6.5, UPH6.3, UPH6.6
~IACK: PP1.a29, UPE8.3
~INC.DMA: UPF1.1, UPF2.6 (I1b), UPF2.13 (I1d), UPF3.6 (Q2)
~INC.MAR: UPF2.5 (I0b), UPL6.10 (O5)
~INC.WAR: UPF2.14 (I0d), UPL6.11 (O4)
~INR0: PP1.a16, RP22.2, RP27.1, UPB6.8 (I3a)
~INR1: PP1.a13, RP24.2, RP29.1, UPB6.6 (I2a)
~INR2: PP1.a14, RP21.2, RP26.1, UPB6.4 (I1a)
~INR3: PP1.a15, RP23.2, RP28.1, UPB6.2 (I0a)
~INTR.Q: UPK4.2 (Q0), UPK5.5 (I1a), UPL4.4
~INTR: PP1.a27, RP9.2, RP11.1, UPF6.11
~LOAD.AHI: UPD3.9 (~PE), UPE3.9 (~PE), UPL6.12 (O3)
~LOAD.ALO: UPB3.9 (~PE), UPC3.9 (~PE), UPF8.9 (O6)
~LOAD.DBR: UPA7.19 (DRCP), UPA8.19 (DRCP), UPC1.10 (~S), UPF8.7 (O7)
~LOAD.MAP: JKP4.5, UPJ7.10 (S)
~LOAD.MAR: JKP4.4, UPB2.9 (~PE), UPB4.1 (S), UPC2.9 (~PE), UPC4.1 (S), UPD2.9 (~PE), UPD4.1 (S), UPE2.9 (~PE), UPE4.1 (S)
~LOAD.SWP: JKP7.11, UPL6.7 (O7)
~MAR.TC: UPE2.15 (~TC), UPK5.10 (I0b)
~MMIO15: PP1.b20, UPA6.12 (BUS2)
~MRST: JKP4.14, PP1.b32, UPH6.11
~PA11: PP1.b16, UPA5.1 (BUS0)
~PA12: PP1.b17, UPA5.4 (BUS1)
~PA13: PP1.b18, UPA5.15 (BUS3)
~PA14: PP1.b19, UPA5.12 (BUS2)
~PA15: PP1.a23, UPA6.1 (BUS0)
~PA16: PP1.a24, UPA6.4 (BUS1)
~PA17: PP1.a25, UPA6.15 (BUS3)
~PE: PP1.a28, RP14.2, RP17.1, UPB5.13
~PHI3: JKP3.11, UPJ7.11 (Cp), UPL3.8
~PROME: UPC8.16 (~E2), UPF4.7 (Q3)
~RDIN: PP1.a6, UPA1.3
~RDONLY: UPE6.4, UPJ2.13, UPJ4.12, UPK3.4
~RD: UPD1.4 (~S), UPK1.9 (2~Y)
~READ.AHI: JKP3.13, UPA4.7 (~R), UPB6.19 (OEb)
~READ.ALO: JKP3.4, UPA2.7 (~R), UPA3.7 (~R)
~READ.CLR: JKP7.1, UPC7.7 (~R)
~READ.DB: JKP1.15, UPA7.11 (~OE), UPA8.11 (~OE)
~READ.INR: JKP1.14, UPB6.1 (OEa)
~READ.PF: JKP4.16, UPA5.7 (~R), UPA6.7 (~R)
~REG: JKP5.1, UPB1.11, UPF5.8, UPJ4.2, UPJ4.13
~RESET1: JKP3.14, UPC1.1 (~R), UPC1.13 (~R), UPD1.1 (~R), UPD1.13 (~R), UPF3.15 (Clr), UPF4.15 (Clr), UPH2.1 (~R), UPK2.1 (~R)
~RLE: UPA7.1 (~RLE), UPA8.1 (~RLE), UPE1.6, UPH2.11 (C)
~STATE1.EN: UPF3.14 (E), UPF8.12 (O3)
~STATE2.EN: UPF4.14 (E), UPF8.13 (O2)
~TIMER.RESET: UPF4.10 (Q5), UPL5.1 (~R)
~WRITE.PF: UPF8.10 (O5), UPH8.13
~WRITE.RF: JKP4.11, JP1.2 (C)
~WTIN: PP1.a7, UPA1.6
~WT: UPD1.10 (~S), UPH2.4 (~S), UPL1.9 (2~Y)

Notes on the sheet:
Note this gate is bodged with pin 2 connected to D1B pin 11 and pin 1 connected to END.R/~{W} D1B pin 11 is not connected to END.R/~{W}
Note: 1k Resistor is bodged to ground from pin 12
K11 on CPU6
map register
F11 on CPU6
RDONLY is tied to GND (pin 16) PA15, 16, 17 are tied to A15
Pads for another 'LS669 ('LS169). Probably removed in testing as bus timeout was too long
WAR
Note: bodge wire from K6.15 to F6.5
These are 74LS208 sockets. The 74LS208 is in the 1977 TI databooks, but not in the 1979 databooks.
Pin 10 is bodged to B2 pins 12 and 13
Note: DMA7 is not connected on CPU5
Pin 15 is bodged to pull up 30
Pin 11 is bodged to edge connector bottom 29
Note cut trace at JKP5 and bodge pin 1 to via next to pin 14
MAR
H11 on CPU6
Pads only
M13 on CPU6
Unused Gates
K13 on CPU6
PA11, 12, 13, 14 are tied to A11, A12, A13, A14 respectively
F13 on CPU6
