sjsoftware/centurion-cpu6/kicad/CPU5/CPU5A/CPU5SA/CPU5SA.kicad_sch

## KiCad design kicad/CPU5/CPU5A/CPU5SA/CPU5SA.kicad_sch (2023-11-11)

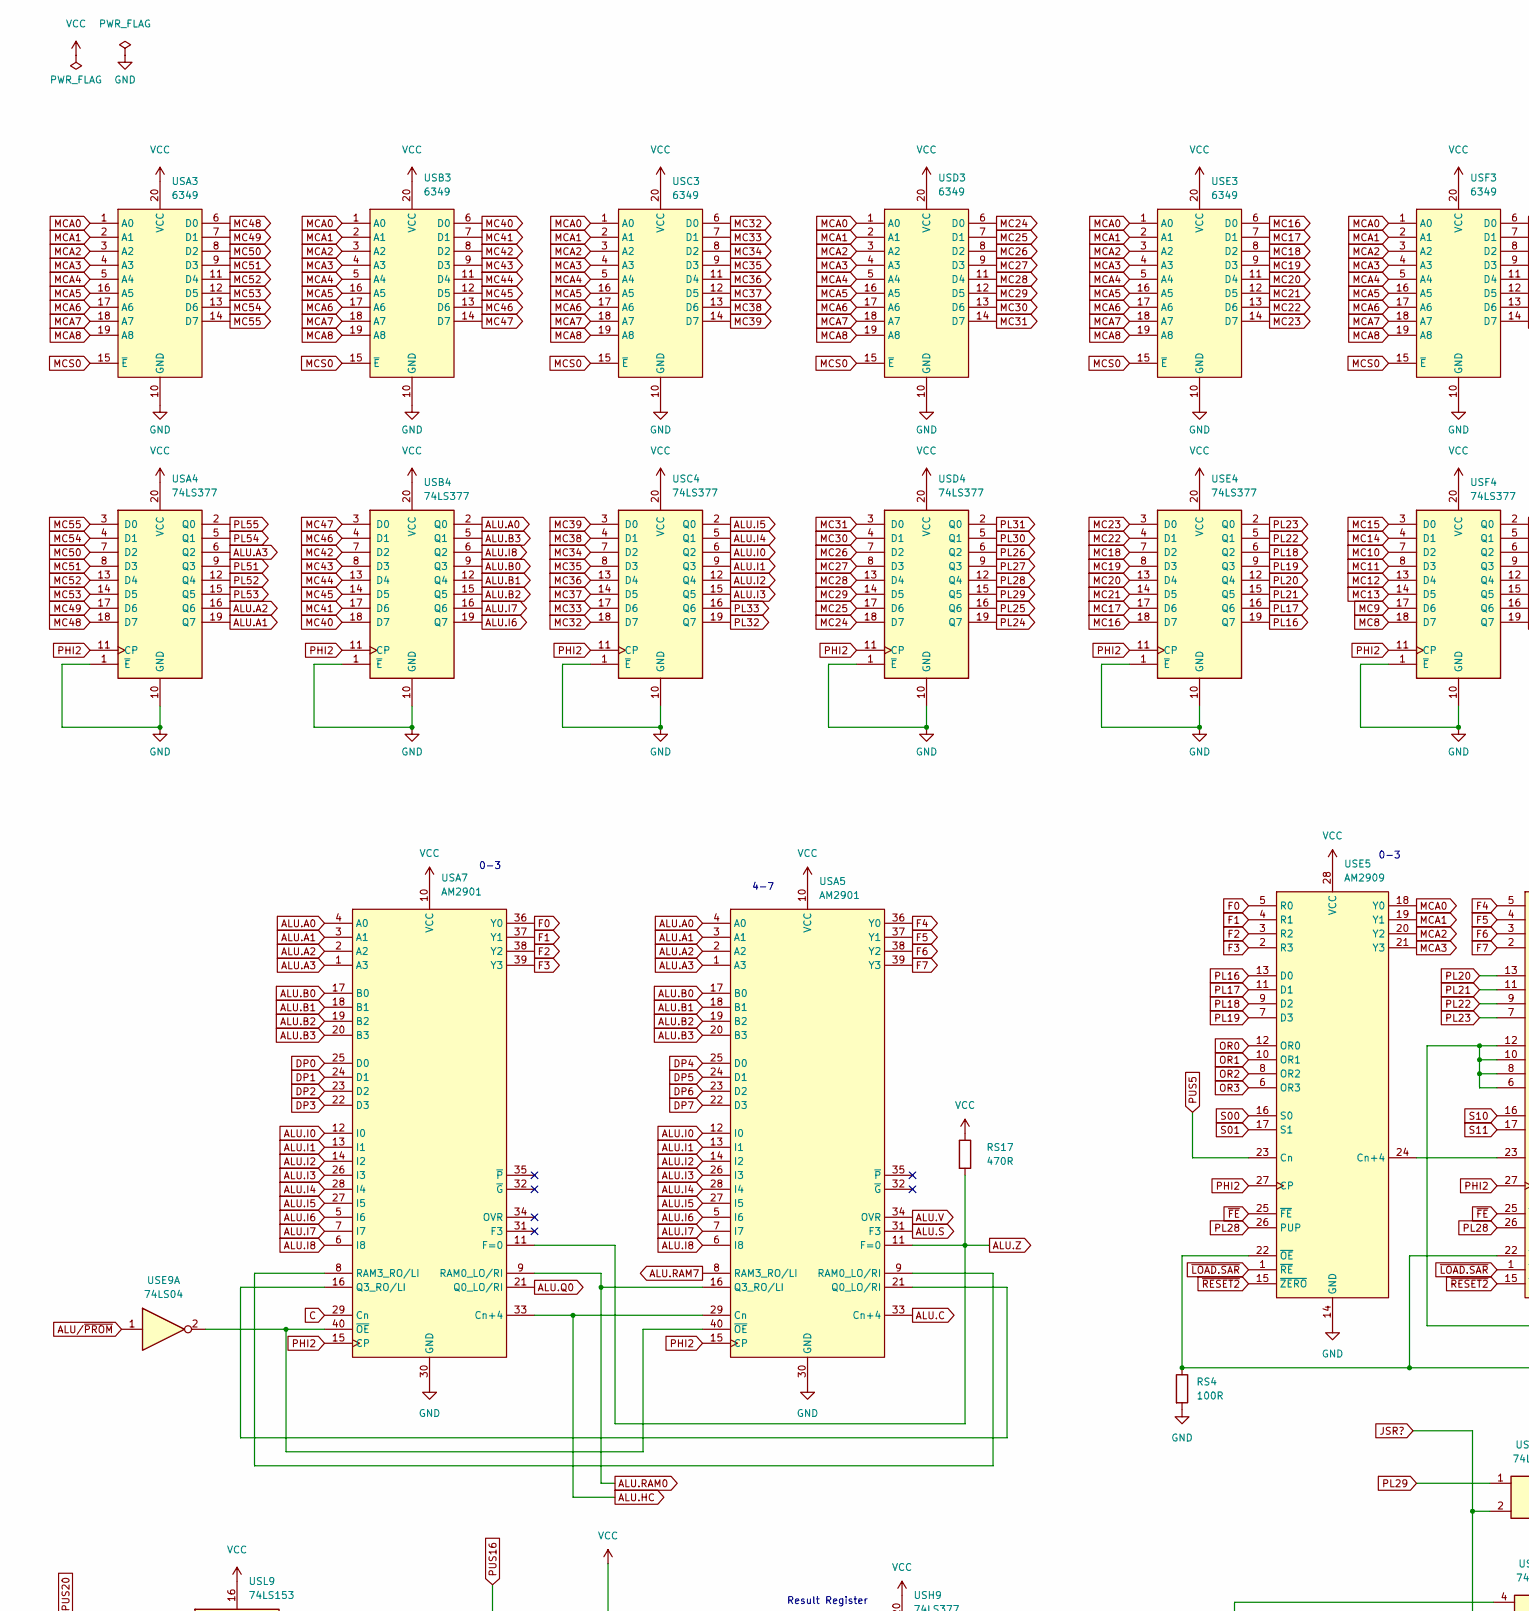
[picture p12: schematic CPU5SA.kicad_sch, part in row 1, column 1]

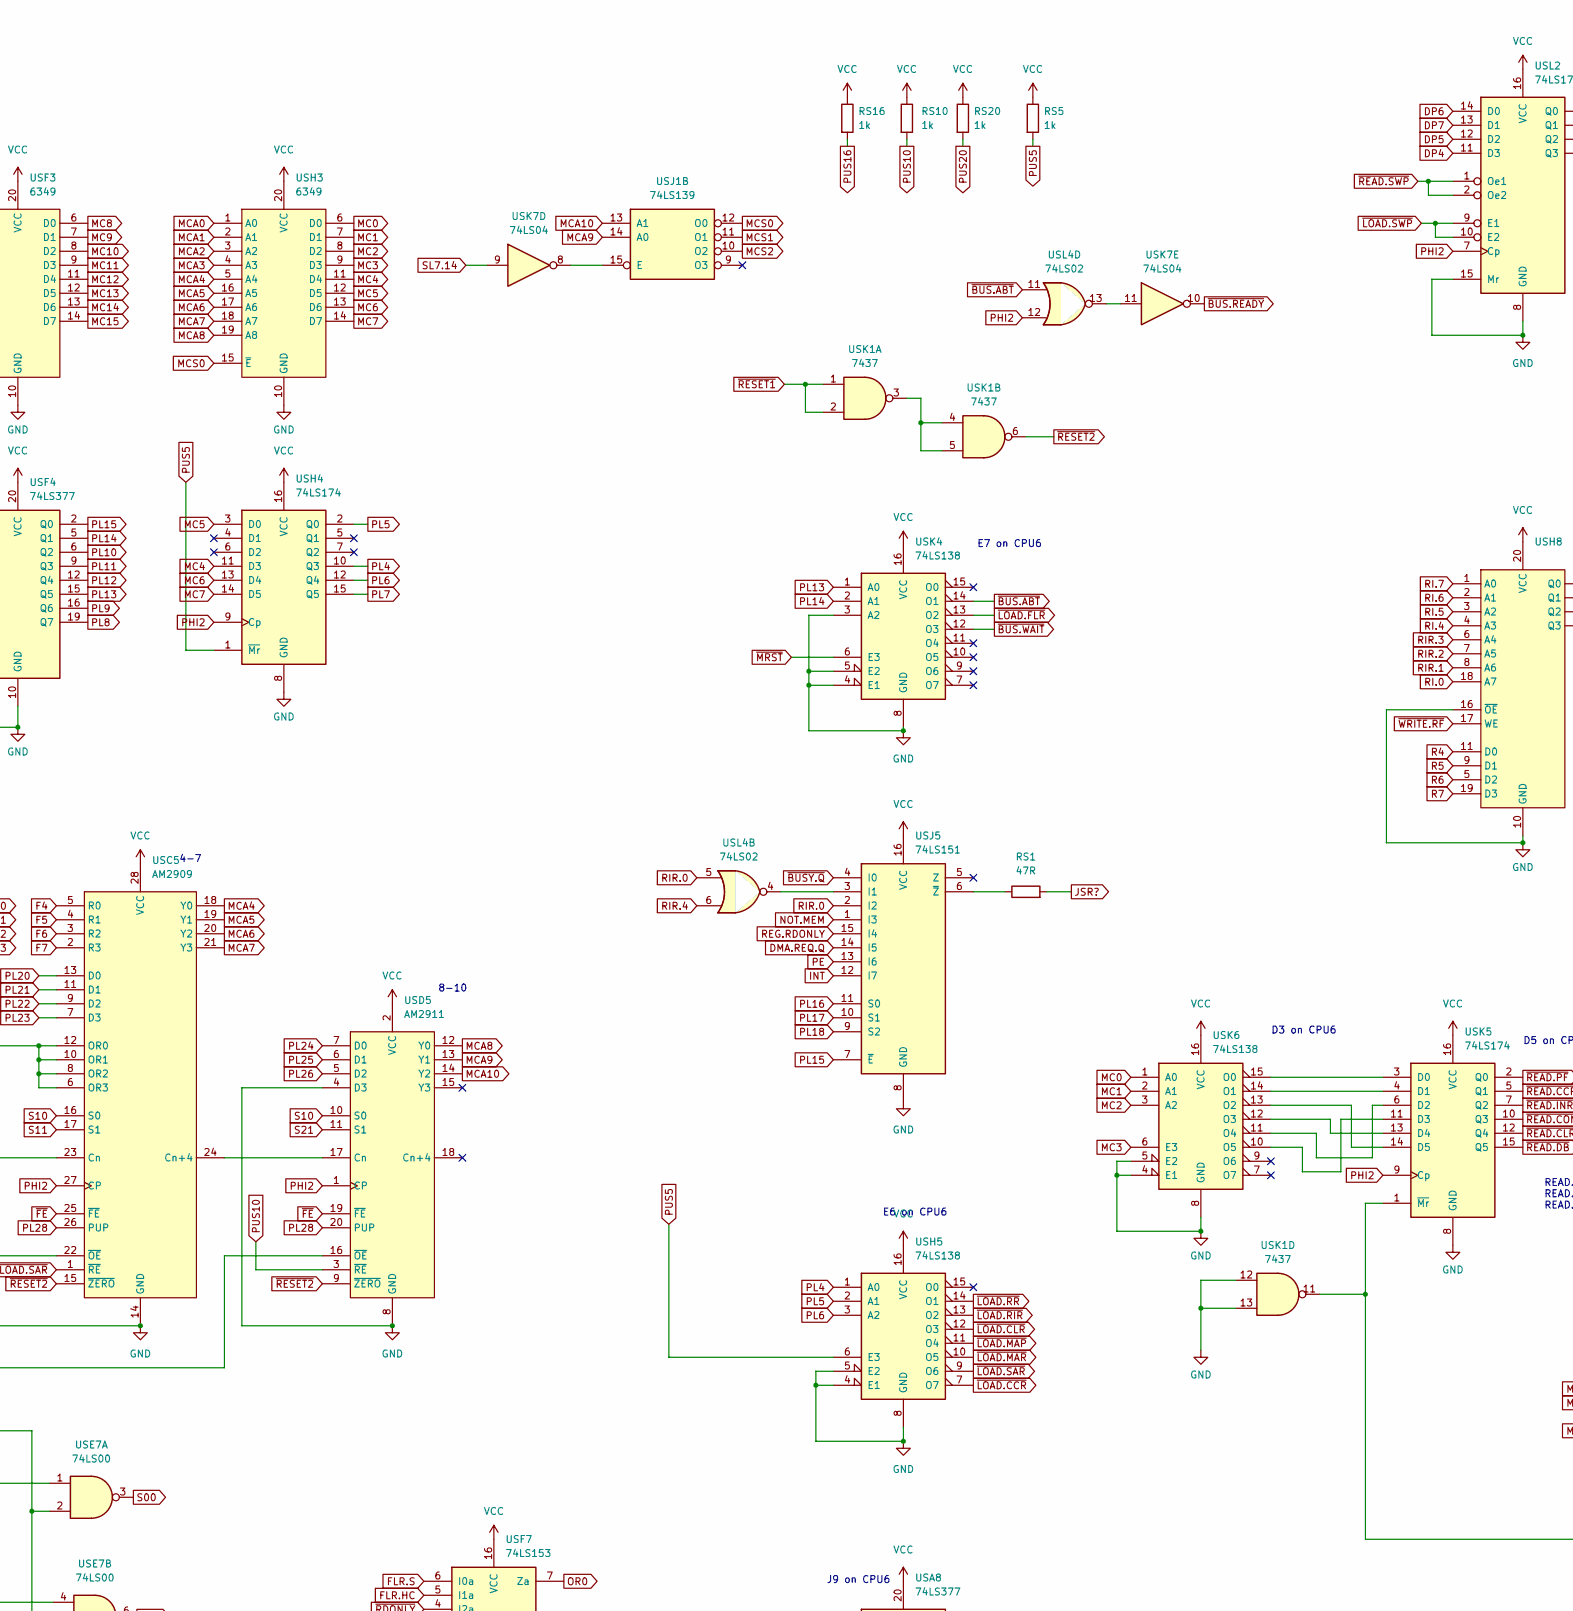
[picture p13: schematic CPU5SA.kicad_sch, part in row 1, column 2]

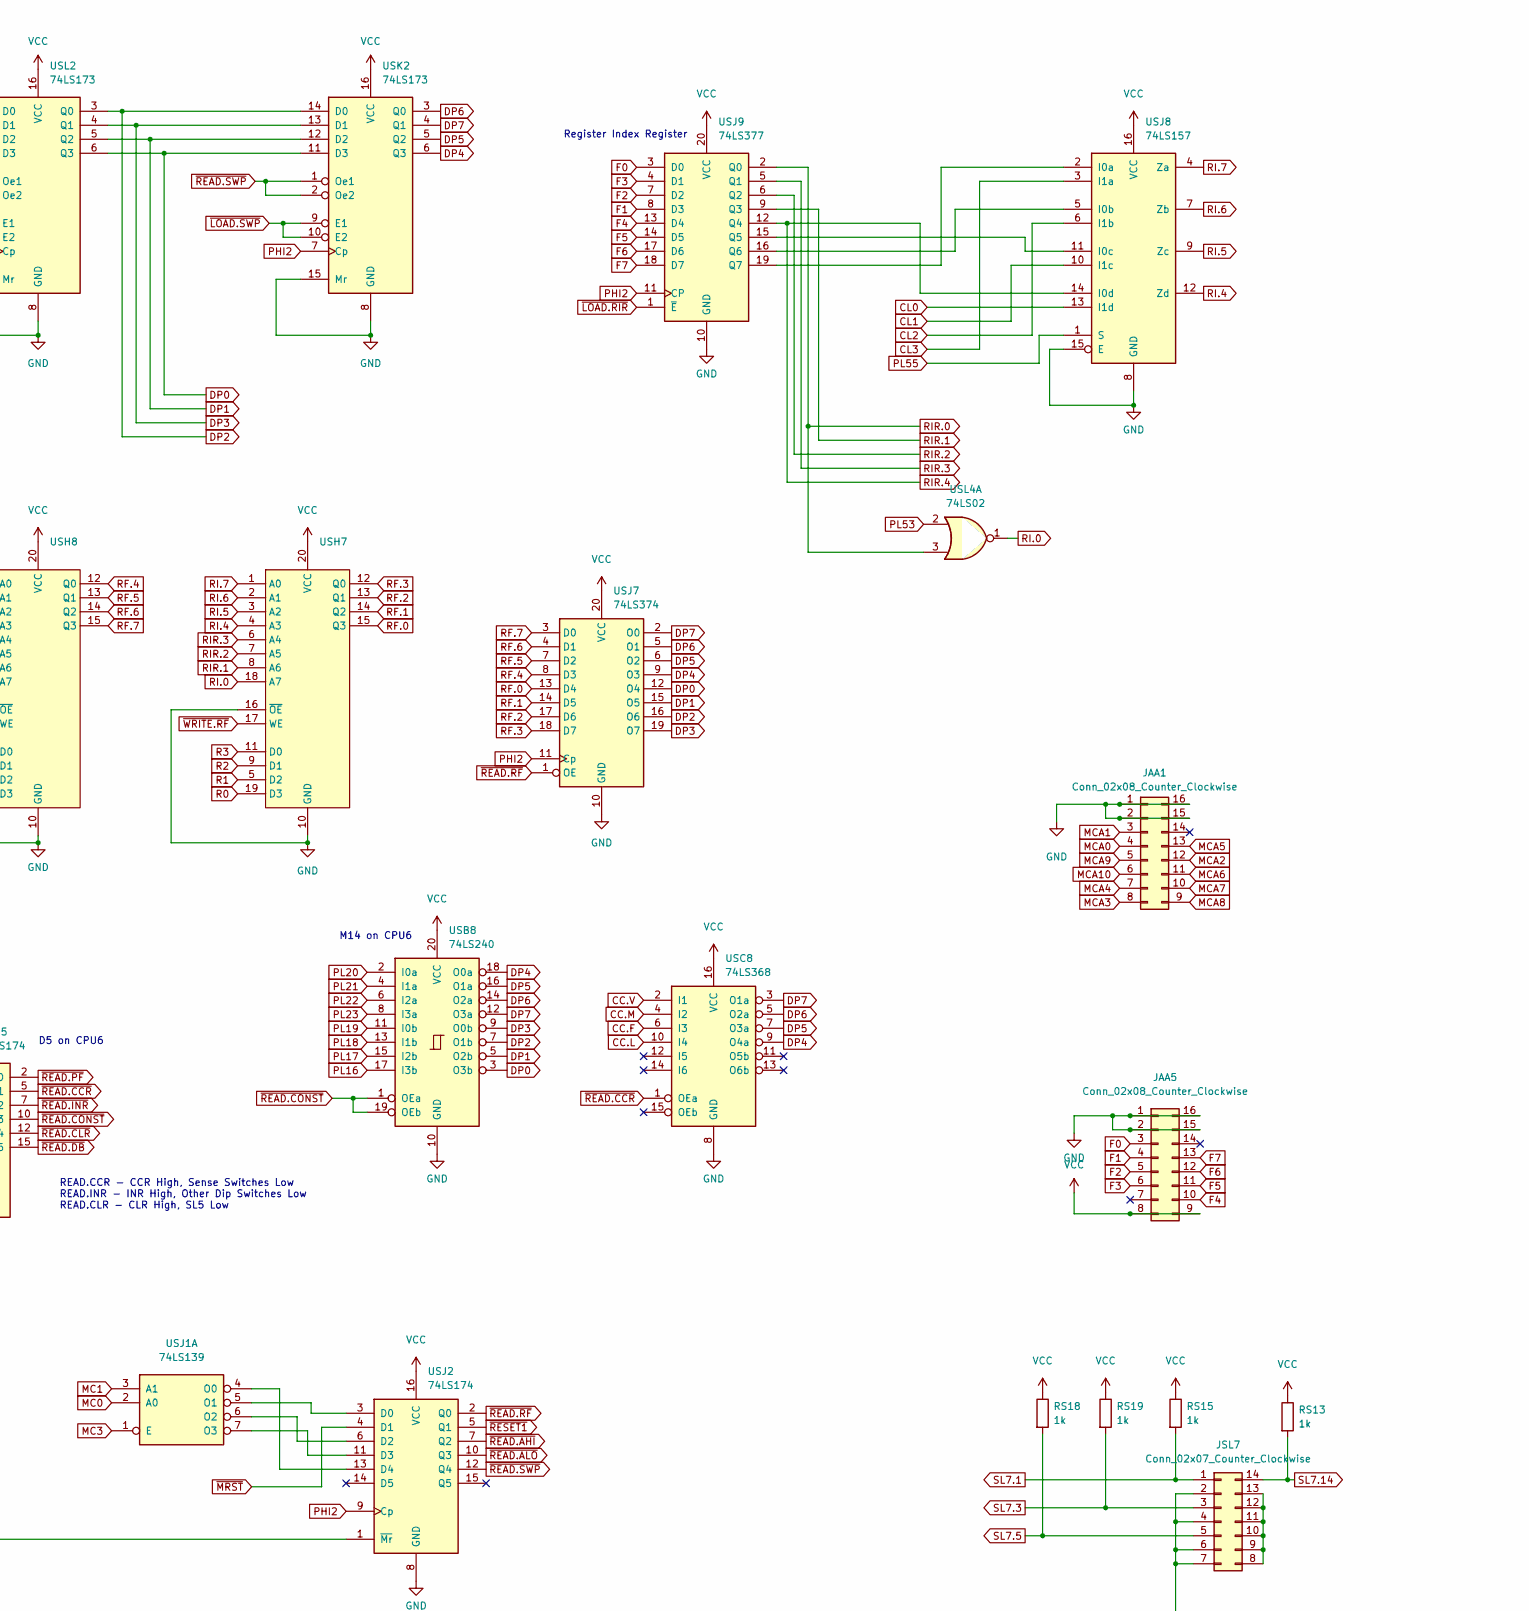
[picture p14: schematic CPU5SA.kicad_sch, part in row 1, column 3]

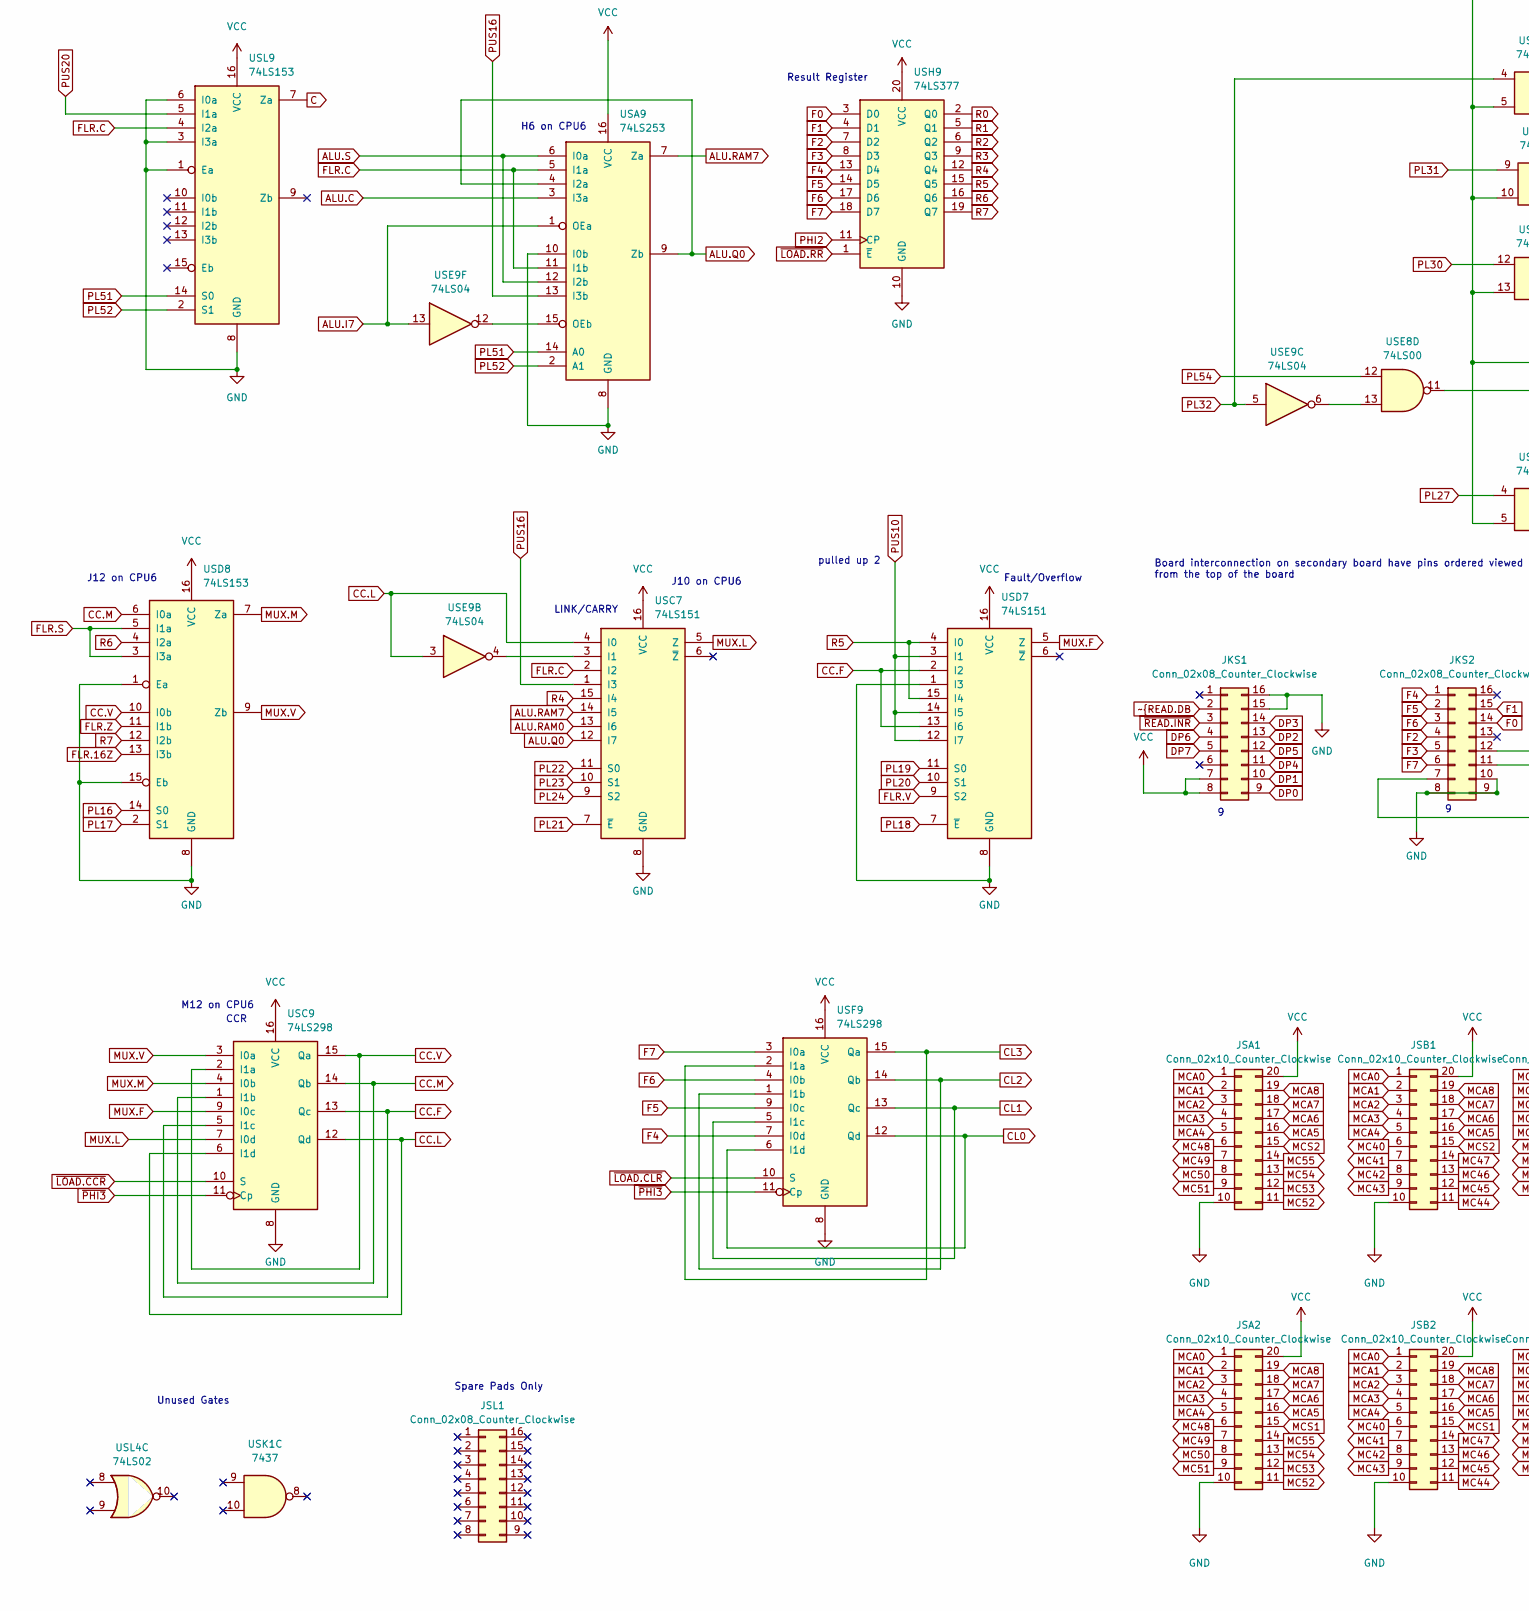
[picture p15: schematic CPU5SA.kicad_sch, part in row 2, column 1]

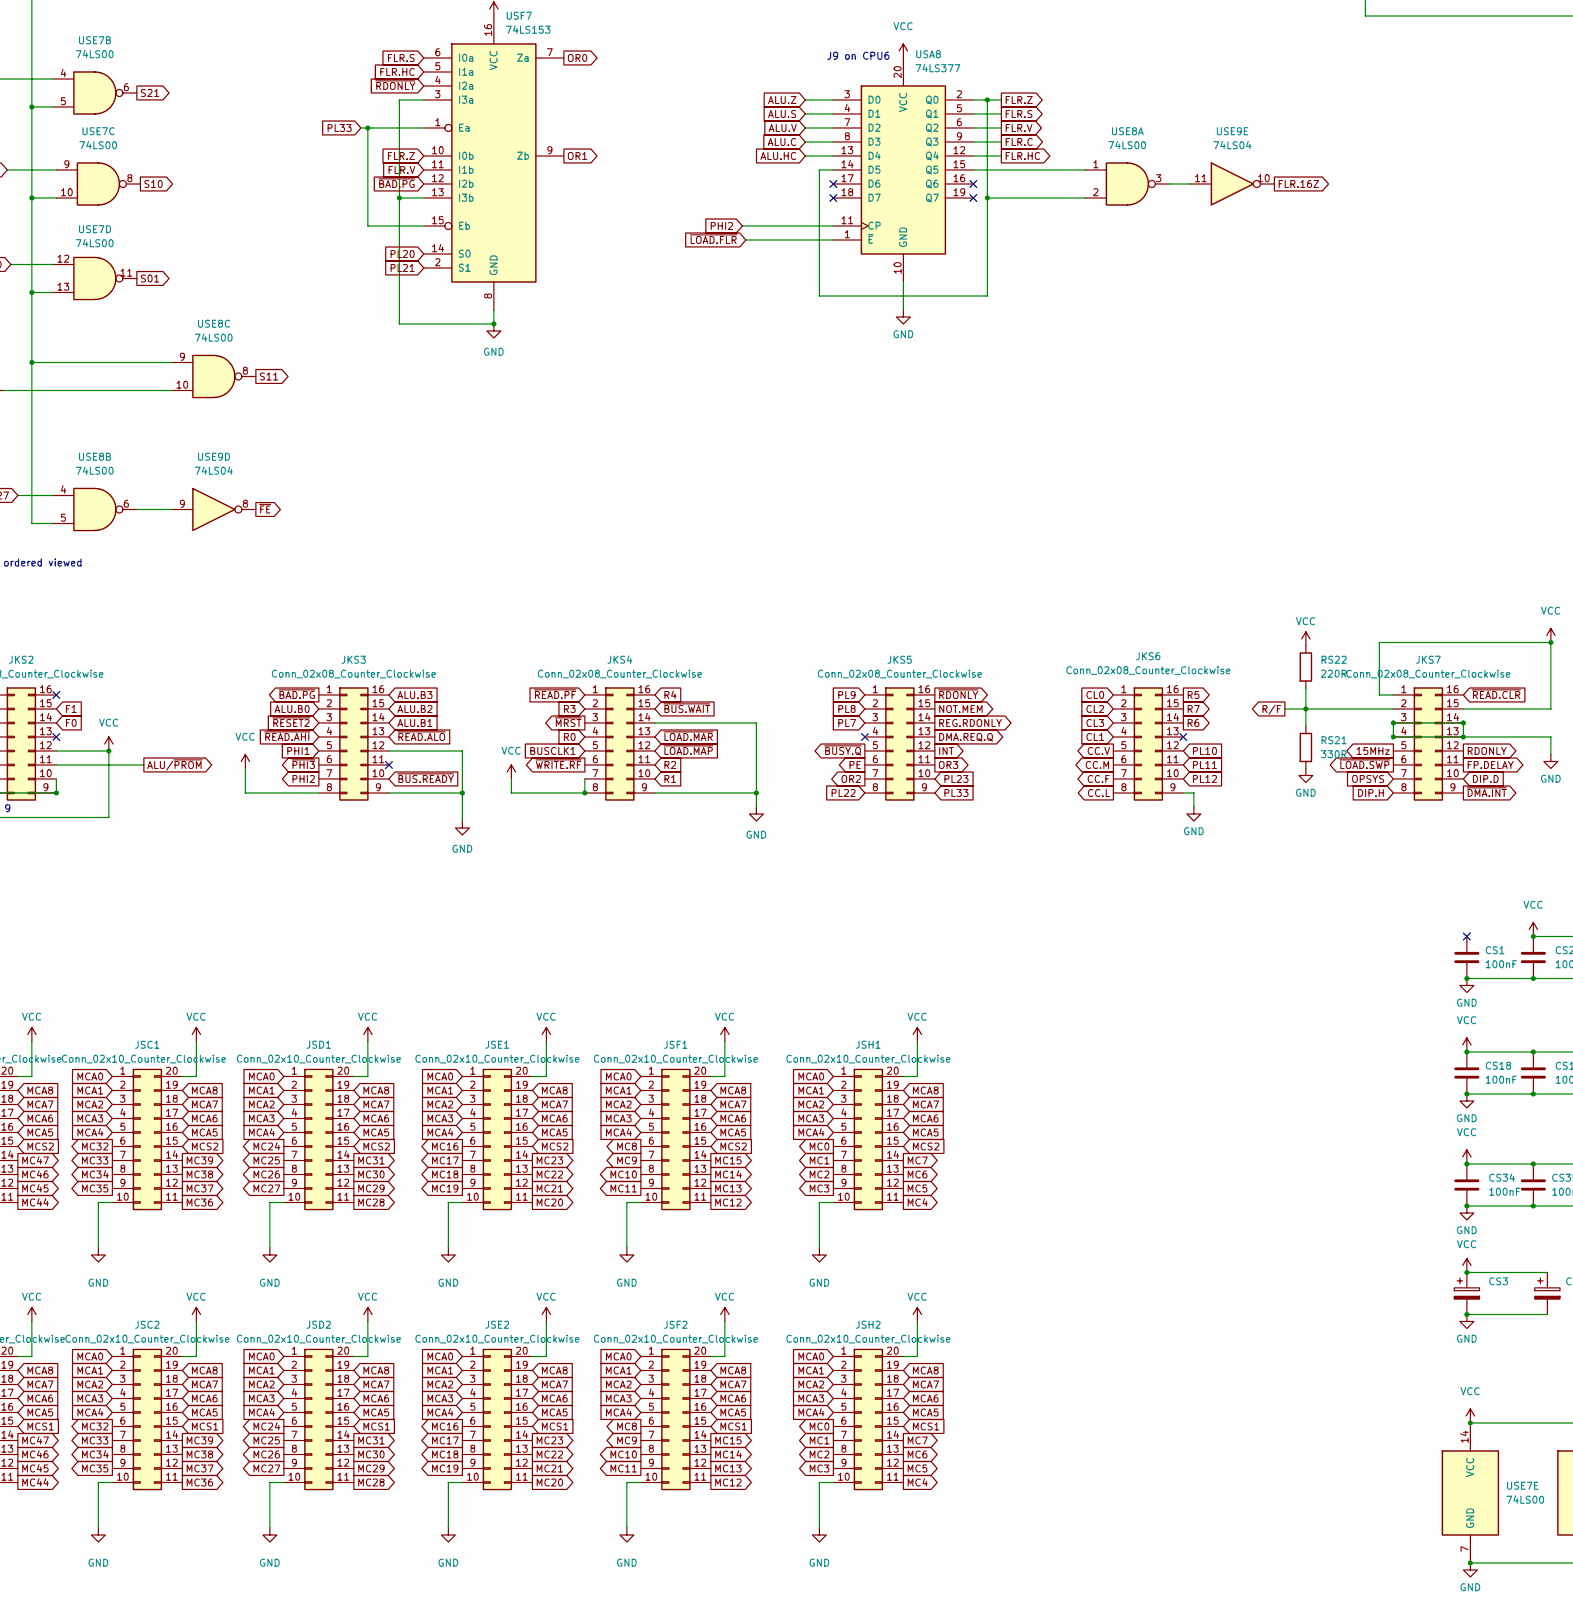
[picture p16: schematic CPU5SA.kicad_sch, part in row 2, column 2]

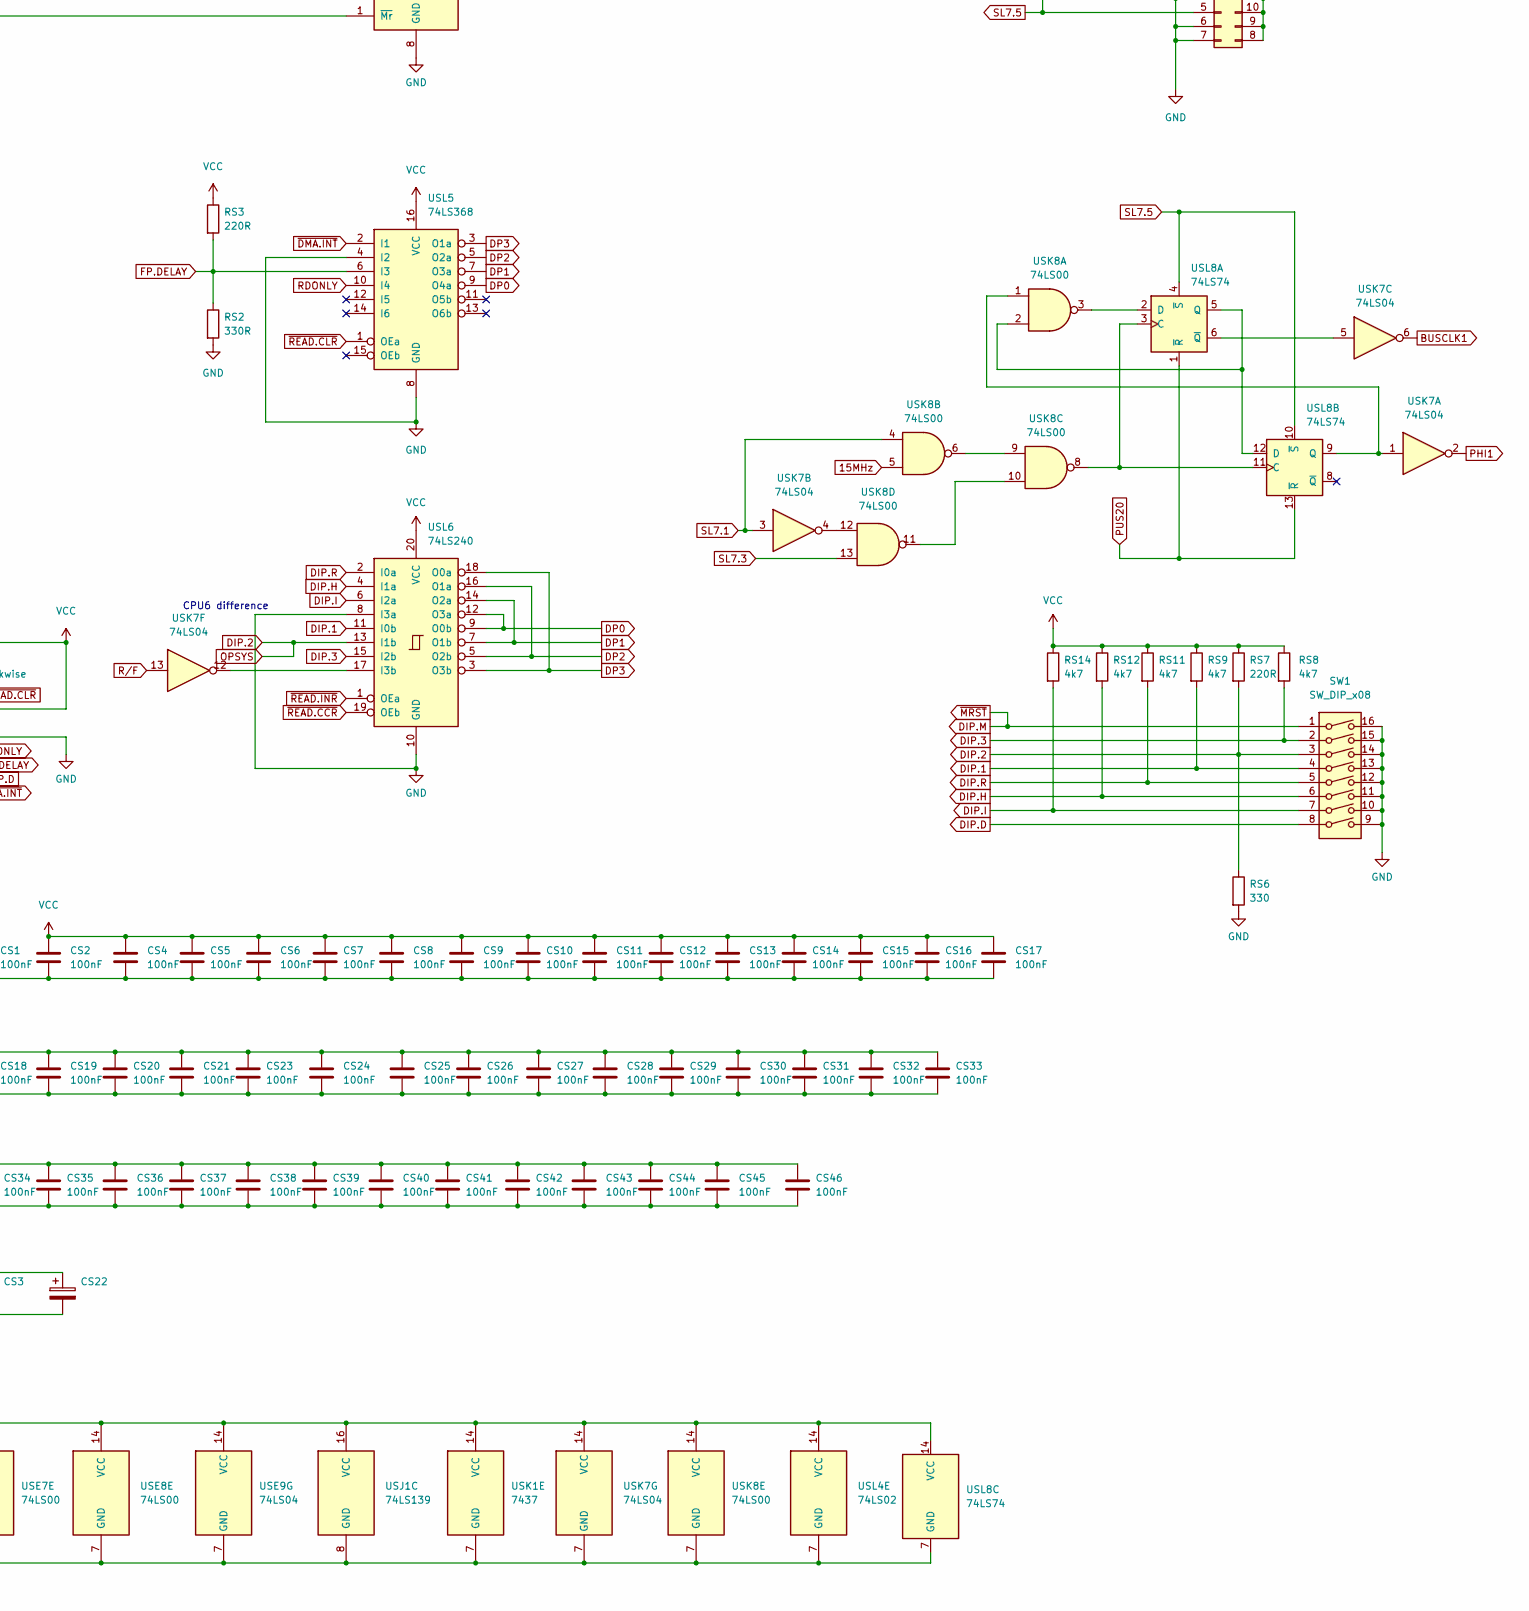
[picture p17: schematic CPU5SA.kicad_sch, part in row 2, column 3]

Parts:
CS1, CS2, CS4, CS5, CS6, CS7, CS8, CS9, CS10, CS11, CS12, CS13, CS14, CS15, CS16, CS17, CS18, CS19, CS20, CS21, CS23, CS24, CS25, CS26, CS27, CS28, CS29, CS30, CS31, CS32, CS33, CS34, CS35, CS36, CS37, CS38, CS39, CS40, CS41, CS42, CS43, CS44, CS45, CS46: 100nF; C_Disc_D3.0mm_W1.6mm_P2.54mm
CS3, CS22: CP_Axial_L25.0mm_D10.0mm_P31.75mm_Horizontal
JAA1, JAA5: Conn_02x08_Counter_Clockwise; DIP-16_W7.62mm_cent_socket
JKS1, JKS2, JKS3, JKS4, JKS5, JKS6, JKS7: Conn_02x08_Counter_Clockwise; DIP-16_W7.62mm_cent_socket_ud
JSA1: Conn_02x10_Counter_Clockwise; DIP-20_W7.62mm_cent_socket
JSA2: Conn_02x10_Counter_Clockwise; DIP-20_W7.62mm_cent_padsonly
JSB1: Conn_02x10_Counter_Clockwise; DIP-20_W7.62mm_cent_socket
JSB2: Conn_02x10_Counter_Clockwise; DIP-20_W7.62mm_cent_padsonly
JSC1: Conn_02x10_Counter_Clockwise; DIP-20_W7.62mm_cent_socket
JSC2: Conn_02x10_Counter_Clockwise; DIP-20_W7.62mm_cent_padsonly
JSD1: Conn_02x10_Counter_Clockwise; DIP-20_W7.62mm_cent_socket
JSD2: Conn_02x10_Counter_Clockwise; DIP-20_W7.62mm_cent_padsonly
JSE1: Conn_02x10_Counter_Clockwise; DIP-20_W7.62mm_cent_socket
JSE2: Conn_02x10_Counter_Clockwise; DIP-20_W7.62mm_cent_padsonly
JSF1: Conn_02x10_Counter_Clockwise; DIP-20_W7.62mm_cent_socket
JSF2: Conn_02x10_Counter_Clockwise; DIP-20_W7.62mm_cent_padsonly
JSH1: Conn_02x10_Counter_Clockwise; DIP-20_W7.62mm_cent_socket
JSH2: Conn_02x10_Counter_Clockwise; DIP-20_W7.62mm_cent_padsonly
JSL1: Conn_02x08_Counter_Clockwise; DIP-16_W7.62mm_cent_padsonly
JSL7: Conn_02x07_Counter_Clockwise; DIP-14_W7.62mm_cent_socket
RS1: 47R; R_Axial_DIN0207_L6.3mm_D2.5mm_P11.43mm_Horizontal
RS2, RS21: 330R; R_Axial_DIN0207_L6.3mm_D2.5mm_P11.43mm_Horizontal
RS3, RS7, RS22: 220R; R_Axial_DIN0207_L6.3mm_D2.5mm_P11.43mm_Horizontal
RS4: 100R; R_Axial_DIN0207_L6.3mm_D2.5mm_P11.43mm_Horizontal
RS5, RS10, RS13, RS15, RS16, RS18, RS19, RS20: 1k; R_Axial_DIN0207_L6.3mm_D2.5mm_P11.43mm_Horizontal
RS6: 330; R_Axial_DIN0207_L6.3mm_D2.5mm_P11.43mm_Horizontal
RS8, RS9, RS11, RS12, RS14: 4k7; R_Axial_DIN0207_L6.3mm_D2.5mm_P11.43mm_Horizontal
RS17: 470R; R_Axial_DIN0207_L6.3mm_D2.5mm_P11.43mm_Horizontal
SW1: SW_DIP_x08; SW_DIP_SPSTx08_Slide_9.78x22.5mm_W7.62mm_P2.54mm
USA3: 6349; DIP-20_W7.62mm_cent_socketchip
USA4, USA8: 74LS377; DIP-20_W7.62mm_cent
USA5, USA7: AM2901; DIP-40_W15.24mm_cent_socketchip
USA9: 74LS253; DIP-16_W7.62mm_cent
USB3: 6349; DIP-20_W7.62mm_cent_socketchip
USB4: 74LS377; DIP-20_W7.62mm_cent
USB8: 74LS240; DIP-20_W7.62mm_cent
USC3: 6349; DIP-20_W7.62mm_cent_socketchip
USC4: 74LS377; DIP-20_W7.62mm_cent
USC5: AM2909; DIP-28_W15.24mm_cent_socketchip
USC7: 74LS151; DIP-16_W7.62mm_cent
USC8: 74LS368; DIP-16_W7.62mm_cent
USC9: 74LS298; DIP-16_W7.62mm_cent
USD3: 6349; DIP-20_W7.62mm_cent_socketchip
USD4: 74LS377; DIP-20_W7.62mm_cent
USD5: AM2911; DIP-20_W7.62mm_cent_socketchip
USD7: 74LS151; DIP-16_W7.62mm_cent
USD8: 74LS153; DIP-16_W7.62mm_cent
USE3: 6349; DIP-20_W7.62mm_cent_socketchip
USE4: 74LS377; DIP-20_W7.62mm_cent
USE5: AM2909; DIP-28_W15.24mm_cent_socketchip
USE7, USE8: 74LS00; DIP-14_W7.62mm_cent
USE9: 74LS04; DIP-14_W7.62mm_cent
USF3: 6349; DIP-20_W7.62mm_cent_socketchip
USF4: 74LS377; DIP-20_W7.62mm_cent
USF7: 74LS153; DIP-16_W7.62mm_cent
USF9: 74LS298; DIP-16_W7.62mm_cent
USH3: 6349; DIP-20_W7.62mm_cent_socketchip
USH4: 74LS174; DIP-16_W7.62mm_cent
USH5: 74LS138; DIP-16_W7.62mm_cent
USH7, USH8: (no value)
USH9: 74LS377; DIP-20_W7.62mm_cent
USJ1: 74LS139; DIP-16_W7.62mm_cent
USJ2: 74LS174; DIP-16_W7.62mm_cent
USJ5: 74LS151; DIP-16_W7.62mm_cent
USJ7: 74LS374; DIP-20_W7.62mm_cent
USJ8: 74LS157; DIP-16_W7.62mm_cent
USJ9: 74LS377; DIP-20_W7.62mm_cent
USK1: 7437; DIP-14_W7.62mm_cent
USK2: 74LS173; DIP-16_W7.62mm_cent
USK4, USK6: 74LS138; DIP-16_W7.62mm_cent
USK5: 74LS174; DIP-16_W7.62mm_cent
USK7: 74LS04; DIP-14_W7.62mm_cent
USK8: 74LS00; DIP-14_W7.62mm_cent
USL2: 74LS173; DIP-16_W7.62mm_cent
USL4: 74LS02; DIP-14_W7.62mm_cent
USL5: 74LS368; DIP-16_W7.62mm_cent
USL6: 74LS240; DIP-20_W7.62mm_cent
USL8: 74LS74; DIP-14_W7.62mm_cent
USL9: 74LS153; DIP-16_W7.62mm_cent

Connections:
15MHz: JKS7.5, USK8.5
ALU.A0: USA5.4 (A0), USA7.4 (A0), USB4.2 (Q0)
ALU.A1: USA4.19 (Q7), USA5.3 (A1), USA7.3 (A1)
ALU.A2: USA4.16 (Q6), USA5.2 (A2), USA7.2 (A2)
ALU.A3: USA4.6 (Q2), USA5.1 (A3), USA7.1 (A3)
ALU.B0: JKS3.2, USA5.17 (B0), USA7.17 (B0), USB4.9 (Q3)
ALU.B1: JKS3.14, USA5.18 (B1), USA7.18 (B1), USB4.12 (Q4)
ALU.B2: JKS3.15, USA5.19 (B2), USA7.19 (B2), USB4.15 (Q5)
ALU.B3: JKS3.16, USA5.20 (B3), USA7.20 (B3), USB4.5 (Q1)
ALU.C: USA5.33 (Cn+4), USA8.8 (D3), USA9.3 (I3a)
ALU.HC: USA5.29 (Cn), USA7.33 (Cn+4), USA8.13 (D4)
ALU.I0: USA5.12 (I0), USA7.12 (I0), USC4.6 (Q2)
ALU.I1: USA5.13 (I1), USA7.13 (I1), USC4.9 (Q3)
ALU.I2: USA5.14 (I2), USA7.14 (I2), USC4.12 (Q4)
ALU.I3: USA5.26 (I3), USA7.26 (I3), USC4.15 (Q5)
ALU.I4: USA5.28 (I4), USA7.28 (I4), USC4.5 (Q1)
ALU.I5: USA5.27 (I5), USA7.27 (I5), USC4.2 (Q0)
ALU.I6: USA5.5 (I6), USA7.5 (I6), USB4.19 (Q7)
ALU.I7: USA5.7 (I7), USA7.7 (I7), USA9.1 (OEa), USB4.16 (Q6), USE9.13
ALU.I8: USA5.6 (I8), USA7.6 (I8), USB4.6 (Q2)
ALU.Q0: USA7.21 (Q0_LO/RI), USA9.4 (I2a), USA9.9 (Zb), USC7.12 (I7)
ALU.RAM0: USA5.16 (Q3_RO/LI), USA7.9 (RAM0_LO/RI), USC7.13 (I6)
ALU.RAM7: USA5.8 (RAM3_RO/LI), USA9.7 (Za), USC7.14 (I5)
ALU.S: USA5.31 (F3), USA8.4 (D1), USA9.6 (I0a), USA9.12 (I2b)
ALU.V: USA5.34 (OVR), USA8.7 (D2)
ALU.Z: RS17.2, USA5.11 (F=0), USA7.11 (F=0), USA8.3 (D0)
ALU/~PROM: JKS2.11, USE9.1
BUSCLK1: JKS4.5, USK7.6
C: USA7.29 (Cn), USL9.7 (Za)
CC.F: JKS6.7, USC8.6 (I3), USC9.5 (I1c), USC9.13 (Qc), USD7.2 (I2), USD7.13 (I6)
CC.L: JKS6.8, USC7.4 (I0), USC8.10 (I4), USC9.6 (I1d), USC9.12 (Qd), USE9.3
CC.M: JKS6.6, USC8.4 (I2), USC9.1 (I1b), USC9.14 (Qb), USD8.6 (I0a)
CC.V: JKS6.5, USC8.2 (I1), USC9.2 (I1a), USC9.15 (Qa), USD8.10 (I0b)
CL0: JKS6.1, USF9.6 (I1d), USF9.12 (Qd), USJ8.13 (I1d)
CL1: JKS6.4, USF9.5 (I1c), USF9.13 (Qc), USJ8.10 (I1c)
CL2: JKS6.2, USF9.1 (I1b), USF9.14 (Qb), USJ8.6 (I1b)
CL3: JKS6.3, USF9.2 (I1a), USF9.15 (Qa), USJ8.3 (I1a)
DIP.1: RS9.2, SW1.4, USL6.11 (I0b)
DIP.2: JKS7.7, RS6.1, RS7.2, SW1.3, USL6.13 (I1b)
DIP.3: RS8.2, SW1.2, USL6.15 (I2b)
DIP.D: JKS7.10, SW1.8
DIP.H: JKS7.8, RS12.2, SW1.6, USL6.4 (I1a)
DIP.I: RS14.2, SW1.7, USL6.6 (I2a)
DIP.M: JKS4.3, SW1.1, USJ2.4 (D1), USK4.6 (E3)
DIP.R: RS11.2, SW1.5, USL6.2 (I0a)
DMA.REQ.Q: JKS5.13, USJ5.14 (I5)
DP0: JKS1.9, USA7.25 (D0), USB8.3 (O3b), USJ7.12 (O4), USK2.11 (D3), USL2.6 (Q3), USL5.9 (O4a), USL6.9 (O0b), USL6.12 (O3a)
DP1: JKS1.10, USA7.24 (D1), USB8.5 (O2b), USJ7.15 (O5), USK2.12 (D2), USL2.5 (Q2), USL5.7 (O3a), USL6.7 (O1b), USL6.14 (O2a)
DP2: JKS1.13, USA7.23 (D2), USB8.7 (O1b), USJ7.16 (O6), USK2.14 (D0), USL2.3 (Q0), USL5.5 (O2a), USL6.5 (O2b), USL6.16 (O1a)
DP3: JKS1.14, USA7.22 (D3), USB8.9 (O0b), USJ7.19 (O7), USK2.13 (D1), USL2.4 (Q1), USL5.3 (O1a), USL6.3 (O3b), USL6.18 (O0a)
DP4: JKS1.11, USA5.25 (D0), USB8.18 (O0a), USC8.9 (O4a), USJ7.9 (O3), USK2.6 (Q3), USL2.11 (D3)
DP5: JKS1.12, USA5.24 (D1), USB8.16 (O1a), USC8.7 (O3a), USJ7.6 (O2), USK2.5 (Q2), USL2.12 (D2)
DP6: JKS1.4, USA5.23 (D2), USB8.14 (O2a), USC8.5 (O2a), USJ7.5 (O1), USK2.3 (Q0), USL2.14 (D0)
DP7: JKS1.5, USA5.22 (D3), USB8.12 (O3a), USC8.3 (O1a), USJ7.2 (O0), USK2.4 (Q1), USL2.13 (D1)
F0: JAA5.3, JKS2.14, USA7.36 (Y0), USE5.5 (R0), USH9.3 (D0), USJ9.3 (D0)
F1: JAA5.4, JKS2.15, USA7.37 (Y1), USE5.4 (R1), USH9.4 (D1), USJ9.8 (D3)
F2: JAA5.5, JKS2.4, USA7.38 (Y2), USE5.3 (R2), USH9.7 (D2), USJ9.7 (D2)
F3: JAA5.6, JKS2.5, USA7.39 (Y3), USE5.2 (R3), USH9.8 (D3), USJ9.4 (D1)
F4: JAA5.10, JKS2.1, USA5.36 (Y0), USC5.5 (R0), USF9.7 (I0d), USH9.13 (D4), USJ9.13 (D4)
F5: JAA5.11, JKS2.2, USA5.37 (Y1), USC5.4 (R1), USF9.9 (I0c), USH9.14 (D5), USJ9.14 (D5)
F6: JAA5.12, JKS2.3, USA5.38 (Y2), USC5.3 (R2), USF9.4 (I0b), USH9.17 (D6), USJ9.17 (D6)
F7: JAA5.13, JKS2.6, USA5.39 (Y3), USC5.2 (R3), USF9.3 (I0a), USH9.18 (D7), USJ9.18 (D7)
FLR.16Z: USD8.13 (I3b), USE9.10
FLR.C: USA8.9 (Q3), USA9.5 (I1a), USA9.11 (I1b), USC7.2 (I2), USL9.4 (I2a)
FLR.HC: USA8.12 (Q4), USF7.5 (I1a)
FLR.S: USA8.5 (Q1), USD8.3 (I3a), USD8.5 (I1a), USF7.6 (I0a)
FLR.V: USA8.6 (Q2), USD7.9 (S2), USF7.11 (I1b)
FLR.Z: USA8.2 (Q0), USA8.14 (D5), USD8.11 (I1b), USE8.2, USF7.10 (I0b)
FP.DELAY: JKS7.11, RS2.1, RS3.2, USL5.6 (I3)
GND: CS1.2, CS2.2, CS3.2, CS4.2, CS5.2, CS6.2, CS7.2, CS8.2, CS9.2, CS10.2, CS11.2, CS12.2, CS13.2, CS14.2, CS15.2, CS16.2, CS17.2, CS18.2, CS19.2, CS20.2, CS21.2, CS22.2, CS23.2, CS24.2, CS25.2, CS26.2, CS27.2, CS28.2, CS29.2, CS30.2, CS31.2, CS32.2, CS33.2, CS34.2, CS35.2, CS36.2, CS37.2, CS38.2, CS39.2, CS40.2, CS41.2, CS42.2, CS43.2, CS44.2, CS45.2, CS46.2, JAA1.1, JAA1.2, JAA1.15, JAA1.16, JAA5.1, JAA5.2, JAA5.15, JAA5.16, JKS1.15, JKS1.16, JKS2.8, JKS2.9, JKS2.10, JKS3.9, JKS3.12, JKS4.9, JKS4.14, JKS6.9, JKS7.3, JKS7.4, JKS7.13, JKS7.14, JSA1.10, JSA2.10, JSB1.10, JSB2.10, JSC1.10, JSC2.10, JSD1.10, JSD2.10, JSE1.10, JSE2.10, JSF1.10, JSF2.10, JSH1.10, JSH2.10, JSL7.2, JSL7.4, JSL7.6, JSL7.7, RS2.2, RS4.2, RS6.2, RS21.2, SW1.9, SW1.10, SW1.11, SW1.12, SW1.13, SW1.14, SW1.15, SW1.16, USA3.10 (GND), USA4.1 (~E), USA4.10 (GND), USA5.30 (GND), USA7.30 (GND), USA8.10 (GND), USA9.8 (GND), USA9.10 (I0b), USB3.10 (GND), USB4.1 (~E), USB4.10 (GND), USB8.10 (GND), USC3.10 (GND), USC4.1 (~E), USC4.10 (GND), USC5.6 (OR3), USC5.8 (OR2), USC5.10 (OR1), USC5.12 (OR0), USC5.14 (GND), USC7.8 (GND), USC8.8 (GND), USC9.8 (GND), USD3.10 (GND), USD4.1 (~E), USD4.10 (GND), USD5.4 (D3), USD5.8 (GND), USD7.1 (I3), USD7.8 (GND), USD8.1 (Ea), USD8.8 (GND), USD8.15 (Eb), USE3.10 (GND), USE4.1 (~E), USE4.10 (GND), USE5.14 (GND), USE7.7 (GND), USE8.7 (GND), USE9.7 (GND), USF3.10 (GND), USF4.1 (~E), USF4.10 (GND), USF7.3 (I3a), USF7.8 (GND), USF7.13 (I3b), USF9.8 (GND), USH3.10 (GND), USH4.8 (GND), USH5.4 (E1), USH5.5 (E2), USH5.8 (GND), USH7.10 (GND), USH7.16 (~OE), USH8.10 (GND), USH8.16 (~OE), USH9.10 (GND), USJ1.8 (GND), USJ2.8 (GND), USJ5.8 (GND), USJ7.10 (GND), USJ8.8 (GND), USJ8.15 (E), USJ9.10 (GND), USK1.7 (GND), USK1.12, USK1.13, USK2.8 (GND), USK2.15 (Mr), USK4.3 (A2), USK4.4 (E1), USK4.5 (E2), USK4.8 (GND), USK5.8 (GND), USK6.4 (E1), USK6.5 (E2), USK6.8 (GND), USK7.7 (GND), USK8.7 (GND), USL2.8 (GND), USL2.15 (Mr), USL4.7 (GND), USL5.4 (I2), USL5.8 (GND), USL6.8 (I3a), USL6.10 (GND), USL8.7 (GND), USL9.1 (Ea), USL9.3 (I3a), USL9.6 (I0a), USL9.8 (GND)
INT: JKS5.12, USJ5.12 (I7)
JSR?: RS1.2, USE7.2, USE7.5, USE7.10, USE7.13, USE8.5, USE8.9
MC0: JSH1.6, JSH2.6, USH3.6 (D0), USJ1.2 (A0), USK6.1 (A0)
MC1: JSH1.7, JSH2.7, USH3.7 (D1), USJ1.3 (A1), USK6.2 (A1)
MC2: JSH1.8, JSH2.8, USH3.8 (D2), USK6.3 (A2)
MC3: JSH1.9, JSH2.9, USH3.9 (D3), USJ1.1 (E), USK6.6 (E3)
MC4: JSH1.11, JSH2.11, USH3.11 (D4), USH4.11 (D3)
MC5: JSH1.12, JSH2.12, USH3.12 (D5), USH4.3 (D0)
MC6: JSH1.13, JSH2.13, USH3.13 (D6), USH4.13 (D4)
MC7: JSH1.14, JSH2.14, USH3.14 (D7), USH4.14 (D5)
MC8: JSF1.6, JSF2.6, USF3.6 (D0), USF4.18 (D7)
MC9: JSF1.7, JSF2.7, USF3.7 (D1), USF4.17 (D6)
MC10: JSF1.8, JSF2.8, USF3.8 (D2), USF4.7 (D2)
MC11: JSF1.9, JSF2.9, USF3.9 (D3), USF4.8 (D3)
MC12: JSF1.11, JSF2.11, USF3.11 (D4), USF4.13 (D4)
MC13: JSF1.12, JSF2.12, USF3.12 (D5), USF4.14 (D5)
MC14: JSF1.13, JSF2.13, USF3.13 (D6), USF4.4 (D1)
MC15: JSF1.14, JSF2.14, USF3.14 (D7), USF4.3 (D0)
MC16: JSE1.6, JSE2.6, USE3.6 (D0), USE4.18 (D7)
MC17: JSE1.7, JSE2.7, USE3.7 (D1), USE4.17 (D6)
MC18: JSE1.8, JSE2.8, USE3.8 (D2), USE4.7 (D2)
MC19: JSE1.9, JSE2.9, USE3.9 (D3), USE4.8 (D3)
MC20: JSE1.11, JSE2.11, USE3.11 (D4), USE4.13 (D4)
MC21: JSE1.12, JSE2.12, USE3.12 (D5), USE4.14 (D5)
MC22: JSE1.13, JSE2.13, USE3.13 (D6), USE4.4 (D1)
MC23: JSE1.14, JSE2.14, USE3.14 (D7), USE4.3 (D0)
MC24: JSD1.6, JSD2.6, USD3.6 (D0), USD4.18 (D7)
MC25: JSD1.7, JSD2.7, USD3.7 (D1), USD4.17 (D6)
MC26: JSD1.8, JSD2.8, USD3.8 (D2), USD4.7 (D2)
MC27: JSD1.9, JSD2.9, USD3.9 (D3), USD4.8 (D3)
MC28: JSD1.11, JSD2.11, USD3.11 (D4), USD4.13 (D4)
MC29: JSD1.12, JSD2.12, USD3.12 (D5), USD4.14 (D5)
MC30: JSD1.13, JSD2.13, USD3.13 (D6), USD4.4 (D1)
MC31: JSD1.14, JSD2.14, USD3.14 (D7), USD4.3 (D0)
MC32: JSC1.6, JSC2.6, USC3.6 (D0), USC4.18 (D7)
MC33: JSC1.7, JSC2.7, USC3.7 (D1), USC4.17 (D6)
MC34: JSC1.8, JSC2.8, USC3.8 (D2), USC4.7 (D2)
MC35: JSC1.9, JSC2.9, USC3.9 (D3), USC4.8 (D3)
MC36: JSC1.11, JSC2.11, USC3.11 (D4), USC4.13 (D4)
MC37: JSC1.12, JSC2.12, USC3.12 (D5), USC4.14 (D5)
MC38: JSC1.13, JSC2.13, USC3.13 (D6), USC4.4 (D1)
MC39: JSC1.14, JSC2.14, USC3.14 (D7), USC4.3 (D0)
MC40: JSB1.6, JSB2.6, USB3.6 (D0), USB4.18 (D7)
MC41: JSB1.7, JSB2.7, USB3.7 (D1), USB4.17 (D6)
MC42: JSB1.8, JSB2.8, USB3.8 (D2), USB4.7 (D2)
MC43: JSB1.9, JSB2.9, USB3.9 (D3), USB4.8 (D3)
MC44: JSB1.11, JSB2.11, USB3.11 (D4), USB4.13 (D4)
MC45: JSB1.12, JSB2.12, USB3.12 (D5), USB4.14 (D5)
MC46: JSB1.13, JSB2.13, USB3.13 (D6), USB4.4 (D1)
MC47: JSB1.14, JSB2.14, USB3.14 (D7), USB4.3 (D0)
MC48: JSA1.6, JSA2.6, USA3.6 (D0), USA4.18 (D7)
MC49: JSA1.7, JSA2.7, USA3.7 (D1), USA4.17 (D6)
MC50: JSA1.8, JSA2.8, USA3.8 (D2), USA4.7 (D2)
MC51: JSA1.9, JSA2.9, USA3.9 (D3), USA4.8 (D3)
MC52: JSA1.11, JSA2.11, USA3.11 (D4), USA4.13 (D4)
MC53: JSA1.12, JSA2.12, USA3.12 (D5), USA4.14 (D5)
MC54: JSA1.13, JSA2.13, USA3.13 (D6), USA4.4 (D1)
MC55: JSA1.14, JSA2.14, USA3.14 (D7), USA4.3 (D0)
MCA0: JAA1.4, JSA1.1, JSA2.1, JSB1.1, JSB2.1, JSC1.1, JSC2.1, JSD1.1, JSD2.1, JSE1.1, JSE2.1, JSF1.1, JSF2.1, JSH1.1, JSH2.1, USA3.1 (A0), USB3.1 (A0), USC3.1 (A0), USD3.1 (A0), USE3.1 (A0), USE5.18 (Y0), USF3.1 (A0), USH3.1 (A0)
MCA1: JAA1.3, JSA1.2, JSA2.2, JSB1.2, JSB2.2, JSC1.2, JSC2.2, JSD1.2, JSD2.2, JSE1.2, JSE2.2, JSF1.2, JSF2.2, JSH1.2, JSH2.2, USA3.2 (A1), USB3.2 (A1), USC3.2 (A1), USD3.2 (A1), USE3.2 (A1), USE5.19 (Y1), USF3.2 (A1), USH3.2 (A1)
MCA2: JAA1.12, JSA1.3, JSA2.3, JSB1.3, JSB2.3, JSC1.3, JSC2.3, JSD1.3, JSD2.3, JSE1.3, JSE2.3, JSF1.3, JSF2.3, JSH1.3, JSH2.3, USA3.3 (A2), USB3.3 (A2), USC3.3 (A2), USD3.3 (A2), USE3.3 (A2), USE5.20 (Y2), USF3.3 (A2), USH3.3 (A2)
MCA3: JAA1.8, JSA1.4, JSA2.4, JSB1.4, JSB2.4, JSC1.4, JSC2.4, JSD1.4, JSD2.4, JSE1.4, JSE2.4, JSF1.4, JSF2.4, JSH1.4, JSH2.4, USA3.4 (A3), USB3.4 (A3), USC3.4 (A3), USD3.4 (A3), USE3.4 (A3), USE5.21 (Y3), USF3.4 (A3), USH3.4 (A3)
MCA4: JAA1.7, JSA1.5, JSA2.5, JSB1.5, JSB2.5, JSC1.5, JSC2.5, JSD1.5, JSD2.5, JSE1.5, JSE2.5, JSF1.5, JSF2.5, JSH1.5, JSH2.5, USA3.5 (A4), USB3.5 (A4), USC3.5 (A4), USC5.18 (Y0), USD3.5 (A4), USE3.5 (A4), USF3.5 (A4), USH3.5 (A4)
MCA5: JAA1.13, JSA1.16, JSA2.16, JSB1.16, JSB2.16, JSC1.16, JSC2.16, JSD1.16, JSD2.16, JSE1.16, JSE2.16, JSF1.16, JSF2.16, JSH1.16, JSH2.16, USA3.16 (A5), USB3.16 (A5), USC3.16 (A5), USC5.19 (Y1), USD3.16 (A5), USE3.16 (A5), USF3.16 (A5), USH3.16 (A5)
MCA6: JAA1.11, JSA1.17, JSA2.17, JSB1.17, JSB2.17, JSC1.17, JSC2.17, JSD1.17, JSD2.17, JSE1.17, JSE2.17, JSF1.17, JSF2.17, JSH1.17, JSH2.17, USA3.17 (A6), USB3.17 (A6), USC3.17 (A6), USC5.20 (Y2), USD3.17 (A6), USE3.17 (A6), USF3.17 (A6), USH3.17 (A6)
MCA7: JAA1.10, JSA1.18, JSA2.18, JSB1.18, JSB2.18, JSC1.18, JSC2.18, JSD1.18, JSD2.18, JSE1.18, JSE2.18, JSF1.18, JSF2.18, JSH1.18, JSH2.18, USA3.18 (A7), USB3.18 (A7), USC3.18 (A7), USC5.21 (Y3), USD3.18 (A7), USE3.18 (A7), USF3.18 (A7), USH3.18 (A7)
MCA8: JAA1.9, JSA1.19, JSA2.19, JSB1.19, JSB2.19, JSC1.19, JSC2.19, JSD1.19, JSD2.19, JSE1.19, JSE2.19, JSF1.19, JSF2.19, JSH1.19, JSH2.19, USA3.19 (A8), USB3.19 (A8), USC3.19 (A8), USD3.19 (A8), USD5.12 (Y0), USE3.19 (A8), USF3.19 (A8), USH3.19 (A8)
MCA9: JAA1.5, USD5.13 (Y1), USJ1.14 (A0)
MCA10: JAA1.6, USD5.14 (Y2), USJ1.13 (A1)
MCS0: USA3.15 (~E), USB3.15 (~E), USC3.15 (~E), USD3.15 (~E), USE3.15 (~E), USF3.15 (~E), USH3.15 (~E), USJ1.12 (O0)
MCS1: JSA2.15, JSB2.15, JSC2.15, JSD2.15, JSE2.15, JSF2.15, JSH2.15, USJ1.11 (O1)
MCS2: JSA1.15, JSB1.15, JSC1.15, JSD1.15, JSE1.15, JSF1.15, JSH1.15, USJ1.10 (O2)
MUX.F: USC9.9 (I0c), USD7.5 (Z)
MUX.L: USC7.5 (Z), USC9.7 (I0d)
MUX.M: USC9.4 (I0b), USD8.7 (Za)
MUX.V: USC9.3 (I0a), USD8.9 (Zb)
NOT.MEM: JKS5.15, USJ5.1 (I3)
unnamed: JSL7.8, JSL7.9, JSL7.10, JSL7.11, JSL7.12, JSL7.13
unnamed: RS1.1, USJ5.6 (~Z)
unnamed: RS4.1, USC5.22 (~OE), USD5.16 (~OE), USE5.22 (~OE)
unnamed: USA5.9 (RAM0_LO/RI), USA7.8 (RAM3_RO/LI)
unnamed: USA5.21 (Q0_LO/RI), USA7.16 (Q3_RO/LI)
unnamed: USA5.40 (~OE), USA7.40 (~OE), USE9.2
unnamed: USA8.15 (Q5), USE8.1
unnamed: USA9.15 (OEb), USE9.12
unnamed: USC5.23 (Cn), USE5.24 (Cn+4)
unnamed: USC5.24 (Cn+4), USD5.17 (Cn)
unnamed: USC7.3 (I1), USE9.4
unnamed: USE8.3, USE9.11
unnamed: USE8.6, USE9.9
unnamed: USE8.10, USE8.11
unnamed: USE8.13, USE9.6
unnamed: USJ1.4 (O0), USJ2.13 (D4)
unnamed: USJ1.5 (O1), USJ2.3 (D0)
unnamed: USJ1.6 (O2), USJ2.6 (D2)
unnamed: USJ1.7 (O3), USJ2.11 (D3)
unnamed: USJ1.15 (E), USK7.8
unnamed: USJ2.1 (~Mr), USK1.11, USK5.1 (~Mr)
unnamed: USJ5.3 (I1), USL4.4
unnamed: USJ8.2 (I0a), USJ9.19 (Q7)
unnamed: USJ8.5 (I0b), USJ9.16 (Q6)
unnamed: USJ8.11 (I0c), USJ9.15 (Q5)
unnamed: USK1.3, USK1.4, USK1.5
unnamed: USK5.3 (D0), USK6.15 (O0)
unnamed: USK5.4 (D1), USK6.14 (O1)
unnamed: USK5.6 (D2), USK6.11 (O4)
unnamed: USK5.11 (D3), USK6.10 (O5)
unnamed: USK5.13 (D4), USK6.12 (O3)
unnamed: USK5.14 (D5), USK6.13 (O2)
unnamed: USK7.1, USK8.1, USL8.9 (Q)
unnamed: USK7.4, USK8.12
unnamed: USK7.5, USL8.6 (~Q)
unnamed: USK7.11, USL4.13
unnamed: USK7.12, USL6.17 (I3b)
unnamed: USK8.2, USL8.5 (Q), USL8.12 (D)
unnamed: USK8.3, USL8.2 (D)
unnamed: USK8.6, USK8.9
unnamed: USK8.8, USL8.3 (C), USL8.11 (C)
unnamed: USK8.10, USK8.11
OR0: USE5.12 (OR0), USF7.7 (Za)
OR1: USE5.10 (OR1), USF7.9 (Zb)
OR2: JKS5.7, USE5.8 (OR2)
OR3: JKS5.11, USE5.6 (OR3)
PE: JKS5.6, USJ5.13 (I6)
PHI1: JKS3.5, USK7.2
PHI2: JKS3.7, USA4.11 (CP), USA5.15 (CP), USA7.15 (CP), USA8.11 (CP), USB4.11 (CP), USC4.11 (CP), USC5.27 (CP), USD4.11 (CP), USD5.1 (CP), USE4.11 (CP), USE5.27 (CP), USF4.11 (CP), USH4.9 (Cp), USH9.11 (CP), USJ2.9 (Cp), USJ7.11 (Cp), USJ9.11 (CP), USK2.7 (Cp), USK5.9 (Cp), USL2.7 (Cp), USL4.12
PL4: USH4.10 (Q3), USH5.1 (A0)
PL5: USH4.2 (Q0), USH5.2 (A1)
PL6: USH4.12 (Q4), USH5.3 (A2)
PL7: JKS5.3, USH4.15 (Q5)
PL8: JKS5.2, USF4.19 (Q7)
PL9: JKS5.1, USF4.16 (Q6)
PL10: JKS6.12, USF4.6 (Q2)
PL11: JKS6.11, USF4.9 (Q3)
PL12: JKS6.10, USF4.12 (Q4)
PL13: USF4.15 (Q5), USK4.1 (A0)
PL14: USF4.5 (Q1), USK4.2 (A1)
PL15: USF4.2 (Q0), USJ5.7 (~E)
PL16: USB8.17 (I3b), USD8.14 (S0), USE4.19 (Q7), USE5.13 (D0), USJ5.11 (S0)
PL17: USB8.15 (I2b), USD8.2 (S1), USE4.16 (Q6), USE5.11 (D1), USJ5.10 (S1)
PL18: USB8.13 (I1b), USD7.7 (~E), USE4.6 (Q2), USE5.9 (D2), USJ5.9 (S2)
PL19: USB8.11 (I0b), USD7.11 (S0), USE4.9 (Q3), USE5.7 (D3)
PL20: USB8.2 (I0a), USC5.13 (D0), USD7.10 (S1), USE4.12 (Q4), USF7.14 (S0)
PL21: USB8.4 (I1a), USC5.11 (D1), USC7.7 (~E), USE4.15 (Q5), USF7.2 (S1)
PL22: JKS5.8, USB8.6 (I2a), USC5.9 (D2), USC7.11 (S0), USE4.5 (Q1)
PL23: JKS5.10, USB8.8 (I3a), USC5.7 (D3), USC7.10 (S1), USE4.2 (Q0)
PL24: USC7.9 (S2), USD4.19 (Q7), USD5.7 (D0)
PL25: USD4.16 (Q6), USD5.6 (D1)
PL26: USD4.6 (Q2), USD5.5 (D2)
PL27: USD4.9 (Q3), USE8.4
PL28: USC5.26 (PUP), USD4.12 (Q4), USD5.20 (PUP), USE5.26 (PUP)
PL29: USD4.15 (Q5), USE7.1
PL30: USD4.5 (Q1), USE7.12
PL31: USD4.2 (Q0), USE7.9
PL32: USC4.19 (Q7), USE7.4, USE9.5
PL33: JKS5.9, USC4.16 (Q6), USF7.1 (Ea), USF7.15 (Eb)
PL51: USA4.9 (Q3), USA9.14 (A0), USL9.14 (S0)
PL52: USA4.12 (Q4), USA9.2 (A1), USL9.2 (S1)
PL53: USA4.15 (Q5), USL4.2
PL54: USA4.5 (Q1), USE8.12
PL55: USA4.2 (Q0), USJ8.1 (S)
PUS5: RS5.2, USE5.23 (Cn), USH4.1 (~Mr), USH5.6 (E3)
PUS10: RS10.2, USD5.3 (~RE), USD7.3 (I1), USD7.12 (I7), USD7.14 (I5)
PUS16: RS16.2, USA9.13 (I3b), USC7.1 (I3)
PUS20: RS20.2, USL8.1 (~R), USL8.13 (~R), USL9.5 (I1a)
R0: JKS4.4, USH7.19 (D3), USH9.2 (Q0)
R1: JKS4.10, USH7.5 (D2), USH9.5 (Q1)
R2: JKS4.11, USH7.9 (D1), USH9.6 (Q2)
R3: JKS4.2, USH7.11 (D0), USH9.9 (Q3)
R4: JKS4.16, USC7.15 (I4), USH8.11 (D0), USH9.12 (Q4)
R5: JKS6.16, USD7.4 (I0), USD7.15 (I4), USH8.9 (D1), USH9.15 (Q5)
R6: JKS6.14, USD8.4 (I2a), USH8.5 (D2), USH9.16 (Q6)
R7: JKS6.15, USD8.12 (I2b), USH8.19 (D3), USH9.19 (Q7)
RDONLY: JKS7.12, USL5.10 (I4)
REG.RDONLY: JKS5.14, USJ5.15 (I4)
RF.0: USH7.15 (Q3), USJ7.13 (D4)
RF.1: USH7.14 (Q2), USJ7.14 (D5)
RF.2: USH7.13 (Q1), USJ7.17 (D6)
RF.3: USH7.12 (Q0), USJ7.18 (D7)
RF.4: USH8.12 (Q0), USJ7.8 (D3)
RF.5: USH8.13 (Q1), USJ7.7 (D2)
RF.6: USH8.14 (Q2), USJ7.4 (D1)
RF.7: USH8.15 (Q3), USJ7.3 (D0)
RI.0: USH7.18 (A7), USH8.18 (A7), USL4.1
RI.4: USH7.4 (A3), USH8.4 (A3), USJ8.12 (Zd)
RI.5: USH7.3 (A2), USH8.3 (A2), USJ8.9 (Zc)
RI.6: USH7.2 (A1), USH8.2 (A1), USJ8.7 (Zb)
RI.7: USH7.1 (A0), USH8.1 (A0), USJ8.4 (Za)
RIR.0: USJ5.2 (I2), USJ9.2 (Q0), USL4.3, USL4.5
RIR.1: USH7.8 (A6), USH8.8 (A6), USJ9.9 (Q3)
RIR.2: USH7.7 (A5), USH8.7 (A5), USJ9.6 (Q2)
RIR.3: USH7.6 (A4), USH8.6 (A4), USJ9.5 (Q1)
RIR.4: USJ8.14 (I0d), USJ9.12 (Q4), USL4.6
R/F: JKS7.2, RS21.1, RS22.2, USK7.13
S00: USE5.16 (S0), USE7.3
S01: USE5.17 (S1), USE7.11
S10: USC5.16 (S0), USD5.10 (S0), USE7.8
S11: USC5.17 (S1), USE8.8
S21: USD5.11 (S1), USE7.6
SL7.1: JSL7.1, RS15.2, USK7.3, USK8.4
SL7.3: JSL7.3, RS19.2, USK8.13
SL7.5: JSL7.5, RS18.2, USL8.4 (~S), USL8.10 (~S)
SL7.14: JSL7.14, RS13.2, USK7.9
VCC: CS2.1, CS3.1, CS4.1, CS5.1, CS6.1, CS7.1, CS8.1, CS9.1, CS10.1, CS11.1, CS12.1, CS13.1, CS14.1, CS15.1, CS16.1, CS17.1, CS18.1, CS19.1, CS20.1, CS21.1, CS22.1, CS23.1, CS24.1, CS25.1, CS26.1, CS27.1, CS28.1, CS29.1, CS30.1, CS31.1, CS32.1, CS33.1, CS34.1, CS35.1, CS36.1, CS37.1, CS38.1, CS39.1, CS40.1, CS41.1, CS42.1, CS43.1, CS44.1, CS45.1, CS46.1, JAA5.8, JAA5.9, JKS1.7, JKS1.8, JKS2.7, JKS2.12, JKS3.8, JKS4.7, JKS4.8, JKS7.1, JKS7.15, JSA1.20, JSA2.20, JSB1.20, JSB2.20, JSC1.20, JSC2.20, JSD1.20, JSD2.20, JSE1.20, JSE2.20, JSF1.20, JSF2.20, JSH1.20, JSH2.20, RS3.1, RS5.1, RS7.1, RS8.1, RS9.1, RS10.1, RS11.1, RS12.1, RS13.1, RS14.1, RS15.1, RS16.1, RS17.1, RS18.1, RS19.1, RS20.1, RS22.1, USA3.20 (VCC), USA4.20 (VCC), USA5.10 (VCC), USA7.10 (VCC), USA8.20 (VCC), USA9.16 (VCC), USB3.20 (VCC), USB4.20 (VCC), USB8.20 (VCC), USC3.20 (VCC), USC4.20 (VCC), USC5.28 (VCC), USC7.16 (VCC), USC8.16 (VCC), USC9.16 (VCC), USD3.20 (VCC), USD4.20 (VCC), USD5.2 (VCC), USD7.16 (VCC), USD8.16 (VCC), USE3.20 (VCC), USE4.20 (VCC), USE5.28 (VCC), USE7.14 (VCC), USE8.14 (VCC), USE9.14 (VCC), USF3.20 (VCC), USF4.20 (VCC), USF7.16 (VCC), USF9.16 (VCC), USH3.20 (VCC), USH4.16 (VCC), USH5.16 (VCC), USH7.20 (VCC), USH8.20 (VCC), USH9.20 (VCC), USJ1.16 (VCC), USJ2.16 (VCC), USJ5.16 (VCC), USJ7.20 (VCC), USJ8.16 (VCC), USJ9.20 (VCC), USK1.14 (VCC), USK2.16 (VCC), USK4.16 (VCC), USK5.16 (VCC), USK6.16 (VCC), USK7.14 (VCC), USK8.14 (VCC), USL2.16 (VCC), USL4.14 (VCC), USL5.16 (VCC), USL6.20 (VCC), USL8.14 (VCC), USL9.16 (VCC)
~BAD.PG: JKS3.1, USF7.12 (I2b)
~BUS.ABT: USK4.14 (O1), USL4.11
~BUS.READY: JKS3.10, USK7.10
~BUS.WAIT: JKS4.15, USK4.12 (O3)
~BUSY.Q: JKS5.5, USJ5.4 (I0)
~DMA.INT: JKS7.9, USL5.2 (I1)
~FE: USC5.25 (~FE), USD5.19 (~FE), USE5.25 (~FE), USE9.8
~LOAD.CCR: USC9.10 (S), USH5.7 (O7)
~LOAD.CLR: USF9.10 (S), USH5.12 (O3)
~LOAD.FLR: USA8.1 (~E), USK4.13 (O2)
~LOAD.MAP: JKS4.12, USH5.11 (O4)
~LOAD.MAR: JKS4.13, USH5.10 (O5)
~LOAD.RIR: USH5.13 (O2), USJ9.1 (~E)
~LOAD.RR: USH5.14 (O1), USH9.1 (~E)
~LOAD.SAR: USC5.1 (~RE), USE5.1 (~RE), USH5.9 (O6)
~LOAD.SWP: JKS7.6, USK2.9 (E1), USK2.10 (E2), USL2.9 (E1), USL2.10 (E2)
~PHI3: JKS3.6, USC9.11 (Cp), USF9.11 (Cp)
~RDONLY: JKS5.16, USF7.4 (I2a)
~READ.AHI: JKS3.4, USJ2.7 (Q2)
~READ.ALO: JKS3.13, USJ2.10 (Q3)
~READ.CCR: USC8.1 (OEa), USK5.5 (Q1), USL6.19 (OEb)
~READ.CLR: JKS7.16, USK5.12 (Q4), USL5.1 (OEa)
~READ.CONST: USB8.1 (OEa), USB8.19 (OEb), USK5.10 (Q3)
~{READ.DB: JKS1.2
~READ.DB: USK5.15 (Q5)
~READ.INR: JKS1.3, USK5.7 (Q2), USL6.1 (OEa)
~READ.PF: JKS4.1, USK5.2 (Q0)
~READ.RF: USJ2.2 (Q0), USJ7.1 (OE)
~READ.SWP: USJ2.12 (Q4), USK2.1 (Oe1), USK2.2 (Oe2), USL2.1 (Oe1), USL2.2 (Oe2)
~RESET1: USJ2.5 (Q1), USK1.1, USK1.2
~RESET2: JKS3.3, USC5.15 (~ZERO), USD5.9 (~ZERO), USE5.15 (~ZERO), USK1.6
~WRITE.RF: JKS4.6, USH7.17 (WE), USH8.17 (WE)

Notes on the sheet:
E7 on CPU6
Fault/Overflow
CCR
4-7
0-3
D5 on CPU6
Board interconnection on secondary board have pins ordered viewed from the top of the board
D3 on CPU6
H6 on CPU6
Register Index Register
J9 on CPU6
M14 on CPU6
M12 on CPU6
E6 on CPU6
J10 on CPU6
Spare Pads Only
CPU6 difference
pulled up 2
LINK/CARRY
READ.CCR - CCR High, Sense Switches Low READ.INR - INR High, Other Dip Switches Low READ.CLR - CLR High, SL5 Low
8-10
Result Register
Unused Gates
J12 on CPU6
