sjsoftware/centurion-cpu6/(commit log)

2022-04-28 Updated schematic - edge connector ordering now consistent with other schematics
2022-04-30 Add kicad
    [CPU6.kicad_sch]
2022-04-30 Add kicad project
2022-05-11 All chips on schematic
    [CPU6.kicad_sch]
2022-06-13 Add more traces, relabeled microcode pipeline register
    [CPU6.kicad_sch]
2022-06-20 Schematic corrections
    [CPU6.kicad_sch]
2022-06-25 Pins from today's beeping
    [CPU6.kicad_sch]
2022-06-26 Errors corrected
    [CPU6.kicad_sch]
2022-07-09 Redo schematic
    [CPU6.kicad_sch]
2022-08-01 99.9% traces; functional image
    [CPU6.kicad_sch]
2023-11-11 CPU5 schematics
    [CPU5PA.kicad_pcb, CPU5PA.kicad_sch, CPU5SA.kicad_pcb, CPU5SA.kicad_sch, CPU6.kicad_pcb, CPU6.kicad_sch]
2023-11-11 Corrections from CPU5 reverse engineering
    [CPU6.kicad_sch]
2023-11-17 CPU5 reorg
    [CPU5PA.kicad_pcb, CPU5PA.kicad_sch, CPU5SA.kicad_pcb, CPU5SA.kicad_sch]
2023-12-05 Trace separation adjustment
    [CPU5PA.kicad_pcb]
2023-12-06 Trace tidyup and SRAM breakout
    [CPU5SA.kicad_pcb, CPUBR.kicad_pcb, CPUBR.kicad_sch]
2025-12-30 CPU5 revision
    [CPU5PA.kicad_pcb, CPU5SA.kicad_pcb]
